qyxbs/smart-library-return-system/7-项目文档/README.md

# 项目文档

> 说明：`report_data.json` 与 `generate_diagrams.py` 是 2026-07 技术报告的快照/生成脚本，其中的技术栈描述反映当时实现；当前主控为 C++ 实现（见 `1-RK3566-主控/cpp/`）。

## 文档索引

| 文档 | 说明 |
|---|---|
| `系统架构说明.md` | 三芯异构边端协同架构、软件分层、数据流设计 |
| `通信协议规范.md` | K230 ↔ RK3566 ↔ STM32 全链路文本行协议、CRC4 校验、坐标映射 |
| `部署指南.md` | 硬件接线、供电架构、软件部署步骤、启动顺序、验证方法 |

## 辅助工具

| 文件 | 说明 |
|---|---|
| `generate_diagrams.py` | SVG 架构图生成脚本 |
| `report_builder.py` | 技术报告自动构建工具（基于 report_data.json） |
| `report_data.json` | 技术报告数据文件 |

## 系统架构速览

```
┌──────────────┐     TCP :9998      ┌──────────────┐     TCP :9999      ┌──────────────┐
│  K230 #1     │ ──── QR 扫码 ────▶ │   RK3566     │ ──── 坐标指令 ──▶ │  K230 #2     │
│  RT-Smart    │                    │   Linux      │                    │  RT-Smart    │
└──────────────┘                    │ C++ HTTP 服务 │                    └──────┬───────┘
                                    │   SQLite     │                    UART2 │
                                    └──────┬───────┘                    STM32 │
                                    UART4/5│                                  │
                                           ▼                                  ▼
                                   ┌──────────────┐    Zigbee     ┌──────────────────┐
                                   │ STM32F407    │ ────广播────▶ │ STM32F103 ×3     │
                                   │ RT-Thread    │               │ RT-Thread        │
                                   │ 主控         │               │ 推书/机械爪/三轴   │
                                   └──────────────┘               └──────────────────┘
```

**三芯异构**：RK3566 (Linux, AI 推理) + K230 ×2 (RT-Smart, 视觉感知) + STM32 ×4 (RT-Thread, 实时控制)

**语音链路**：本地 SenseVoice ASR + 云端 DeepSeek 提取书名/分类；未命中时降级为关键词规则

**分布式控制**：Zigbee 广播 + RS485 总线，7 路步进电机，硬实时毫秒级响应
