qyxbs/smart-library-return-system/6-硬件设计/README.md

# 硬件设计

## 机械结构 (`机械/`)

138 个 SolidWorks 建模文件，按设计迭代日期组织（5月18日 — 7月7日），覆盖 34 个设计节点。

### 文件格式

| 格式 | 用途 |
|---|---|
| `.SLDPRT` | SolidWorks 零件文件 |
| `.SLDASM` | SolidWorks 装配体文件 |
| `.STEP` | 通用 CAD 交换格式（推荐外部查看） |
| `.3mf` / `.STL` | 3D 打印格式 |

### 主要部件

| 部件 | 覆盖日期 | 说明 |
|---|---|---|
| 书架结构 | 5月18日 — 6月30日 | 琴立式书架、挡板、支撑件、防乱跑结构 |
| 推书装置 | 5月25日 — 6月11日 | 推书机构、舵机改直线齿轮 |
| 机械爪/夹子 | 5月18日 — 6月29日 | 夹子限位、电机壳、舵机固定 |
| 三轴运动 | 6月23日 — 6月26日 | 左右横移电机、水平移电机壳、双支撑 |
| K230 外壳 | 5月31日 — 6月23日 | K230 盖子、三鹿保护壳、夹子壳 |
| RK3566 外壳 | 6月28日 | Linux 壳子、芯片固定 |
| 屏幕壳 | 5月21日 — 6月15日 | 屏幕外壳多版迭代 |
| 扫码结构 | 6月26日 — 7月1日 | 扫码方框挡板、扫码板子 |
| 打印机/红外 | 7月2日 — 7月3日 | 打印机支架、红外壳、信号挡板 |
| 其他 | 5月19日 — 7月3日 | 弹簧、圆环、Zigbee 支撑、收纳、垫片 |

### 查看方式

推荐使用以下免费工具查看 `.STEP` 文件：
- [FreeCAD](https://www.freecad.org/)
- [eDrawings Viewer](https://www.edrawingsviewer.com/)
- [Autodesk Viewer](https://viewer.autodesk.com/) (在线)

`.SLDPRT` / `.SLDASM` 文件需 SolidWorks 2022+ 打开。

## 电路设计 (`电路/`)

电路设计文件（原理图、PCB、接线图）正在整理中。

### 供电架构

```
220V AC → 200W 变压器 → 12V DC
  → 各电路板隔离电源
  → RK3566 (USB-C 5V)
  → K230 ×2 (USB-C 5V)
  → USB 有源 Hub (外接 5V 供电)
```

### 关键注意事项

- USB 有源 Hub 必须外接 5V 供电，否则 WiFi 高负载时电压跌落会导致系统复位
- 无线串口模块用于 RK3566 ↔ STM32 通信，替代有线连接
- CC2530 Zigbee 模块实现 STM32 主控与子控间的无线广播

## 相关文档

- 部署指南中的接线说明：`../7-项目文档/部署指南.md`
- 通信协议中的 UART 引脚分配：`../7-项目文档/通信协议规范.md`
