qyxbs/smart-library-return-system/6-硬件设计/机械/5月18/零件5^科技挡板.STEP

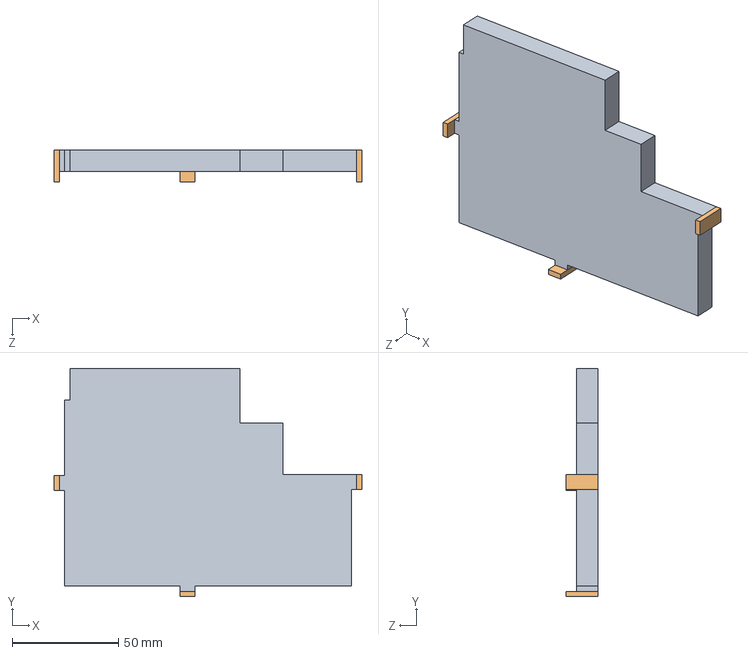
[picture p8: CAD file, 2026-07-08]
6-硬件设计/机械/5月18/零件5^科技挡板.STEP
145.0 x 107.5 x 15.0 mm
