qyxbs/smart-library-return-system/6-硬件设计/机械/5月19号/弹簧.STEP

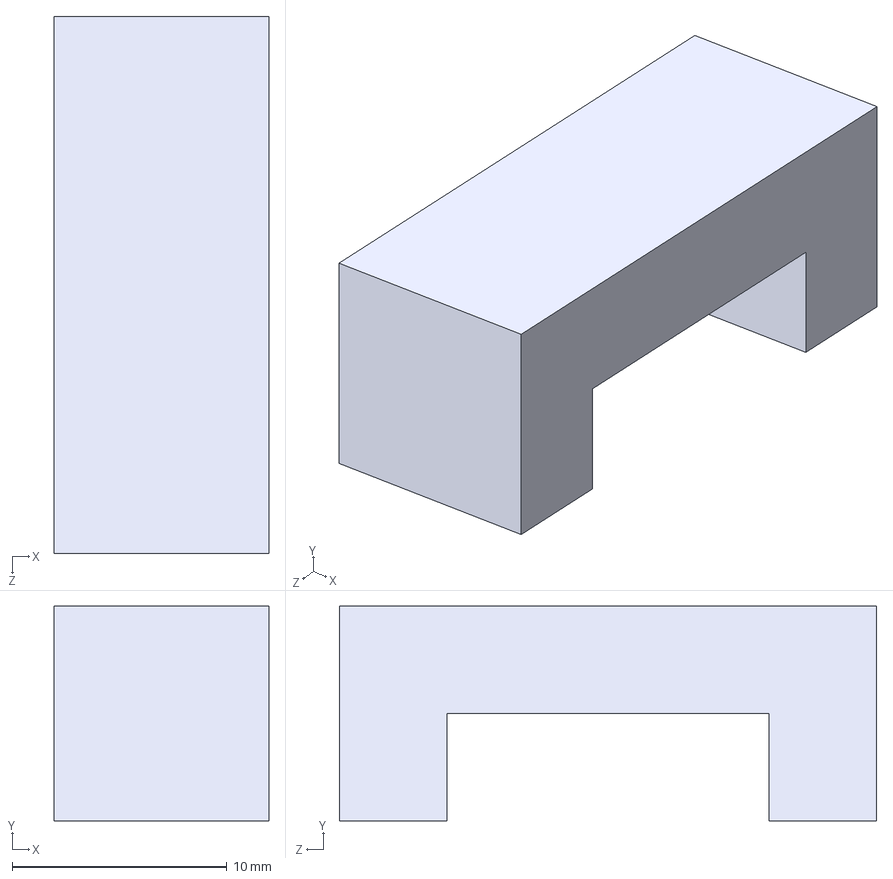
[picture p9: CAD file, 2026-07-08]
6-硬件设计/机械/5月19号/弹簧.STEP
10.0 x 10.00 x 25.0 mm
