qyxbs/smart-library-return-system/6-硬件设计/机械/5月21日/圆环.STEP

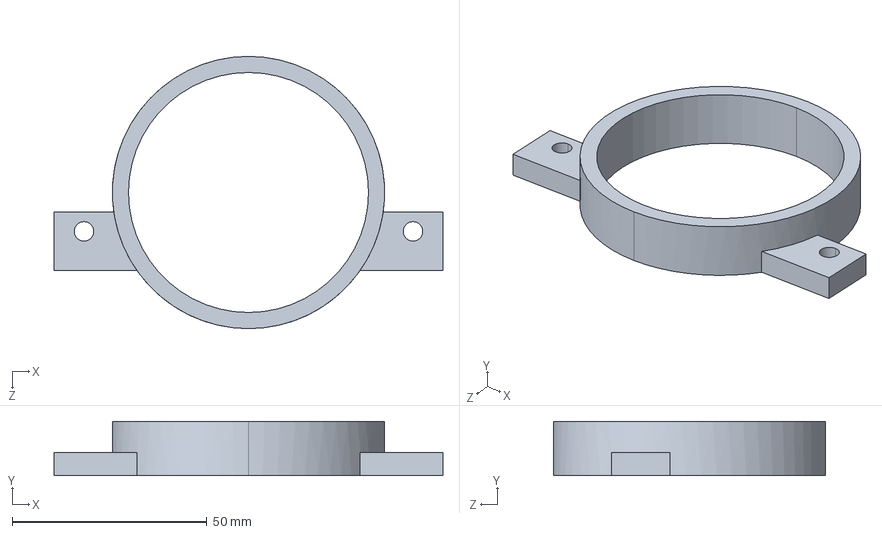
[picture p10: CAD file, 2026-07-08]
6-硬件设计/机械/5月21日/圆环.STEP
100.0 x 14.0 x 70.0 mm
