qyxbs/smart-library-return-system/6-硬件设计/机械/5月22日/将总的主子.STEP

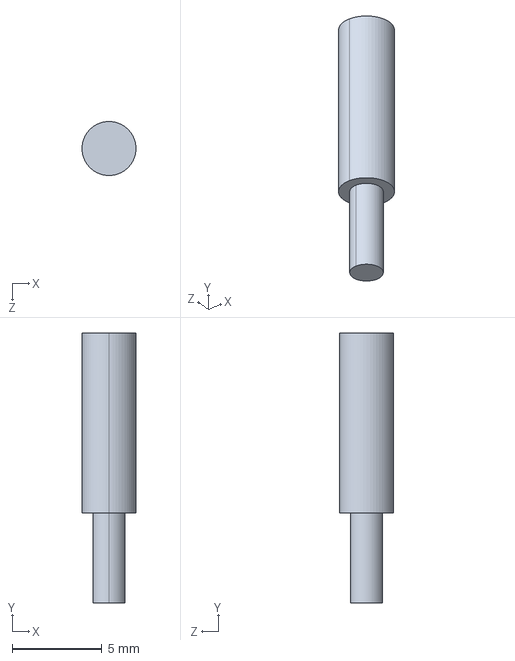
[picture p11: CAD file, 2026-07-08]
6-硬件设计/机械/5月22日/将总的主子.STEP
3.00 x 15.0 x 3.00 mm
