qyxbs/smart-library-return-system/6-硬件设计/机械/5月25日/零件1.SLDPRT

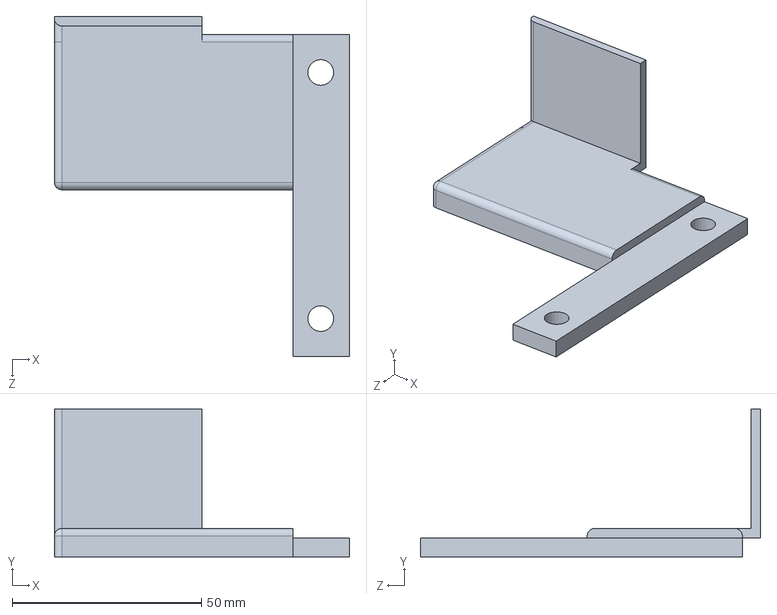
[picture p12: CAD file, 2026-07-08]
6-硬件设计/机械/5月25日/零件1.SLDPRT
78.0 x 39.0 x 89.8 mm
