qyxbs/smart-library-return-system/6-硬件设计/机械/5月27日/旁边的收纳.STEP

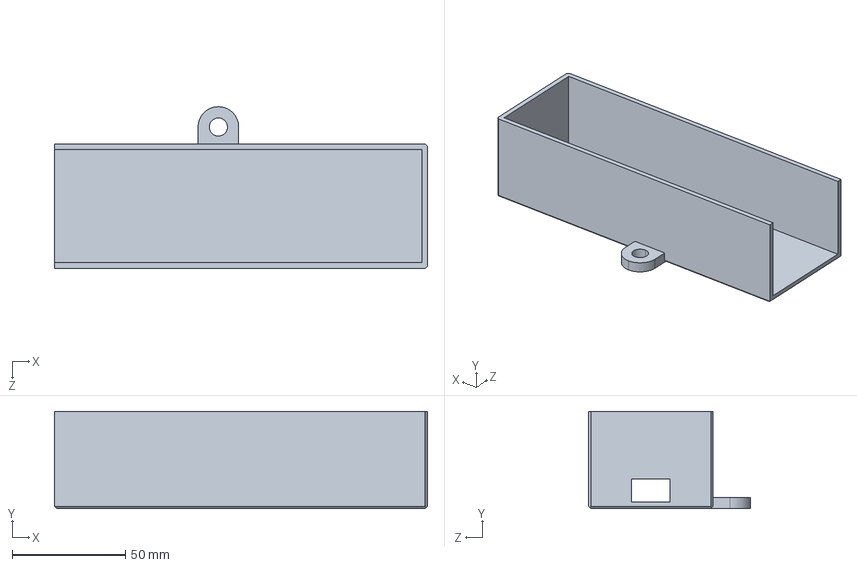
[picture p13: CAD file, 2026-07-08]
6-硬件设计/机械/5月27日/旁边的收纳.STEP
165.0 x 43.0 x 71.5 mm
