qyxbs/smart-library-return-system/6-硬件设计/机械/5月29日/零件5^科技挡板.STEP

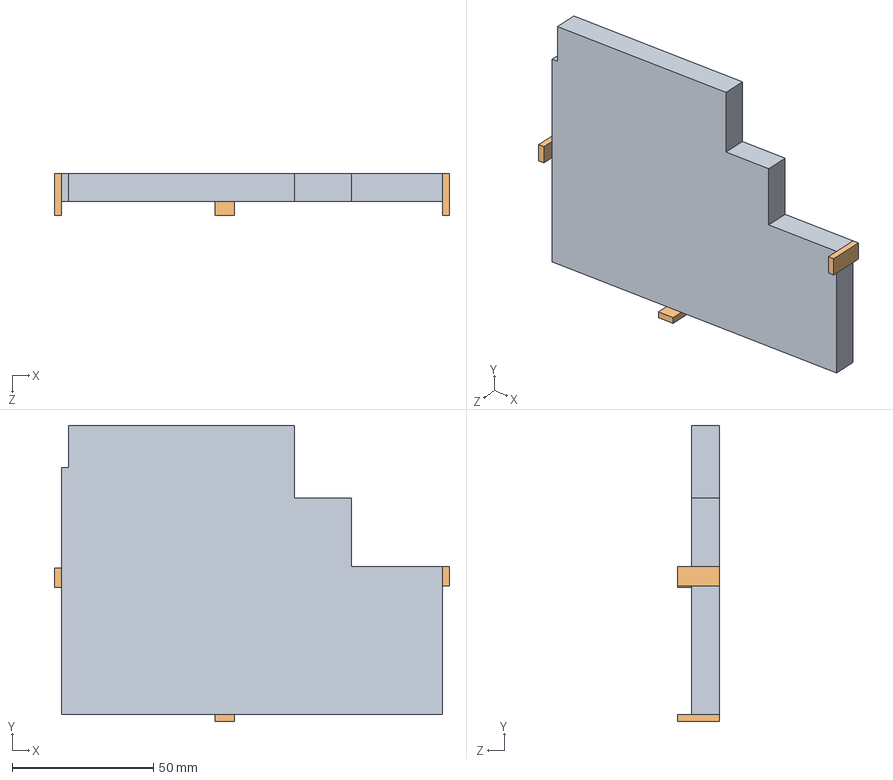
[picture p14: CAD file, 2026-07-08]
6-硬件设计/机械/5月29日/零件5^科技挡板.STEP
140.0 x 105.0 x 15.0 mm
