qyxbs/smart-library-return-system/6-硬件设计/机械/5月31日/k230盖子.STEP

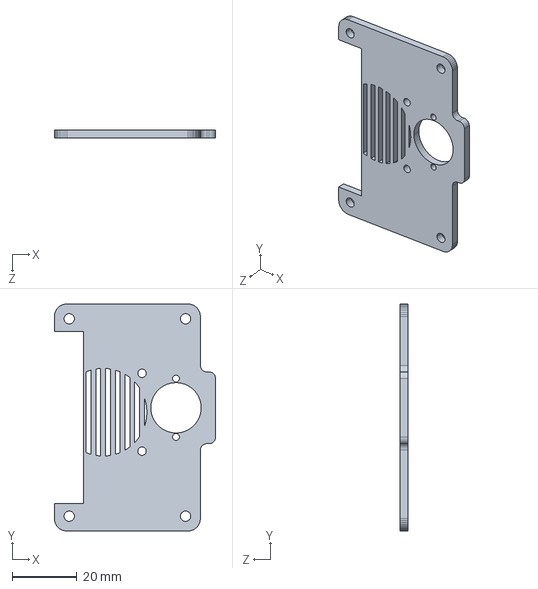
[picture p15: CAD file, 2026-07-08]
6-硬件设计/机械/5月31日/k230盖子.STEP
49.7 x 70.0 x 2.50 mm
