qyxbs/smart-library-return-system/6-硬件设计/机械/6月10号/6月10号.STEP

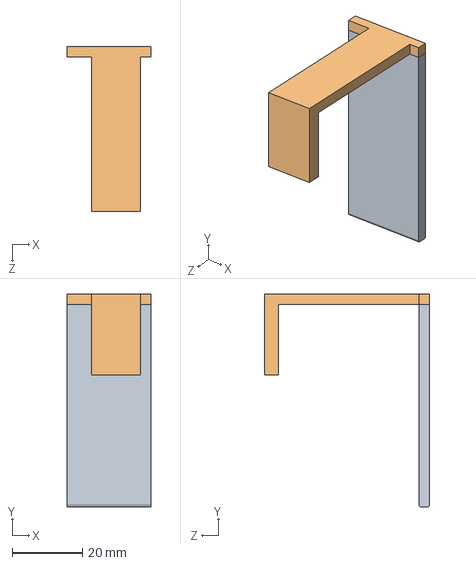
[picture p16: CAD file, 2026-07-08]
6-硬件设计/机械/6月10号/6月10号.STEP
24.0 x 60.7 x 47.1 mm
