qyxbs/smart-library-return-system/6-硬件设计/机械/6月11日/挡板.3mf

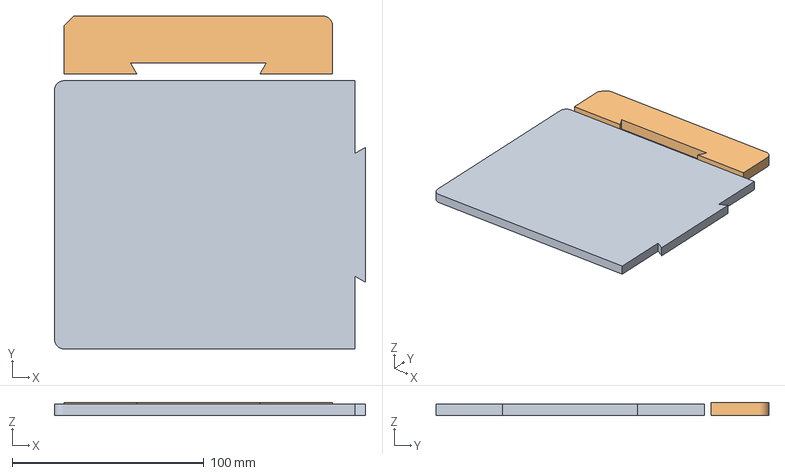
[picture p17: CAD file, 2026-07-08]
6-硬件设计/机械/6月11日/挡板.3mf
162.3 x 173.7 x 7.00 mm
挡板.STEP_A
挡板.STEP_B
