qyxbs/smart-library-return-system/6-硬件设计/机械/6月13日/雷达字.STEP

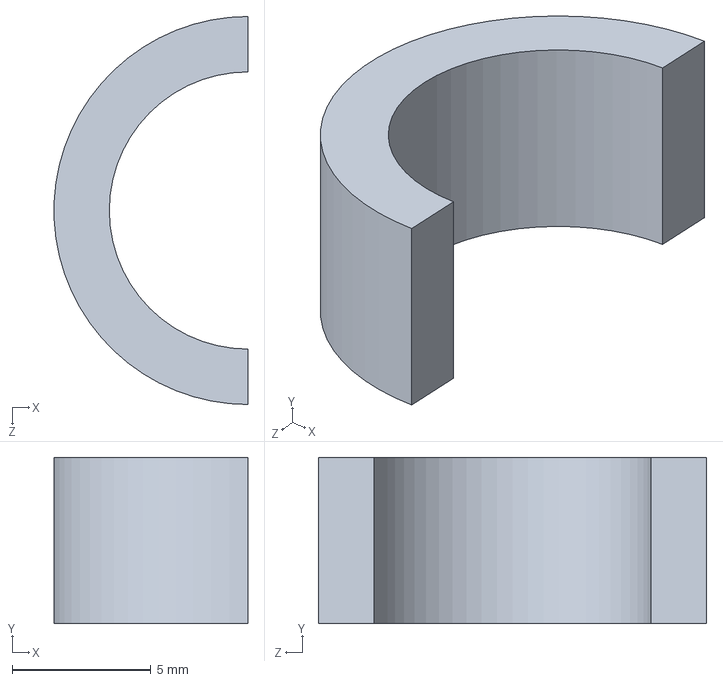
[picture p18: CAD file, 2026-07-08]
6-硬件设计/机械/6月13日/雷达字.STEP
6.99 x 6.00 x 14.0 mm
