qyxbs/smart-library-return-system/6-硬件设计/机械/6月15日/屏幕壳.STEP

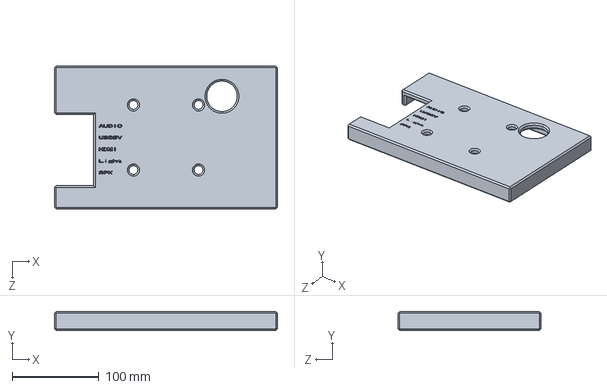
[picture p19: CAD file, 2026-07-08]
6-硬件设计/机械/6月15日/屏幕壳.STEP
257.0 x 22.0 x 165.0 mm
