qyxbs/smart-library-return-system/6-硬件设计/机械/6月16日/挡板.STEP

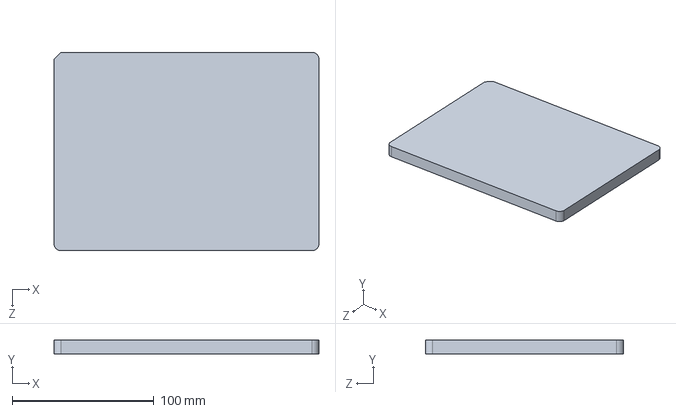
[picture p20: CAD file, 2026-07-08]
6-硬件设计/机械/6月16日/挡板.STEP
187.0 x 10.0 x 140.0 mm
