qyxbs/smart-library-return-system/6-硬件设计/机械/6月19日/零件2^三鹿保护壳.3mf

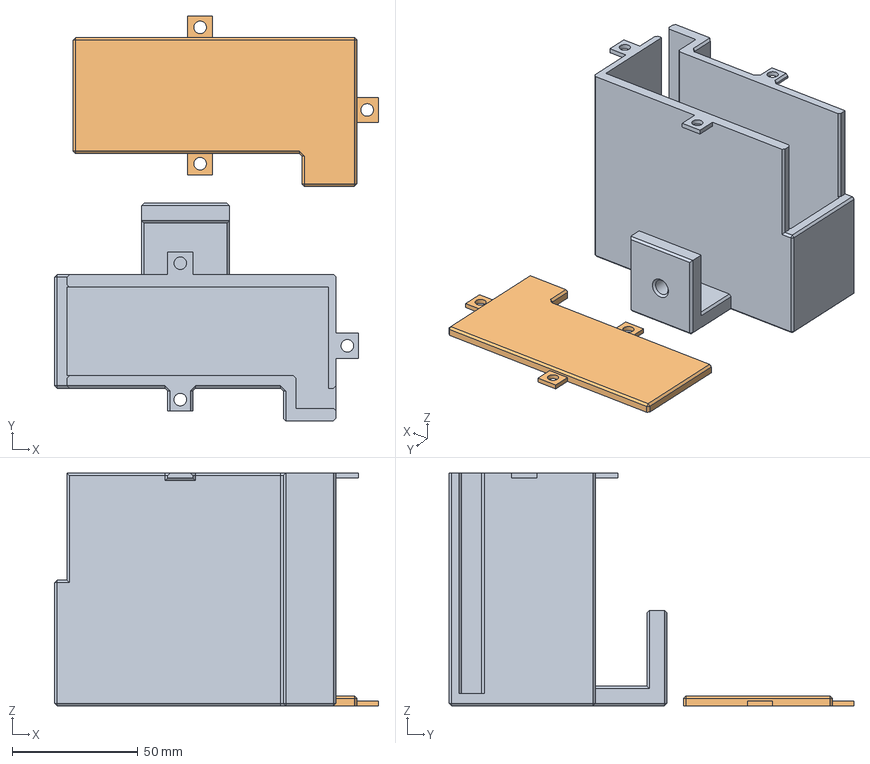
[picture p21: CAD file, 2026-07-08]
6-硬件设计/机械/6月19日/零件2^三鹿保护壳.3mf
128.9 x 161.1 x 92.6 mm
零件2^三鹿保护壳
零件4^三鹿保护壳
