qyxbs/smart-library-return-system/6-硬件设计/机械/6月1日/舵机改直线下齿轮1.STEP

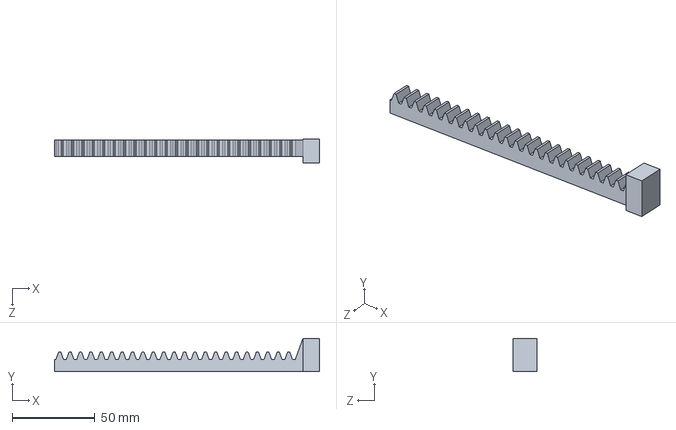
[picture p22: CAD file, 2026-07-08]
6-硬件设计/机械/6月1日/舵机改直线下齿轮1.STEP
160.0 x 20.2 x 14.5 mm
