qyxbs/smart-library-return-system/6-硬件设计/机械/6月20日/电机壳.STEP

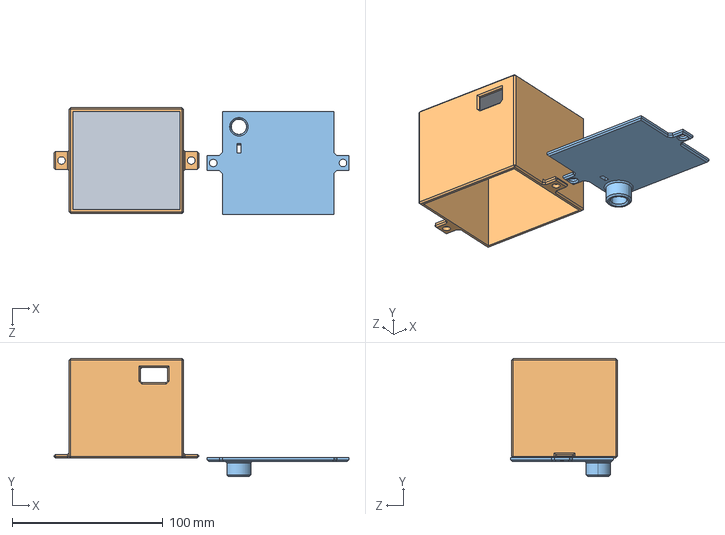
[picture p23: CAD file, 2026-07-08]
6-硬件设计/机械/6月20日/电机壳.STEP
195.6 x 78.2 x 70.6 mm
电机壳
零件1^电机壳
