qyxbs/smart-library-return-system/6-硬件设计/机械/6月22日/三鹿夹子壳.STEP

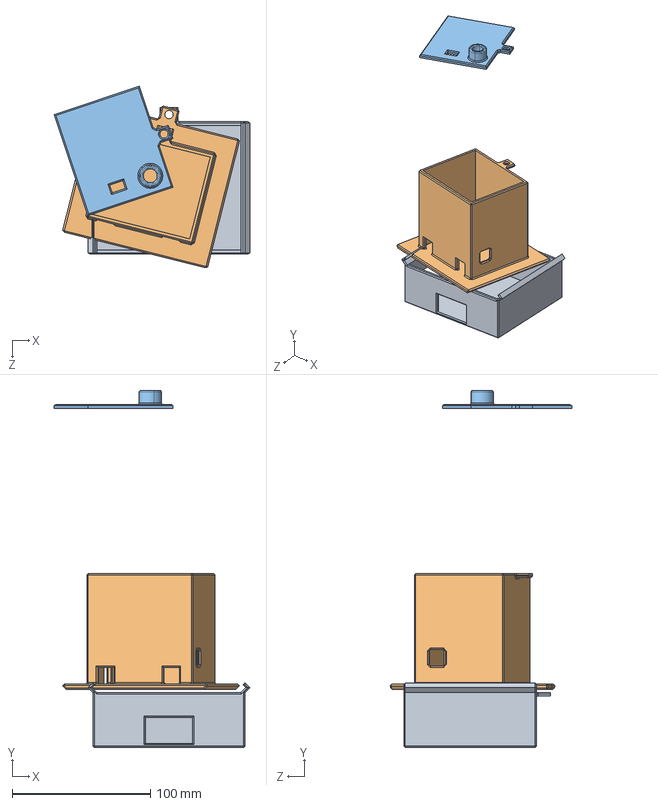
[picture p24: CAD file, 2026-07-08]
6-硬件设计/机械/6月22日/三鹿夹子壳.STEP
141.6 x 258.3 x 131.4 mm
零件2^三鹿夹子壳
零件3^三鹿夹子壳
零件4^三鹿夹子壳
