qyxbs/smart-library-return-system/6-硬件设计/机械/6月24日/双支持.STEP

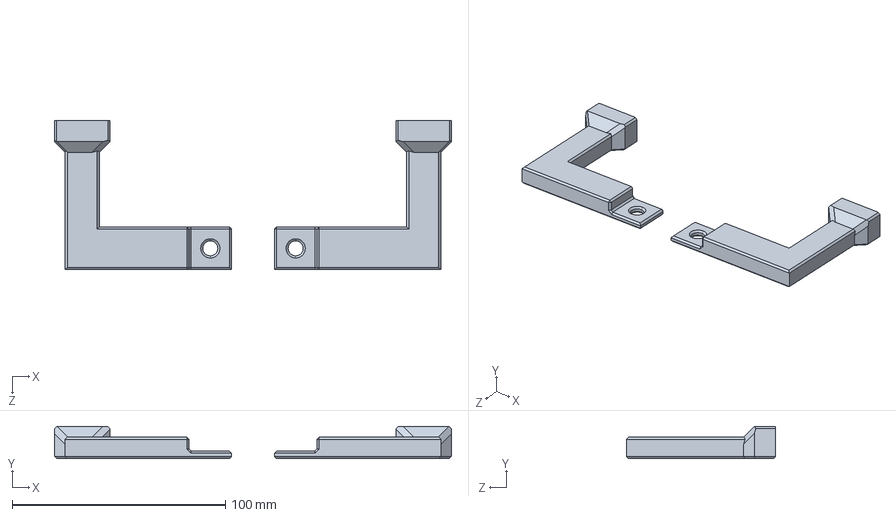
[picture p25: CAD file, 2026-07-08]
6-硬件设计/机械/6月24日/双支持.STEP
186.0 x 15.0 x 70.0 mm
支撑电机
Mirror支撑电机
