qyxbs/smart-library-return-system/6-硬件设计/机械/6月25日/左右横移电机.SLDPRT

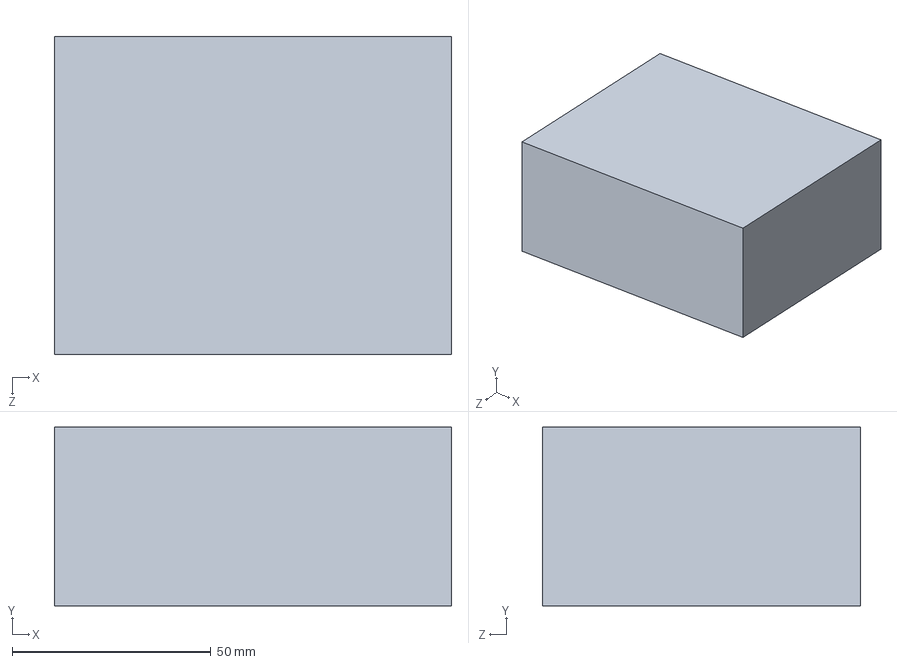
[picture p26: CAD file, 2026-07-08]
6-硬件设计/机械/6月25日/左右横移电机.SLDPRT
100.0 x 45.0 x 80.0 mm
