qyxbs/smart-library-return-system/6-硬件设计/机械/6月26日/left and right.STEP

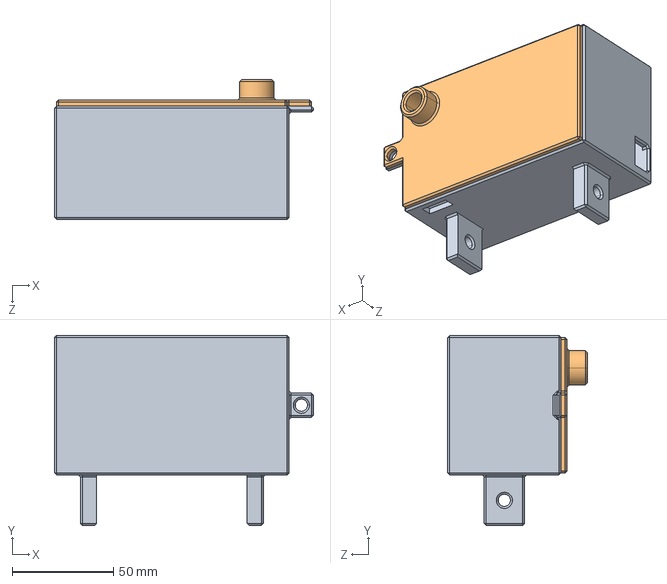
[picture p27: CAD file, 2026-07-08]
6-硬件设计/机械/6月26日/left and right.STEP
128.0 x 94.0 x 69.0 mm
零件3^left and right
零件4^left and right
