qyxbs/smart-library-return-system/6-硬件设计/机械/6月27日/固定.STEP

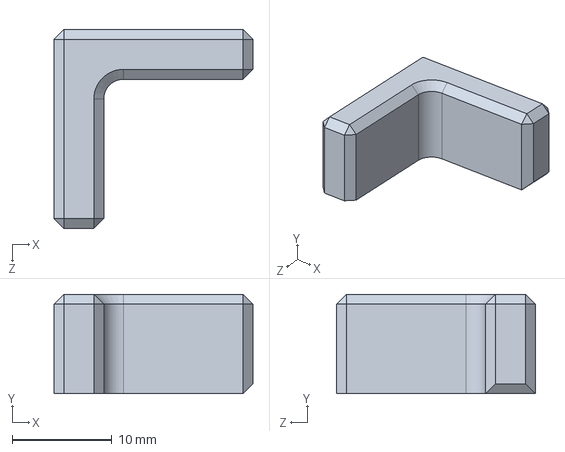
[picture p28: CAD file, 2026-07-08]
6-硬件设计/机械/6月27日/固定.STEP
20.0 x 10.0 x 20.0 mm
