qyxbs/smart-library-return-system/6-硬件设计/机械/6月28日/芯片.SLDPRT

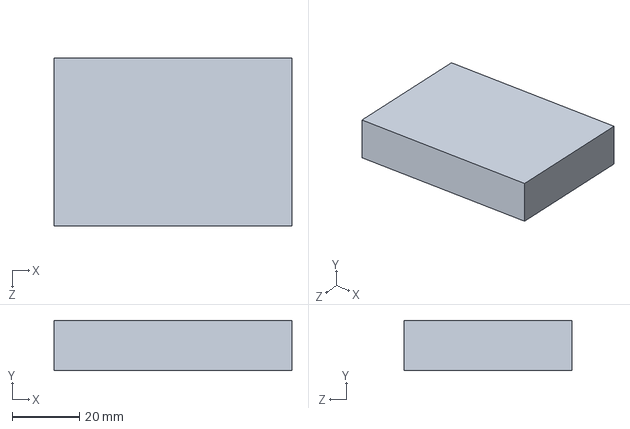
[picture p29: CAD file, 2026-07-08]
6-硬件设计/机械/6月28日/芯片.SLDPRT
71.0 x 15.0 x 50.0 mm
