qyxbs/smart-library-return-system/6-硬件设计/机械/6月29日/垫片.STEP

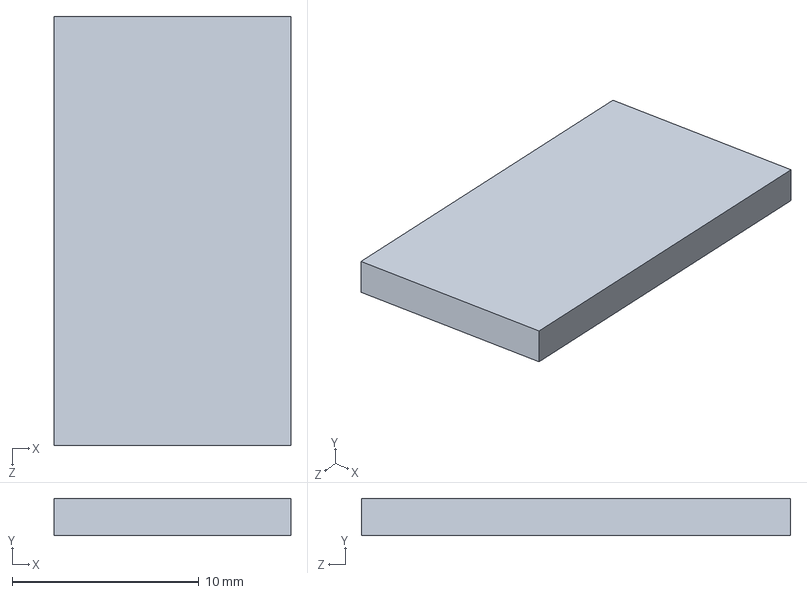
[picture p30: CAD file, 2026-07-08]
6-硬件设计/机械/6月29日/垫片.STEP
12.7 x 2.00 x 23.0 mm
