qyxbs/smart-library-return-system/6-硬件设计/机械/6月30日/书架防乱跑.STEP

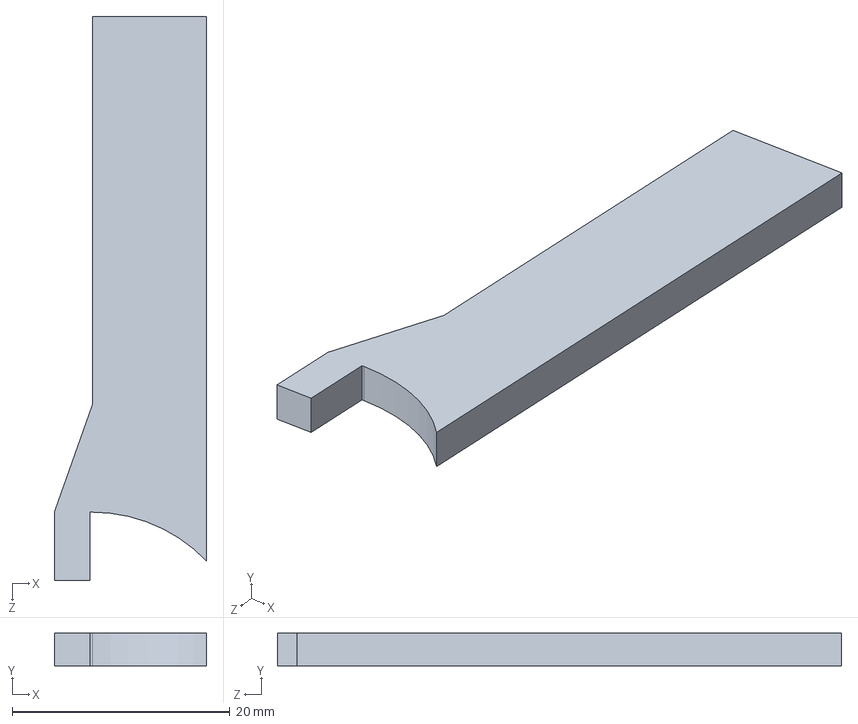
[picture p31: CAD file, 2026-07-08]
6-硬件设计/机械/6月30日/书架防乱跑.STEP
14.0 x 3.00 x 51.8 mm
