qyxbs/smart-library-return-system/6-硬件设计/机械/6月4日/zigbee支撑.STEP

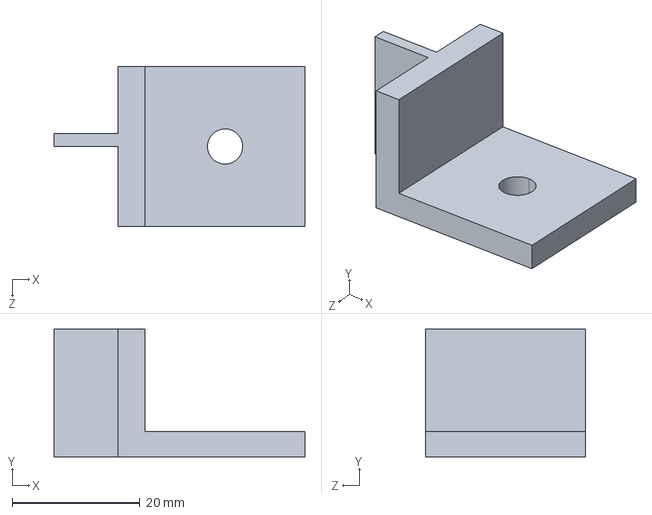
[picture p32: CAD file, 2026-07-08]
6-硬件设计/机械/6月4日/zigbee支撑.STEP
39.2 x 20.0 x 25.0 mm
