qyxbs/smart-library-return-system/6-硬件设计/机械/6月5日/挡板.STEP

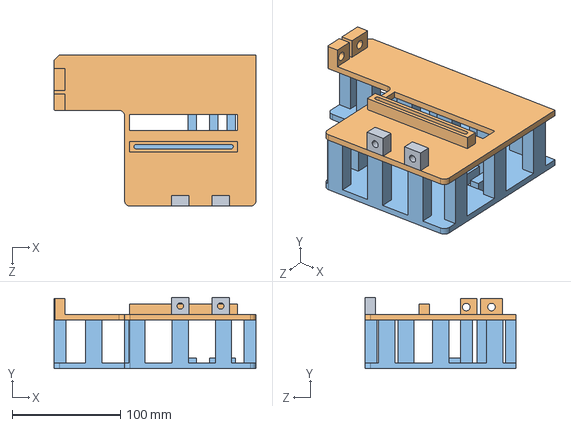
[picture p33: CAD file, 2026-07-08]
6-硬件设计/机械/6月5日/挡板.STEP
187.0 x 66.0 x 140.0 mm
挡板plus
零件4^挡板
