qyxbs/smart-library-return-system/6-硬件设计/机械/6月6日/挡板.STEP

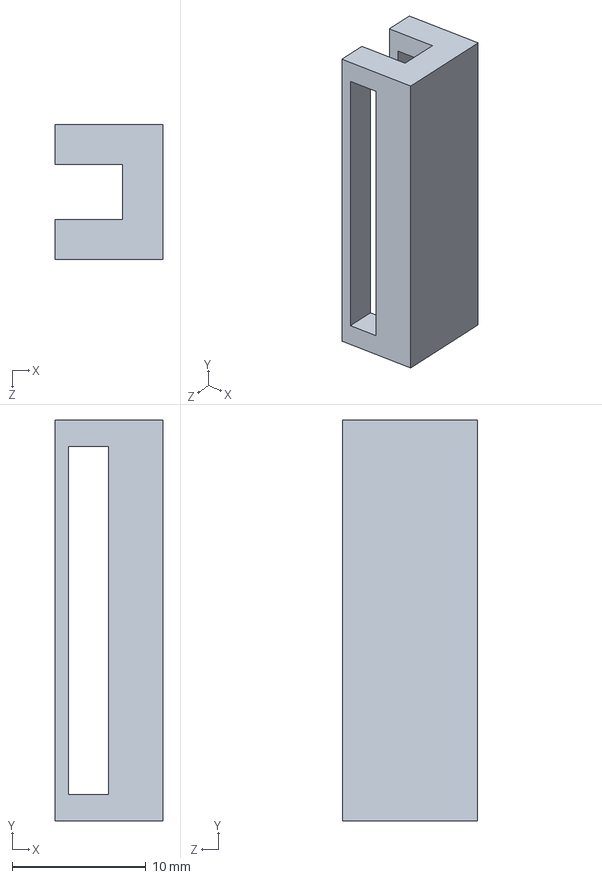
[picture p34: CAD file, 2026-07-08]
6-硬件设计/机械/6月6日/挡板.STEP
8.05 x 30.0 x 10.1 mm
