qyxbs/smart-library-return-system/6-硬件设计/机械/7月1日/扫码板子.SLDPRT

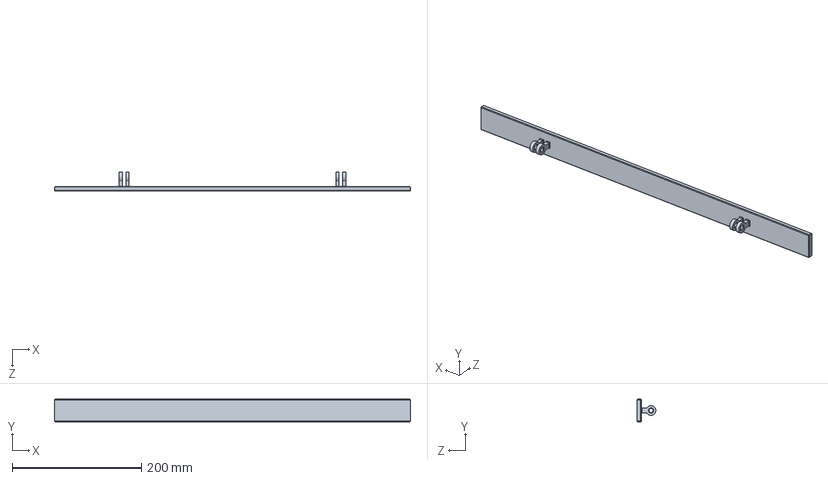
[picture p35: CAD file, 2026-07-08]
6-硬件设计/机械/7月1日/扫码板子.SLDPRT
550.0 x 35.0 x 29.0 mm
