qyxbs/smart-library-return-system/6-硬件设计/机械/7月2日/零件2.STEP

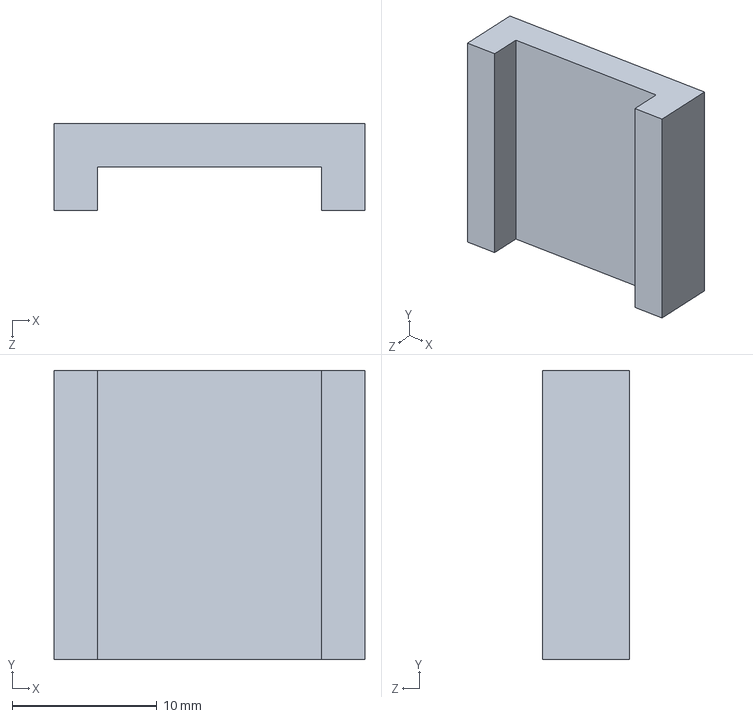
[picture p36: CAD file, 2026-07-08]
6-硬件设计/机械/7月2日/零件2.STEP
21.5 x 20.0 x 6.00 mm
