qyxbs/smart-library-return-system/6-硬件设计/机械/7月3日/打印机.STEP

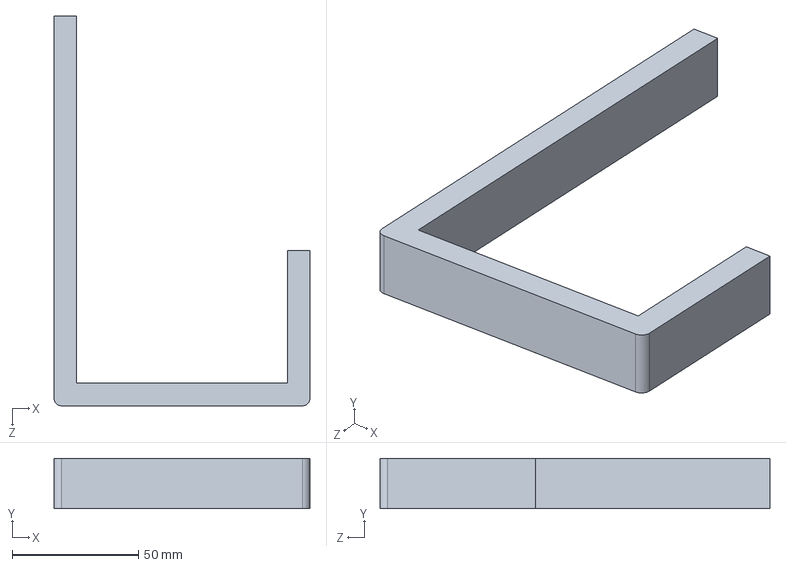
[picture p37: CAD file, 2026-07-08]
6-硬件设计/机械/7月3日/打印机.STEP
101.5 x 20.0 x 154.5 mm
