qyxbs/smart-library-return-system/6-硬件设计/机械/7月7日/斜支撑.STEP

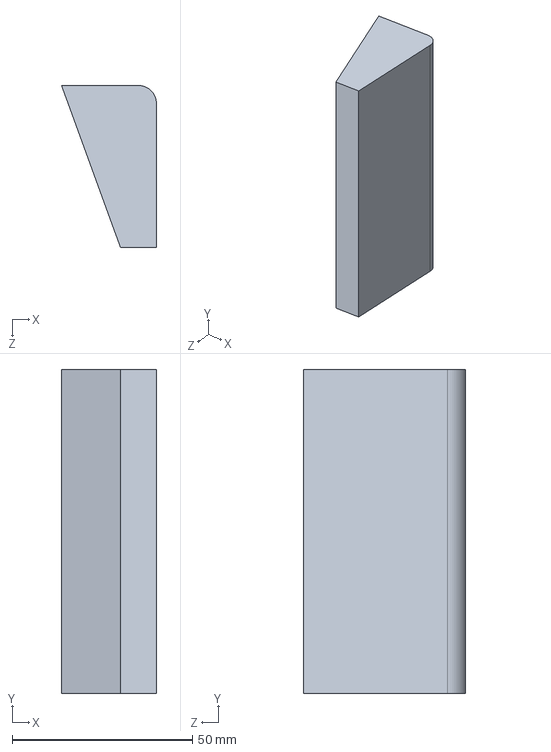
[picture p38: CAD file, 2026-07-08]
6-硬件设计/机械/7月7日/斜支撑.STEP
26.4 x 90.0 x 45.0 mm
