qyxbs/smart-library-return-system/6-硬件设计/机械/5月18/下面挡板第二个.STEP

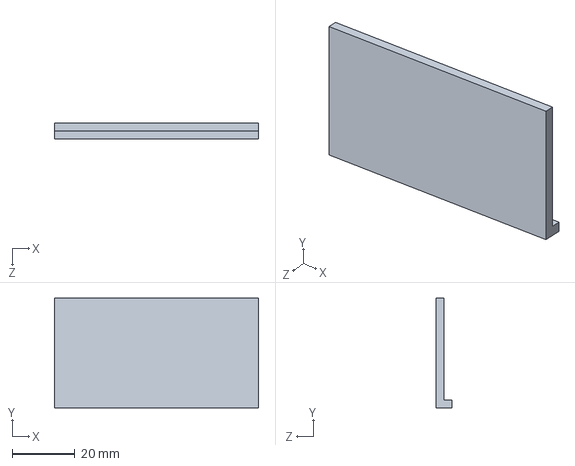
[picture p39: CAD file, 2026-07-08]
6-硬件设计/机械/5月18/下面挡板第二个.STEP
65.0 x 35.0 x 5.00 mm
