qyxbs/smart-library-return-system/6-硬件设计/机械/5月29日/圆环.STEP

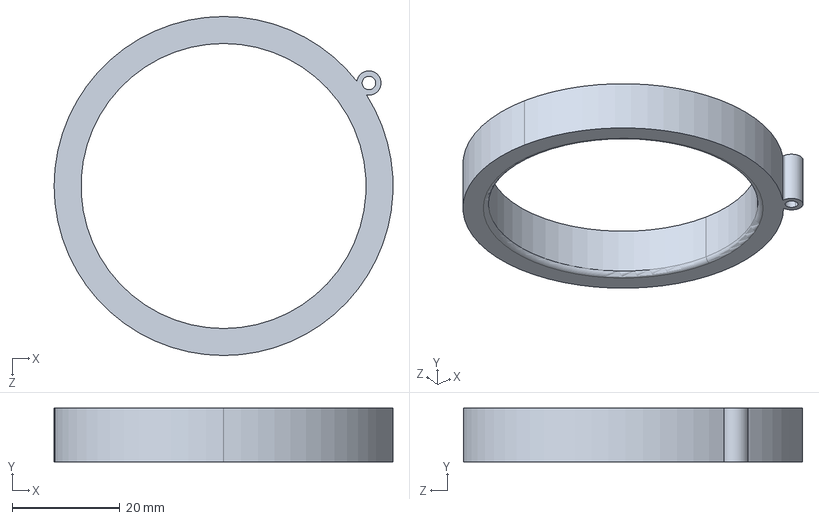
[picture p40: CAD file, 2026-07-08]
6-硬件设计/机械/5月29日/圆环.STEP
62.8 x 10.0 x 62.8 mm
