qyxbs/smart-library-return-system/6-硬件设计/机械/6月10号/摄像头.STEP

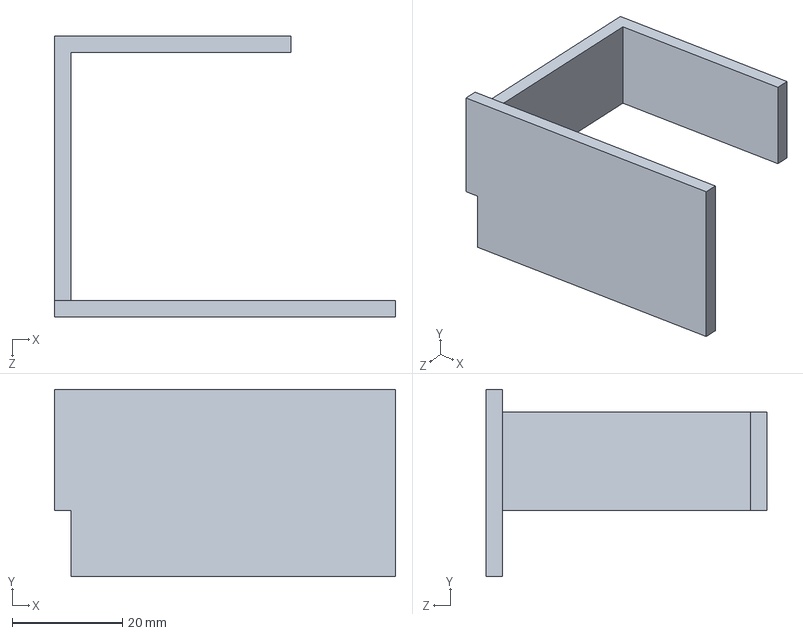
[picture p41: CAD file, 2026-07-08]
6-硬件设计/机械/6月10号/摄像头.STEP
62.0 x 34.0 x 51.0 mm
