qyxbs/smart-library-return-system/6-硬件设计/机械/6月11日/推书.STEP

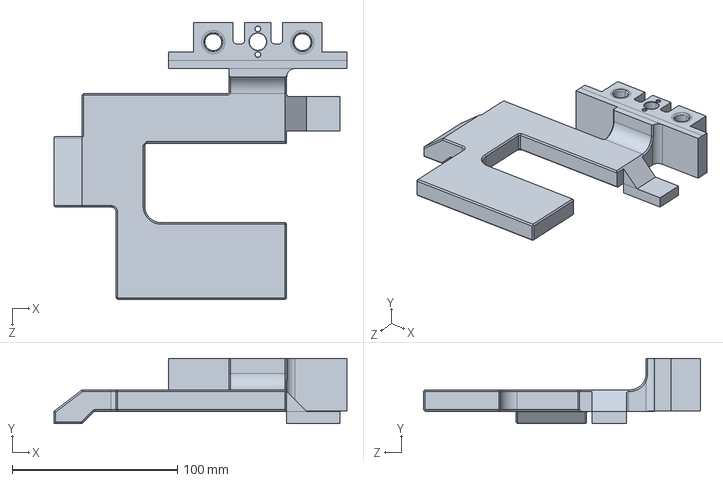
[picture p42: CAD file, 2026-07-08]
6-硬件设计/机械/6月11日/推书.STEP
177.5 x 39.6 x 168.0 mm
