qyxbs/smart-library-return-system/6-硬件设计/机械/6月13日/屏幕壳.3mf

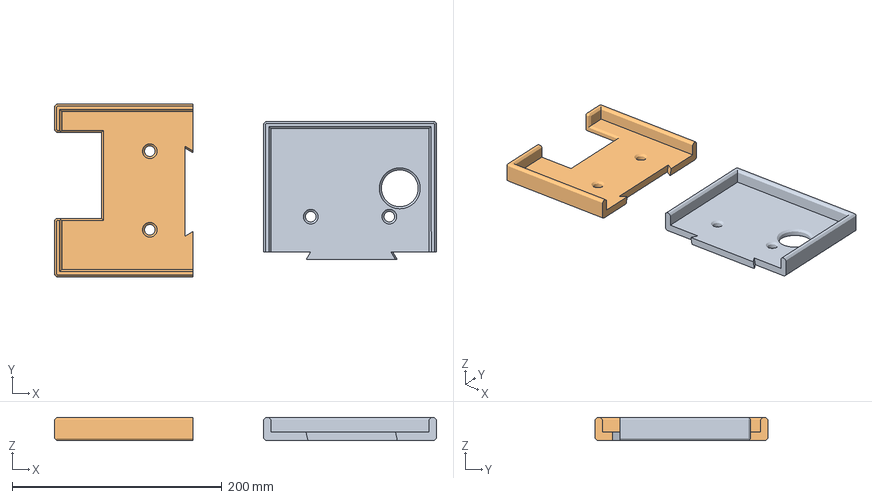
[picture p43: CAD file, 2026-07-08]
6-硬件设计/机械/6月13日/屏幕壳.3mf
364.6 x 165.0 x 22.0 mm
屏幕壳.STEP_A
屏幕壳.STEP_B
