qyxbs/smart-library-return-system/6-硬件设计/机械/6月19日/琴立式书架mvp版.3mf

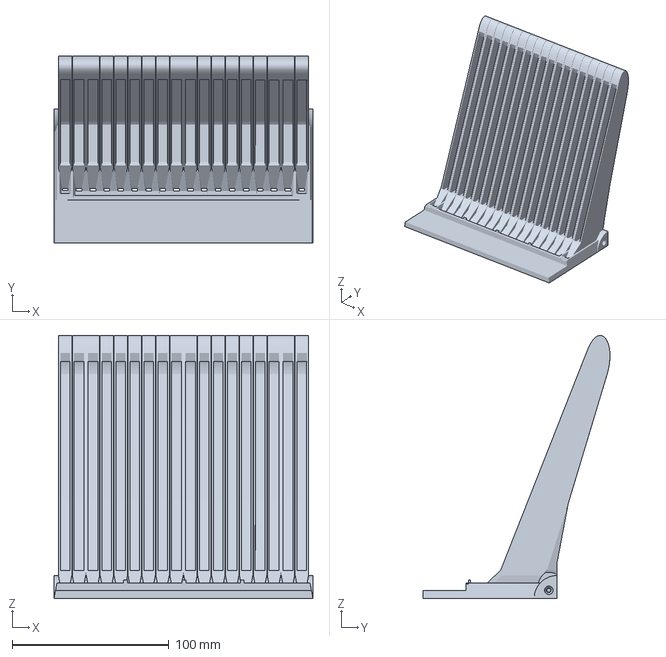
[picture p44: CAD file, 2026-07-08]
6-硬件设计/机械/6月19日/琴立式书架mvp版.3mf
165.5 x 119.5 x 168.1 mm
