qyxbs/smart-library-return-system/6-硬件设计/机械/6月20日/零件1^电机壳.3mf

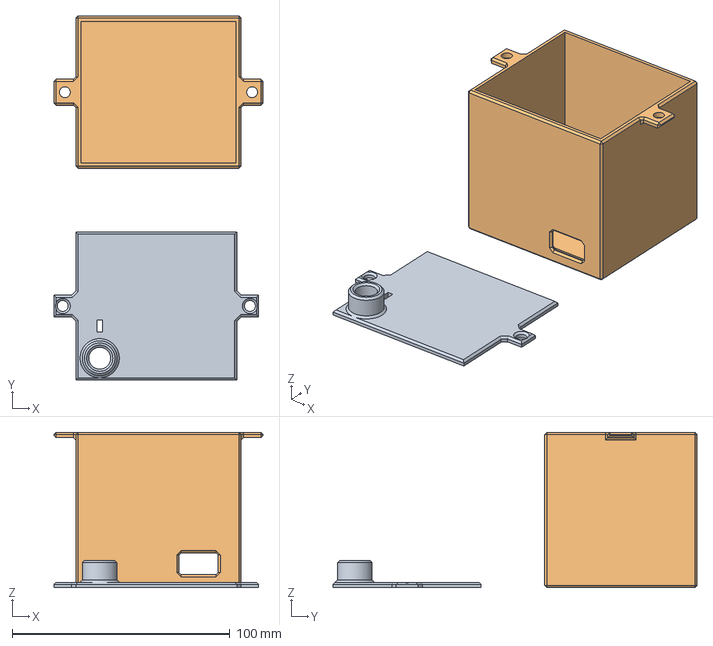
[picture p45: CAD file, 2026-07-08]
6-硬件设计/机械/6月20日/零件1^电机壳.3mf
96.0 x 167.2 x 71.4 mm
零件1^电机壳
组合体
