qyxbs/smart-library-return-system/6-硬件设计/机械/6月23日/电机固定七.STEP

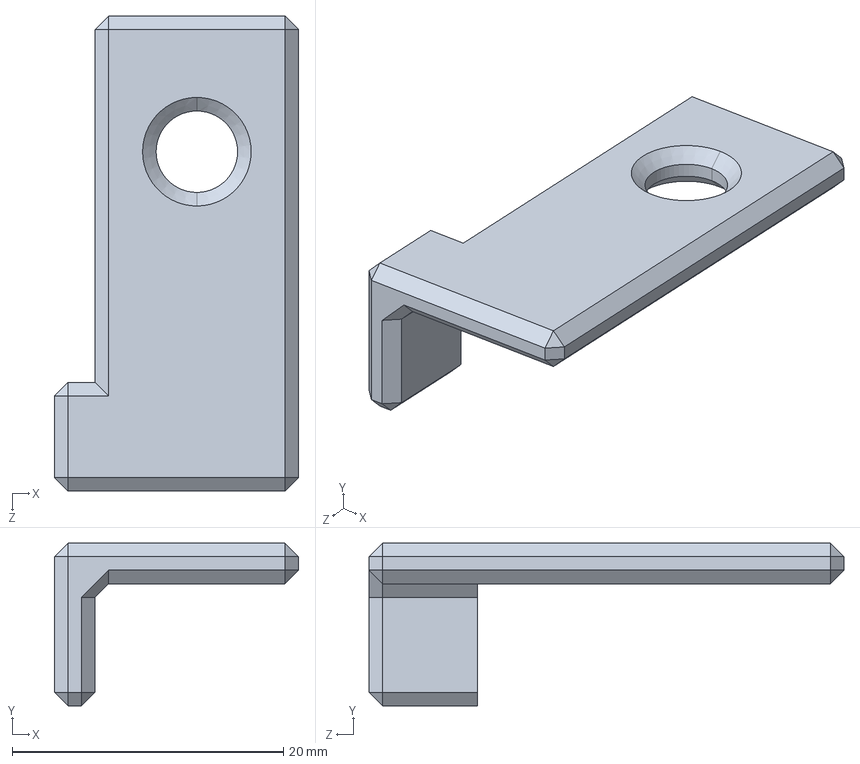
[picture p46: CAD file, 2026-07-08]
6-硬件设计/机械/6月23日/电机固定七.STEP
18.0 x 12.0 x 35.0 mm
