qyxbs/smart-library-return-system/6-硬件设计/机械/6月25日/电线卡口.STEP

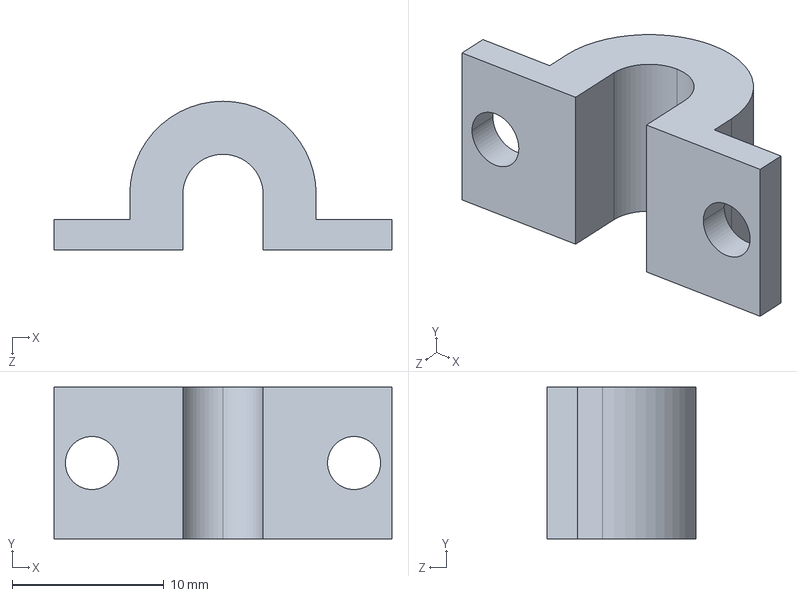
[picture p47: CAD file, 2026-07-08]
6-硬件设计/机械/6月25日/电线卡口.STEP
22.3 x 10.0 x 9.80 mm
