qyxbs/smart-library-return-system/6-硬件设计/机械/6月26日/零件3^left and right.STEP

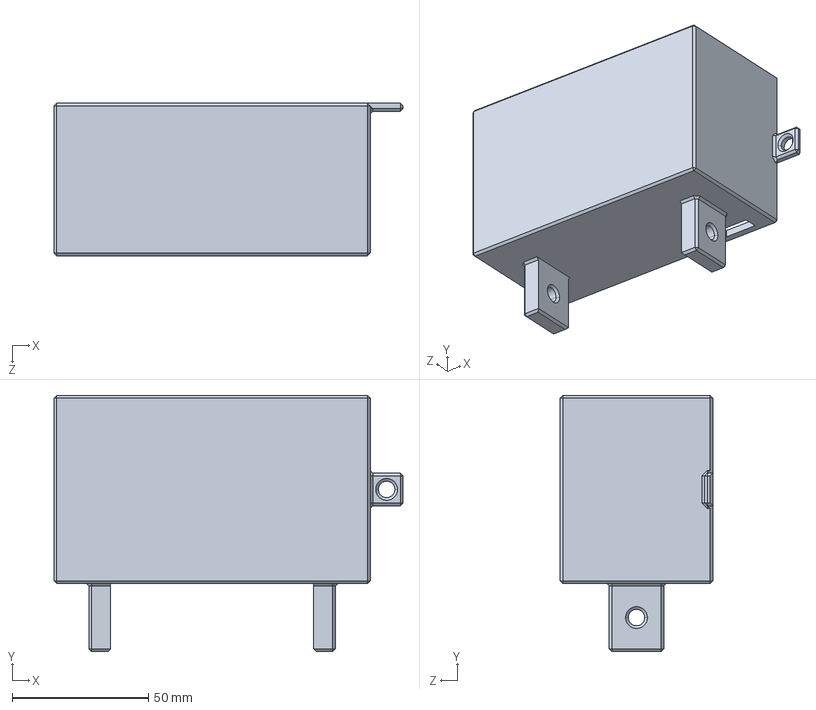
[picture p48: CAD file, 2026-07-08]
6-硬件设计/机械/6月26日/零件3^left and right.STEP
128.0 x 94.0 x 56.0 mm
