qyxbs/smart-library-return-system/6-硬件设计/机械/6月28日/linux壳子.STEP

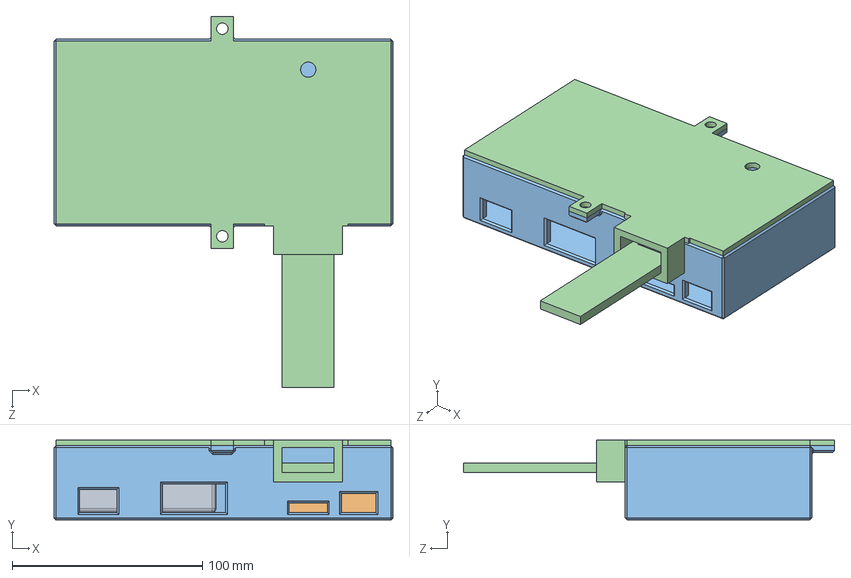
[picture p49: CAD file, 2026-07-08]
6-硬件设计/机械/6月28日/linux壳子.STEP
178.0 x 42.0 x 195.0 mm
黑色摄像头
芯片
零件3^linux壳子
零件4^linux壳子
