qyxbs/smart-library-return-system/6-硬件设计/机械/6月5日/上壳盖子.stl

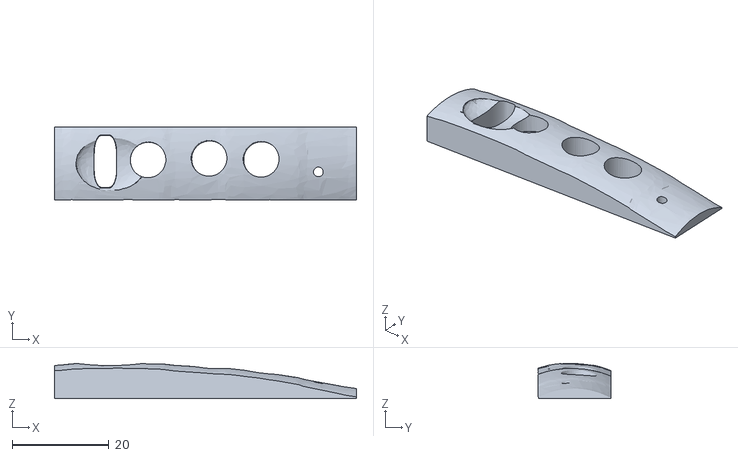
[picture p50: CAD file, 2026-07-08]
6-硬件设计/机械/6月5日/上壳盖子.stl
62.5 x 15.0 x 7.24
