qyxbs/smart-library-return-system/6-硬件设计/机械/7月1日/挡板梓赫梯.STEP

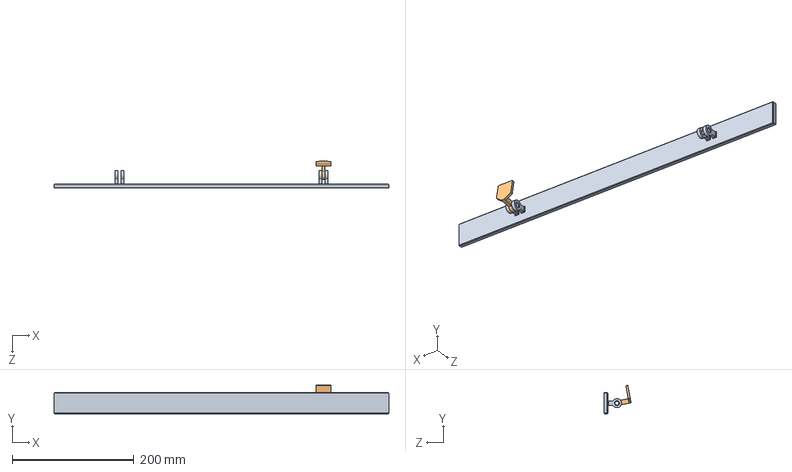
[picture p51: CAD file, 2026-07-08]
6-硬件设计/机械/7月1日/挡板梓赫梯.STEP
550.0 x 47.0 x 44.8 mm
扫码板子
零件2^挡板梓赫梯
