qyxbs/smart-library-return-system/6-硬件设计/机械/7月2日/信号挡板.STEP

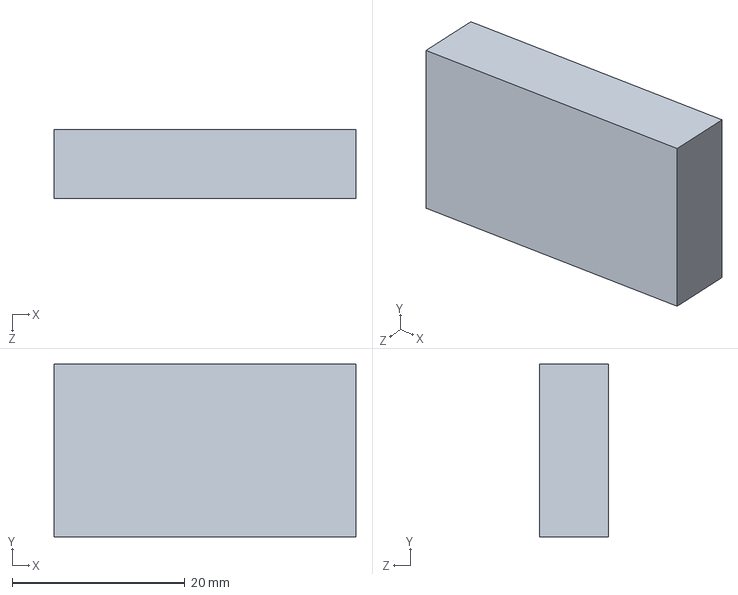
[picture p52: CAD file, 2026-07-08]
6-硬件设计/机械/7月2日/信号挡板.STEP
35.0 x 20.0 x 8.00 mm
