qyxbs/smart-library-return-system/6-硬件设计/机械/7月3日/板子红外.SLDPRT

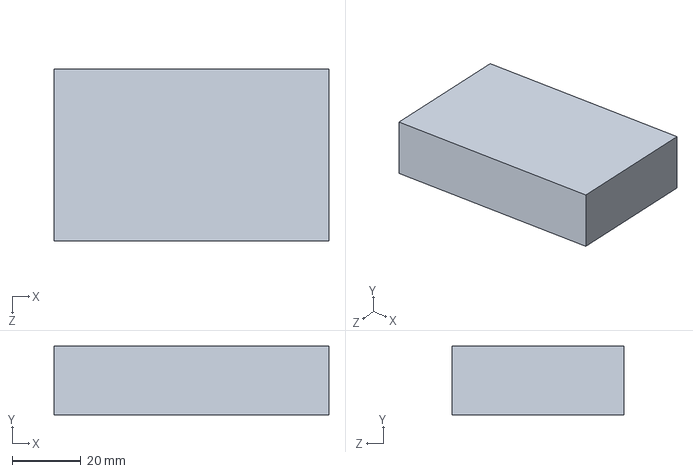
[picture p53: CAD file, 2026-07-08]
6-硬件设计/机械/7月3日/板子红外.SLDPRT
80.0 x 20.0 x 50.0 mm
