qyxbs/smart-library-return-system/6-硬件设计/机械/5月18/斜支撑.STEP

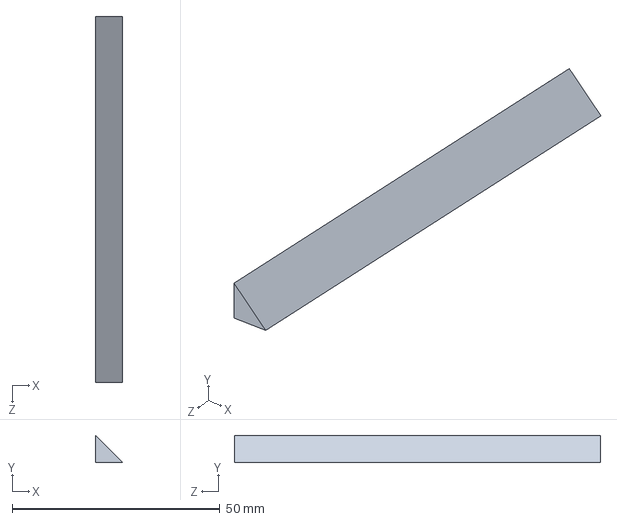
[picture p54: CAD file, 2026-07-08]
6-硬件设计/机械/5月18/斜支撑.STEP
6.50 x 6.50 x 88.0 mm
