qyxbs/smart-library-return-system/6-硬件设计/机械/5月21日/屏幕实体.SLDPRT

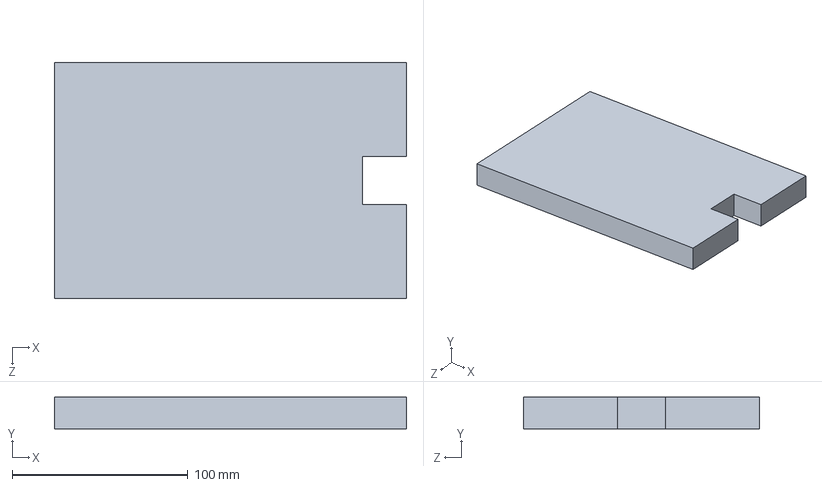
[picture p55: CAD file, 2026-07-08]
6-硬件设计/机械/5月21日/屏幕实体.SLDPRT
200.1 x 18.0 x 133.9 mm
