qyxbs/smart-library-return-system/6-硬件设计/机械/5月25日/舵机改直线下齿轮1.STEP

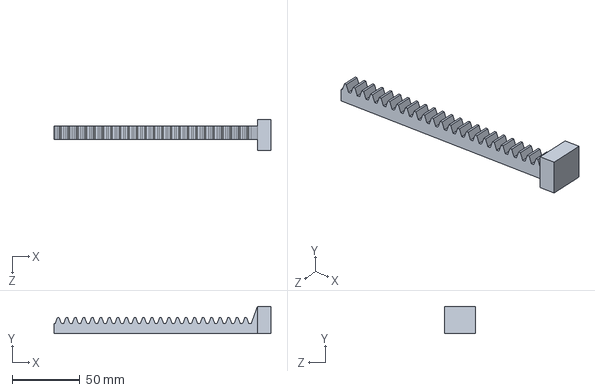
[picture p56: CAD file, 2026-07-08]
6-硬件设计/机械/5月25日/舵机改直线下齿轮1.STEP
160.0 x 20.2 x 23.0 mm
