qyxbs/smart-library-return-system/6-硬件设计/机械/6月11日/零件4^两侧侧电机壳上盖.3mf

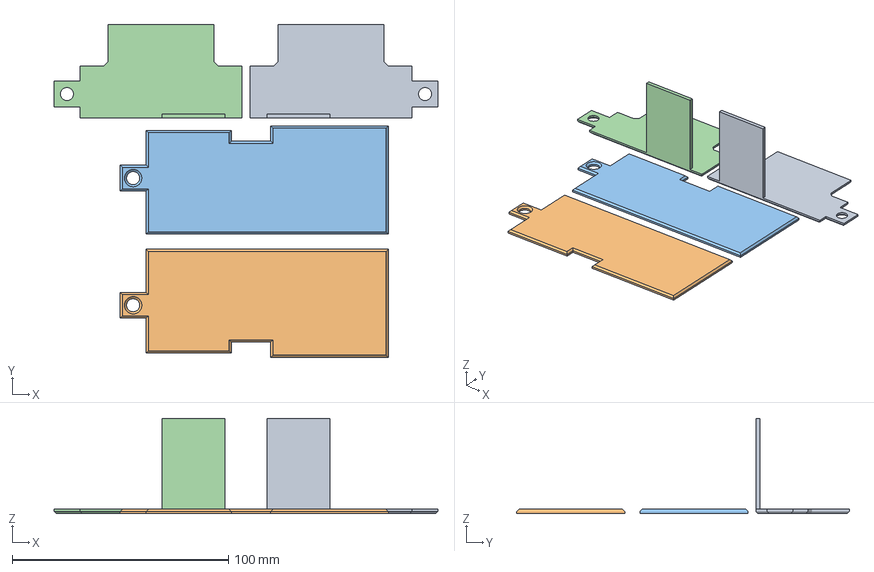
[picture p57: CAD file, 2026-07-08]
6-硬件设计/机械/6月11日/零件4^两侧侧电机壳上盖.3mf
177.6 x 153.9 x 44.0 mm
零件4^左侧电机壳
零件5^左侧电机壳
Mirror零件5^左侧电机壳
Mirror零件4^左侧电机壳
