qyxbs/smart-library-return-system/6-硬件设计/机械/6月19日/电机壳.STEP

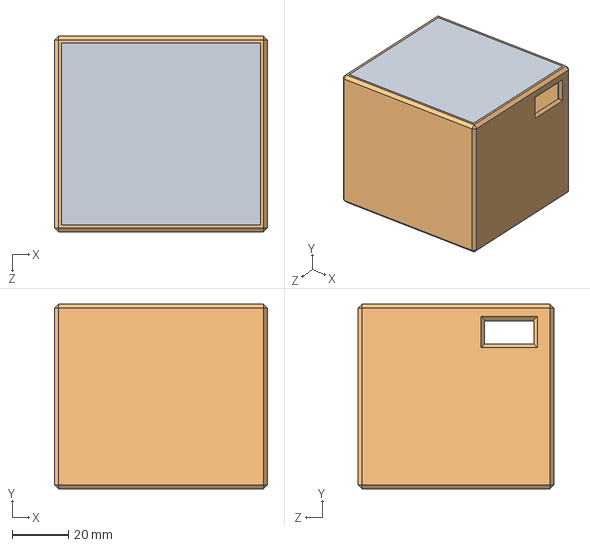
[picture p58: CAD file, 2026-07-08]
6-硬件设计/机械/6月19日/电机壳.STEP
76.0 x 66.0 x 70.0 mm
