qyxbs/smart-library-return-system/6-硬件设计/机械/6月23日/5vpcd.SLDPRT

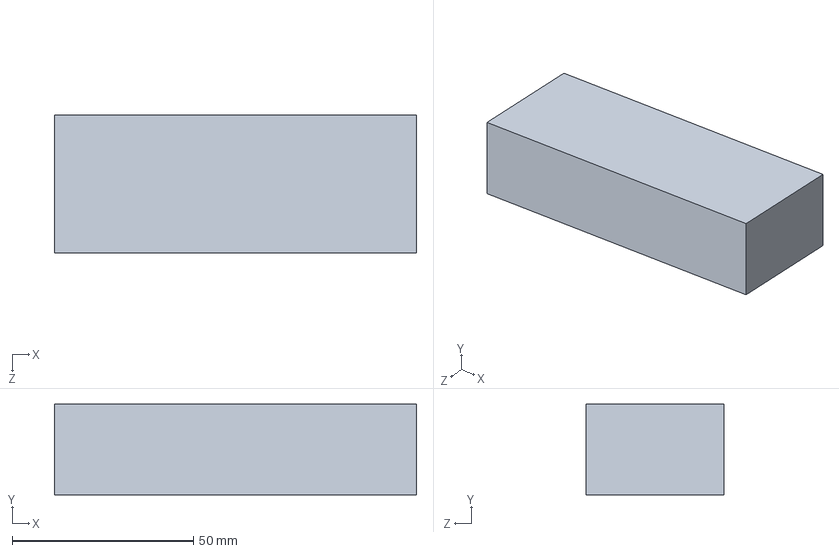
[picture p59: CAD file, 2026-07-08]
6-硬件设计/机械/6月23日/5vpcd.SLDPRT
100.0 x 25.0 x 38.0 mm
