qyxbs/smart-library-return-system/6-硬件设计/机械/6月24日/支撑电机.SLDPRT

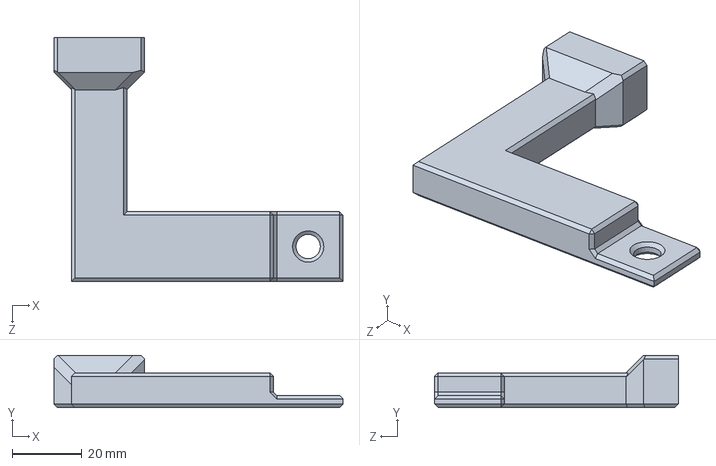
[picture p60: CAD file, 2026-07-08]
6-硬件设计/机械/6月24日/支撑电机.SLDPRT
83.0 x 15.0 x 70.0 mm
