qyxbs/smart-library-return-system/6-硬件设计/机械/6月25日/装配体1.STEP

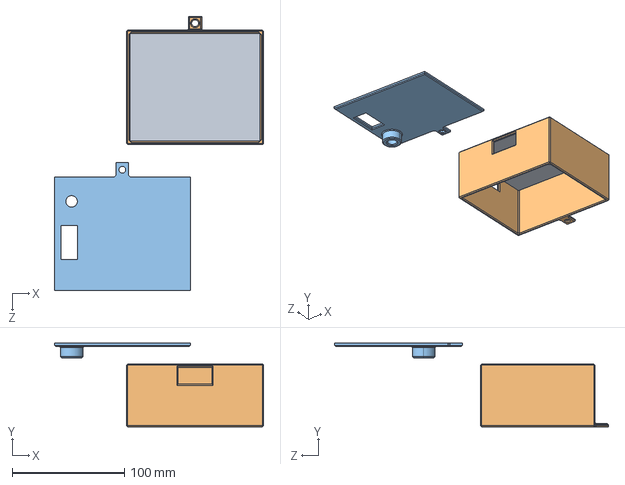
[picture p61: CAD file, 2026-07-08]
6-硬件设计/机械/6月25日/装配体1.STEP
186.2 x 74.5 x 243.9 mm
左右电机壳
零件4^装配体1
