qyxbs/smart-library-return-system/6-硬件设计/机械/6月26日/扫码方框挡板.STEP

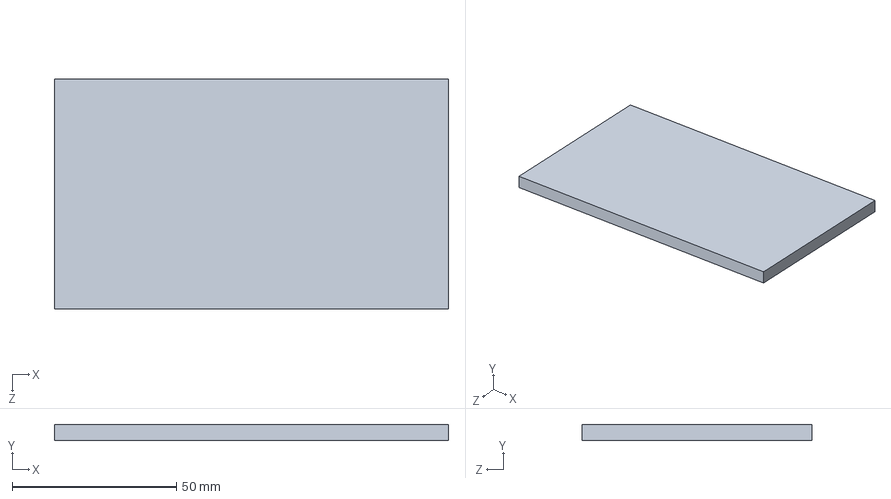
[picture p62: CAD file, 2026-07-08]
6-硬件设计/机械/6月26日/扫码方框挡板.STEP
120.0 x 5.00 x 70.0 mm
