qyxbs/smart-library-return-system/6-硬件设计/机械/6月28日/黑色摄像头.SLDPRT

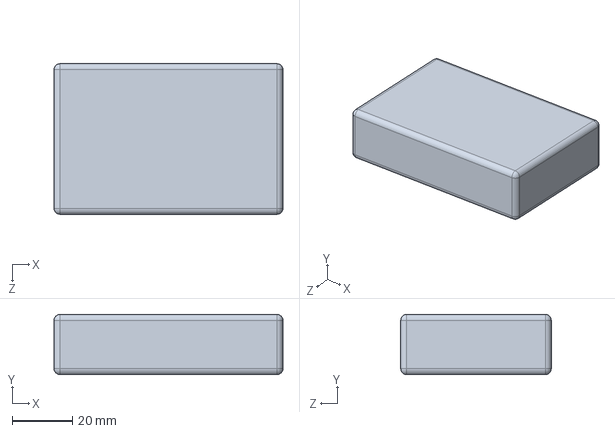
[picture p63: CAD file, 2026-07-08]
6-硬件设计/机械/6月28日/黑色摄像头.SLDPRT
76.0 x 20.0 x 50.0 mm
