qyxbs/smart-library-return-system/6-硬件设计/机械/6月29日/挡板梓赫梯就正版.3mf

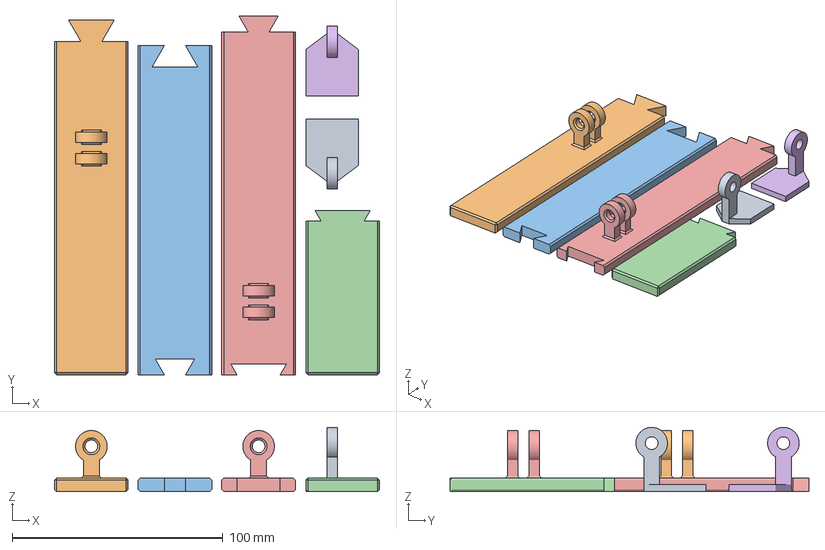
[picture p64: CAD file, 2026-07-08]
6-硬件设计/机械/6月29日/挡板梓赫梯就正版.3mf
154.2 x 170.2 x 30.5 mm
零件2^挡板梓赫梯 x 2
扫码板子_A
扫码板子_B_B
扫码板子_B_A_A
扫码板子_B_A_B
