qyxbs/smart-library-return-system/6-硬件设计/机械/6月5日/笔尖.stl

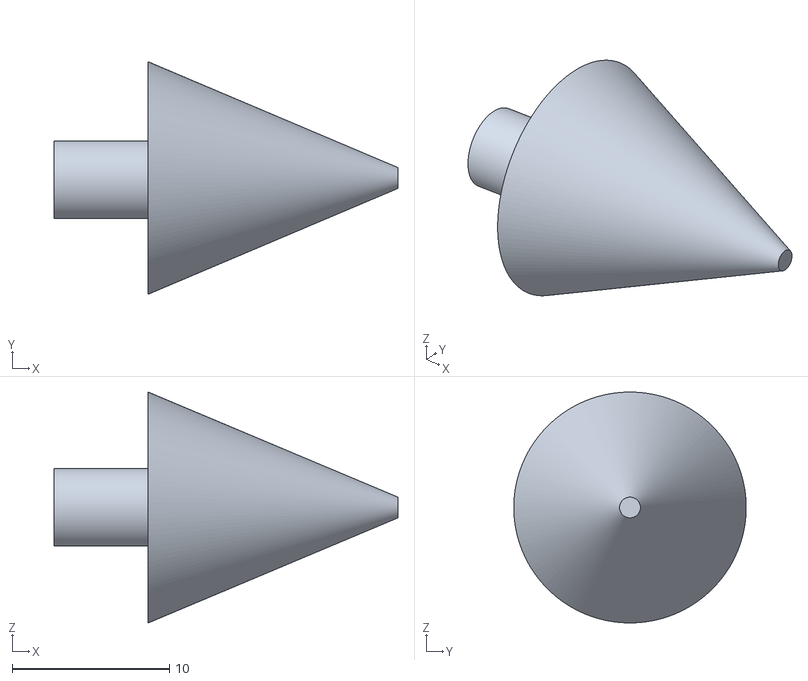
[picture p65: CAD file, 2026-07-08]
6-硬件设计/机械/6月5日/笔尖.stl
21.9 x 14.8 x 14.7
