qyxbs/smart-library-return-system/6-硬件设计/机械/7月2日/对齐板子.STEP

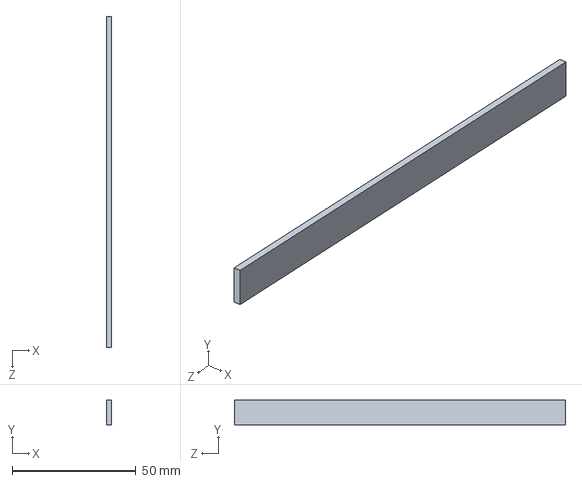
[picture p66: CAD file, 2026-07-08]
6-硬件设计/机械/7月2日/对齐板子.STEP
2.00 x 10.0 x 134.0 mm
