qyxbs/smart-library-return-system/6-硬件设计/机械/7月3日/红外壳子.SLDPRT

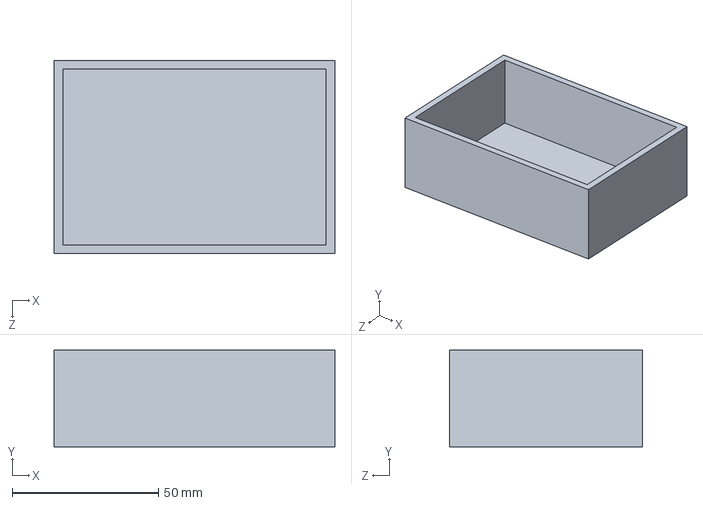
[picture p67: CAD file, 2026-07-08]
6-硬件设计/机械/7月3日/红外壳子.SLDPRT
96.0 x 33.0 x 66.0 mm
