qyxbs/smart-library-return-system/6-硬件设计/机械/5月18/零件1.STEP

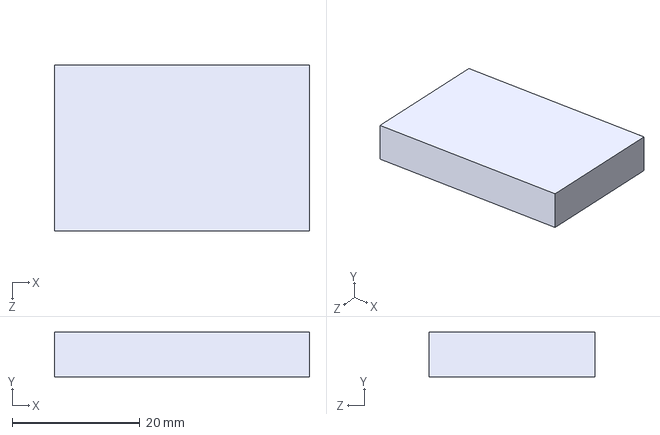
[picture p68: CAD file, 2026-07-08]
6-硬件设计/机械/5月18/零件1.STEP
40.0 x 7.00 x 26.0 mm
