qyxbs/smart-library-return-system/6-硬件设计/机械/5月21日/零件3^屏幕壳.STEP

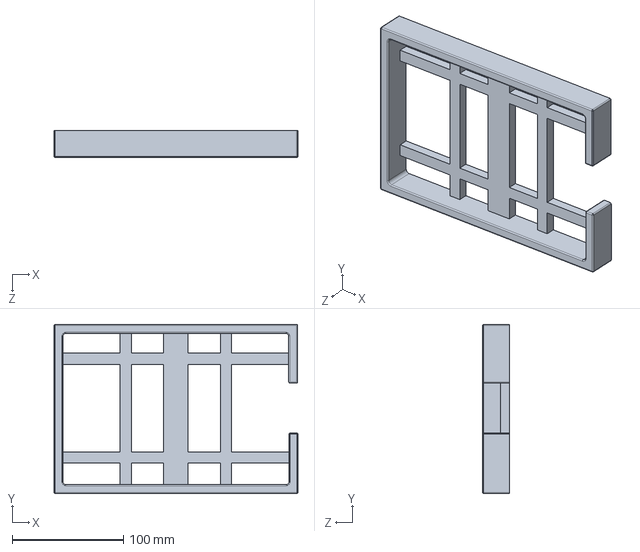
[picture p69: CAD file, 2026-07-08]
6-硬件设计/机械/5月21日/零件3^屏幕壳.STEP
219.0 x 151.9 x 24.0 mm
