qyxbs/smart-library-return-system/6-硬件设计/机械/5月25日/推书.STEP

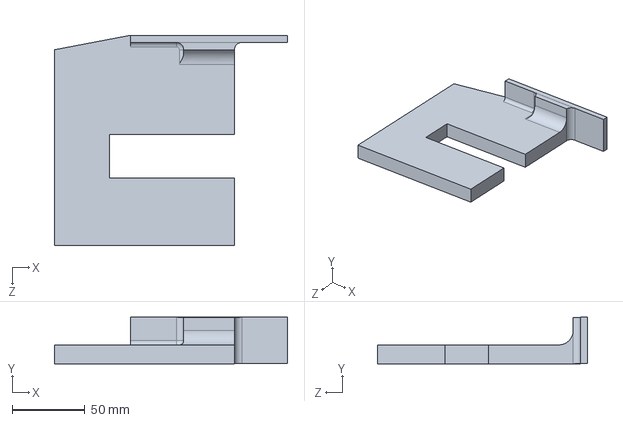
[picture p70: CAD file, 2026-07-08]
6-硬件设计/机械/5月25日/推书.STEP
160.5 x 32.1 x 145.0 mm
