qyxbs/smart-library-return-system/6-硬件设计/机械/6月19日/三鹿保护壳.STEP

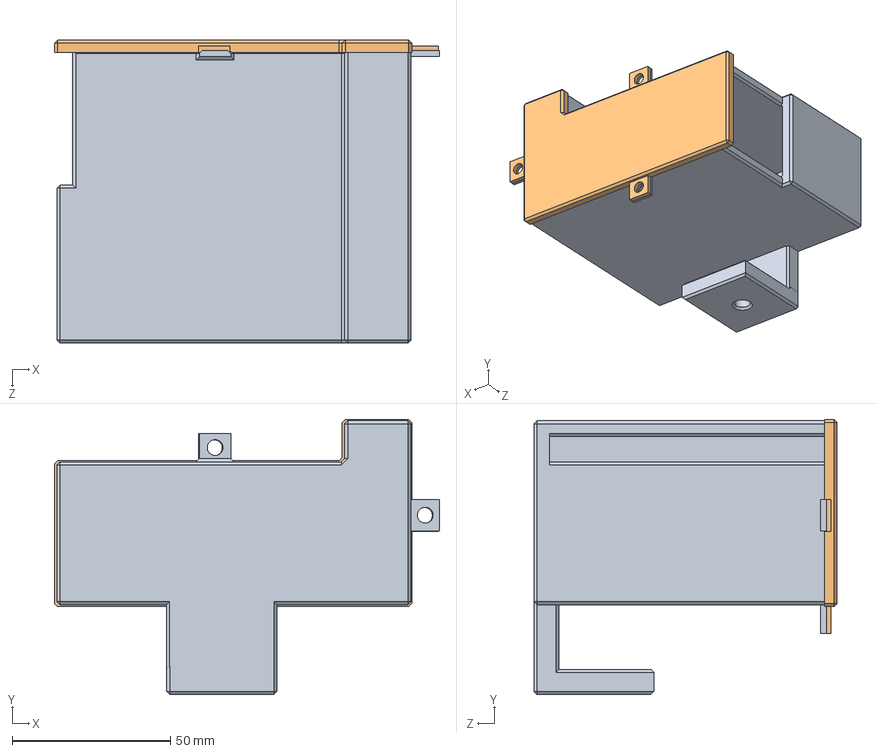
[picture p71: CAD file, 2026-07-08]
6-硬件设计/机械/6月19日/三鹿保护壳.STEP
121.8 x 87.1 x 95.9 mm
零件2^三鹿保护壳
零件4^三鹿保护壳
