qyxbs/smart-library-return-system/6-硬件设计/机械/6月23日/卡口.STEP

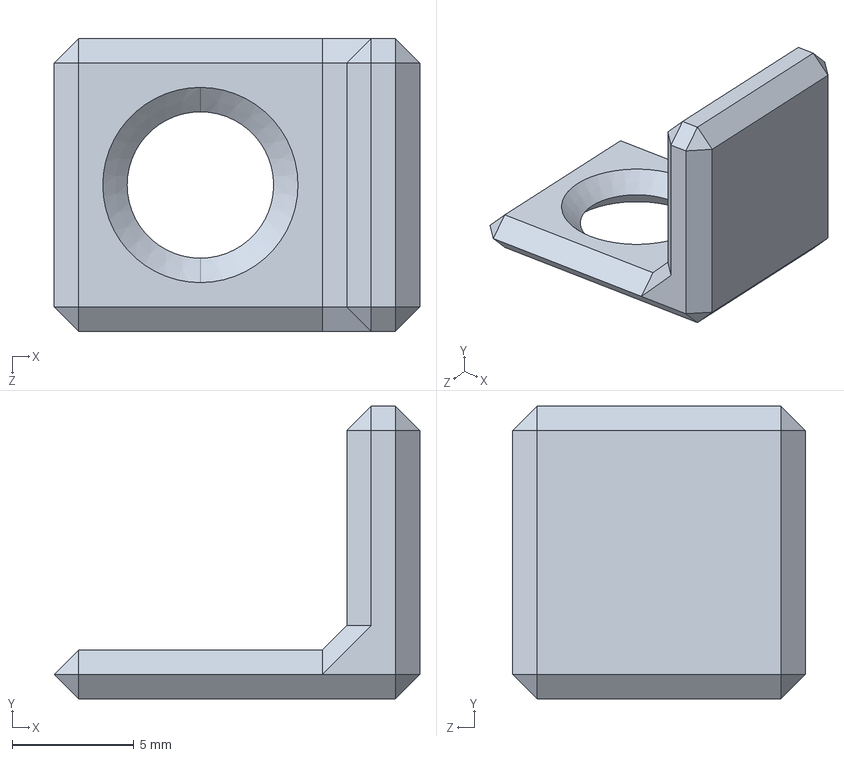
[picture p72: CAD file, 2026-07-08]
6-硬件设计/机械/6月23日/卡口.STEP
15.0 x 12.0 x 12.0 mm
