qyxbs/smart-library-return-system/6-硬件设计/机械/6月25日/左右电机壳.STEP

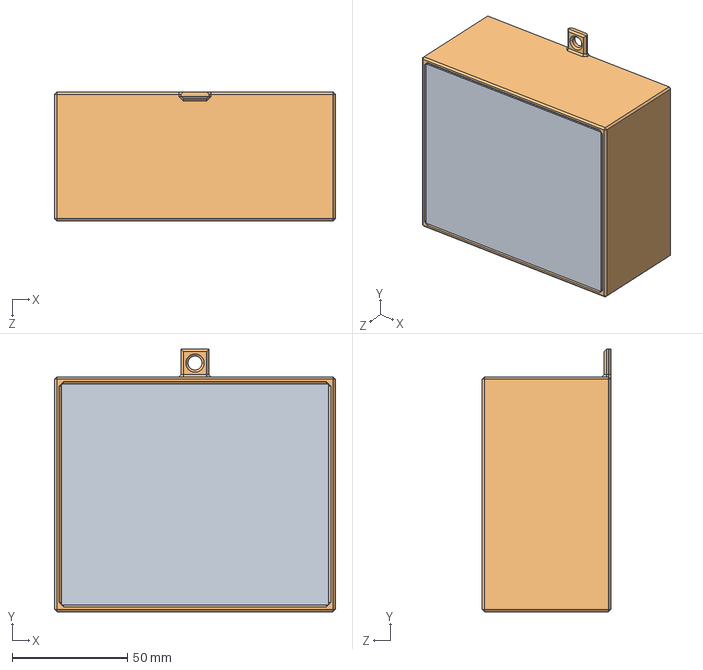
[picture p73: CAD file, 2026-07-08]
6-硬件设计/机械/6月25日/左右电机壳.STEP
122.0 x 114.0 x 56.0 mm
