qyxbs/smart-library-return-system/6-硬件设计/机械/6月26日/水平移电机壳.SLDPRT

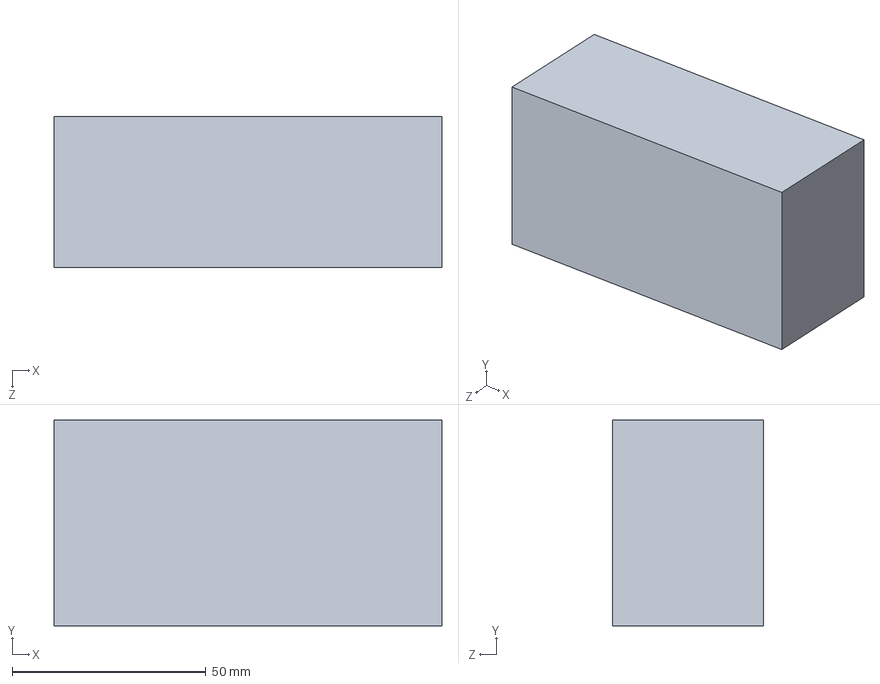
[picture p74: CAD file, 2026-07-08]
6-硬件设计/机械/6月26日/水平移电机壳.SLDPRT
100.0 x 53.0 x 39.0 mm
