qyxbs/smart-library-return-system/6-硬件设计/机械/6月28日/黑芯片固定.STEP

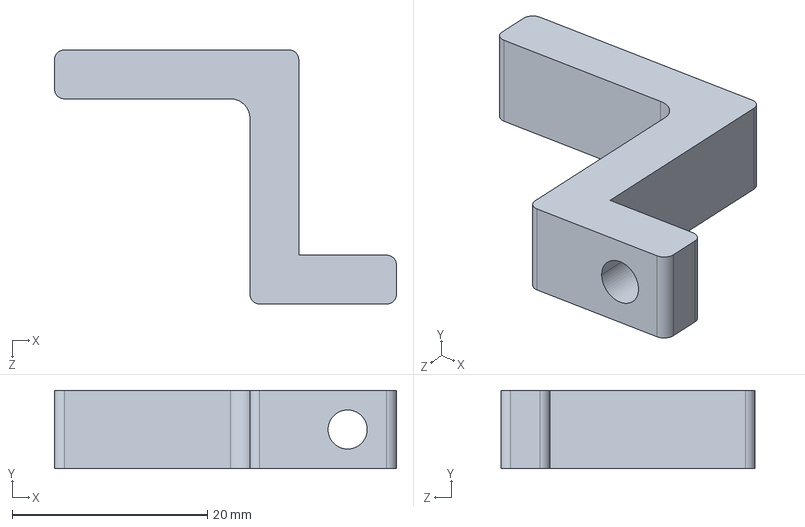
[picture p75: CAD file, 2026-07-08]
6-硬件设计/机械/6月28日/黑芯片固定.STEP
35.0 x 8.00 x 26.0 mm
