qyxbs/smart-library-return-system/6-硬件设计/机械/6月5日/喇叭盖子.stl

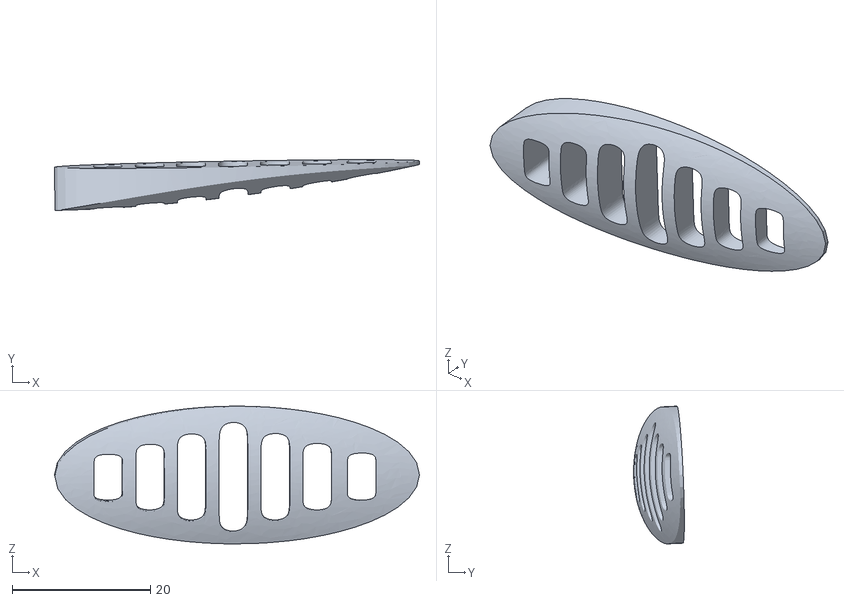
[picture p76: CAD file, 2026-07-08]
6-硬件设计/机械/6月5日/喇叭盖子.stl
52.8 x 7.33 x 19.9
