qyxbs/smart-library-return-system/6-硬件设计/机械/7月2日/信号各自组合.STEP

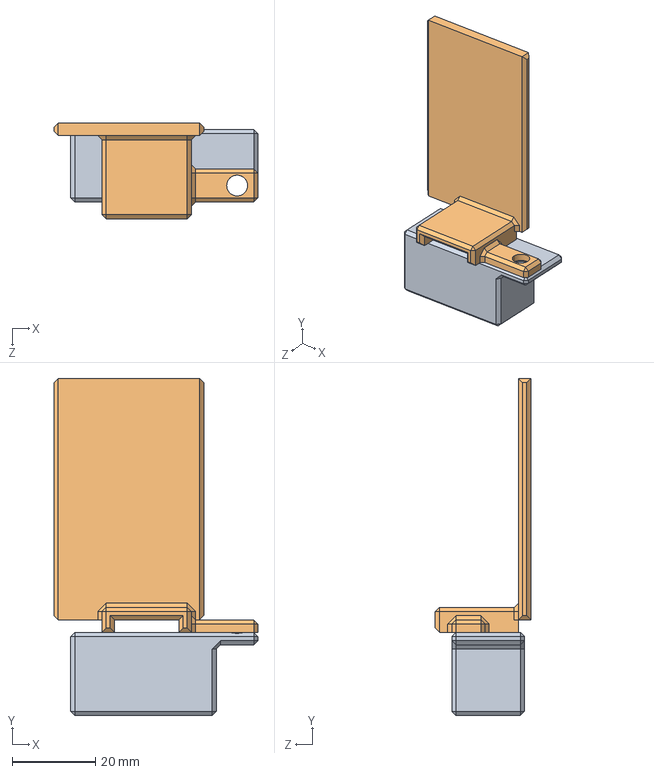
[picture p77: CAD file, 2026-07-08]
6-硬件设计/机械/7月2日/信号各自组合.STEP
49.0 x 81.0 x 23.0 mm
信号挡板
零件2
