qyxbs/smart-library-return-system/6-硬件设计/机械/7月3日/支撑.STEP

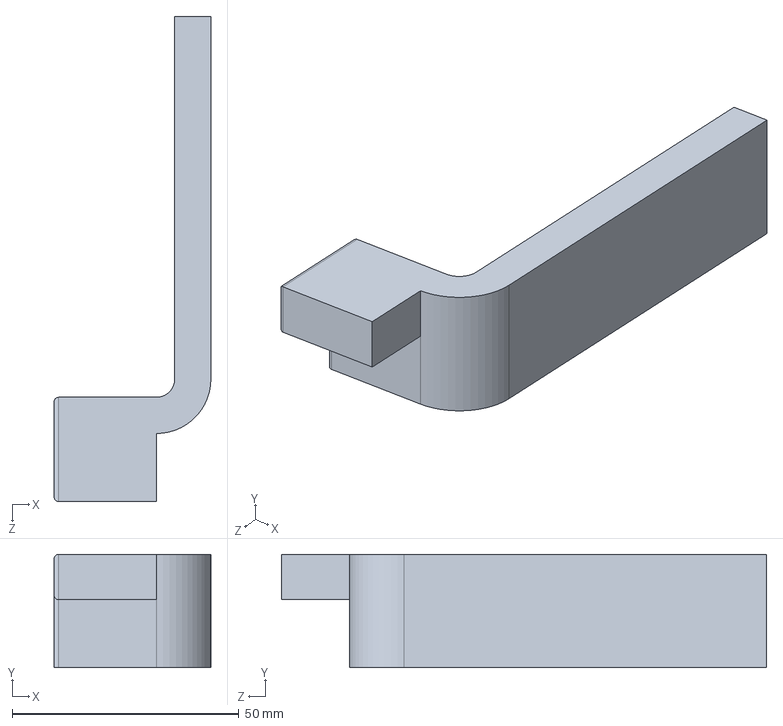
[picture p78: CAD file, 2026-07-08]
6-硬件设计/机械/7月3日/支撑.STEP
34.6 x 25.0 x 107.0 mm
