qyxbs/smart-library-return-system/6-硬件设计/机械/5月18/组个夹子限位.STEP

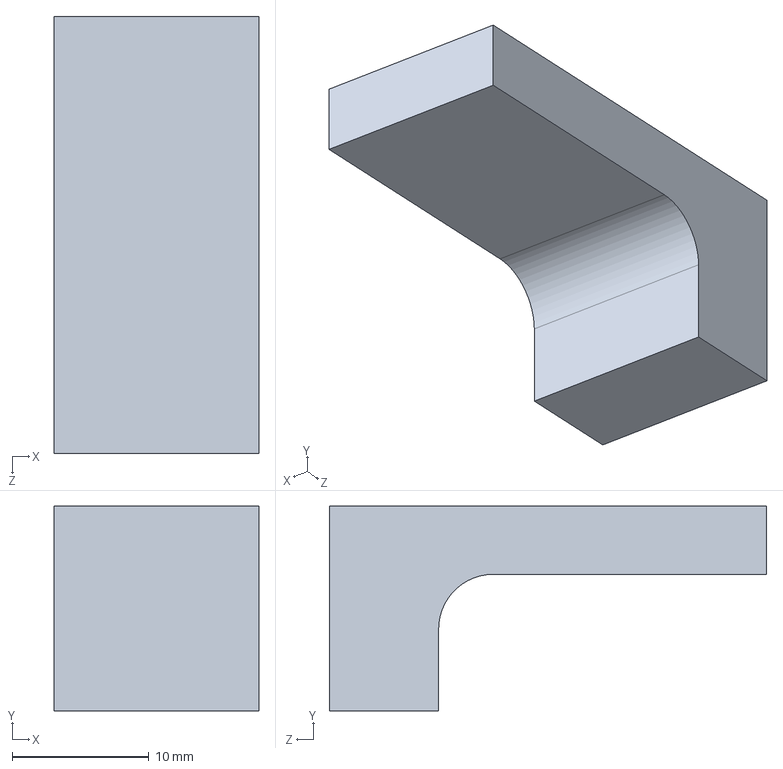
[picture p79: CAD file, 2026-07-08]
6-硬件设计/机械/5月18/组个夹子限位.STEP
15.0 x 15.0 x 32.0 mm
