qyxbs/smart-library-return-system/6-硬件设计/机械/6月19日/三鹿电源板.SLDPRT

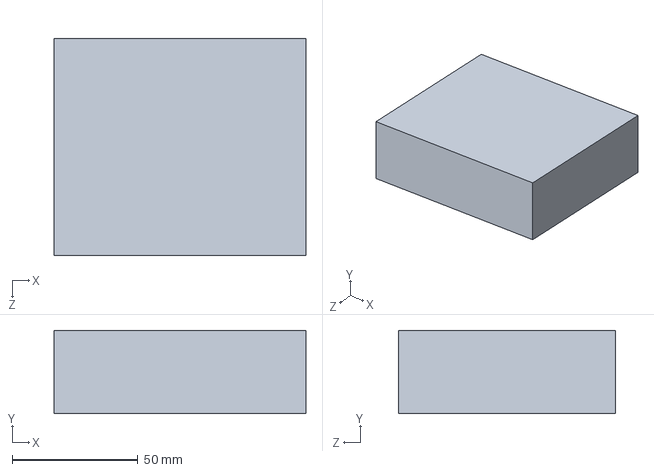
[picture p80: CAD file, 2026-07-08]
6-硬件设计/机械/6月19日/三鹿电源板.SLDPRT
100.0 x 33.0 x 86.0 mm
