qyxbs/smart-library-return-system/6-硬件设计/机械/6月23日/左侧电机壳.STEP

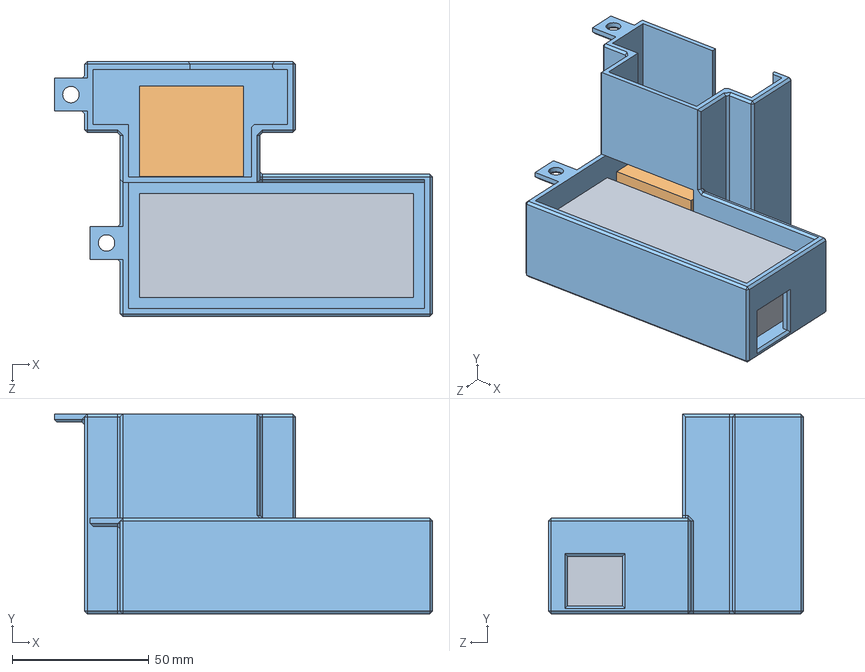
[picture p81: CAD file, 2026-07-08]
6-硬件设计/机械/6月23日/左侧电机壳.STEP
138.0 x 73.0 x 93.2 mm
5vpcd
pcd
零件3^左侧电机壳
