qyxbs/smart-library-return-system/6-硬件设计/机械/7月3日/红外壳.STEP

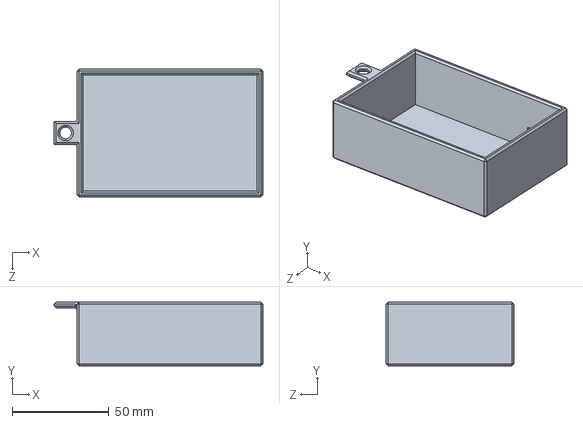
[picture p82: CAD file, 2026-07-08]
6-硬件设计/机械/7月3日/红外壳.STEP
108.0 x 33.0 x 66.0 mm
