qyxbs/smart-library-return-system/6-硬件设计/机械/5月18/zhicheng.STEP

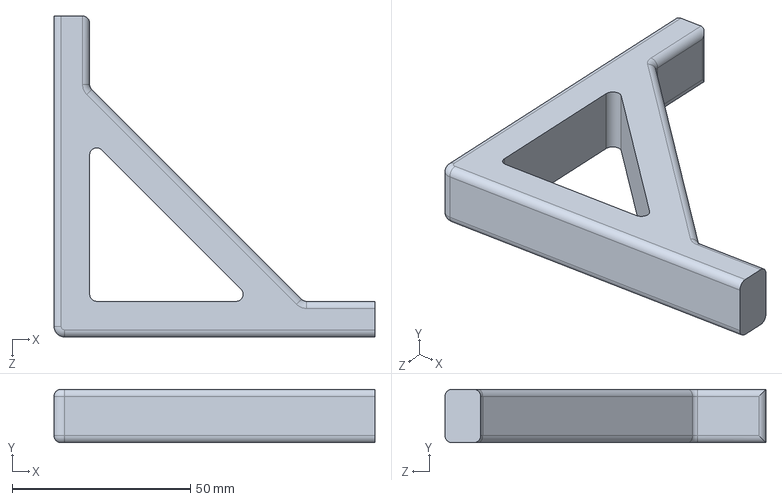
[picture p83: CAD file, 2026-07-08]
6-硬件设计/机械/5月18/zhicheng.STEP
90.0 x 15.0 x 90.0 mm
