qyxbs/smart-library-return-system/6-硬件设计/机械/6月23日/pcd.SLDPRT

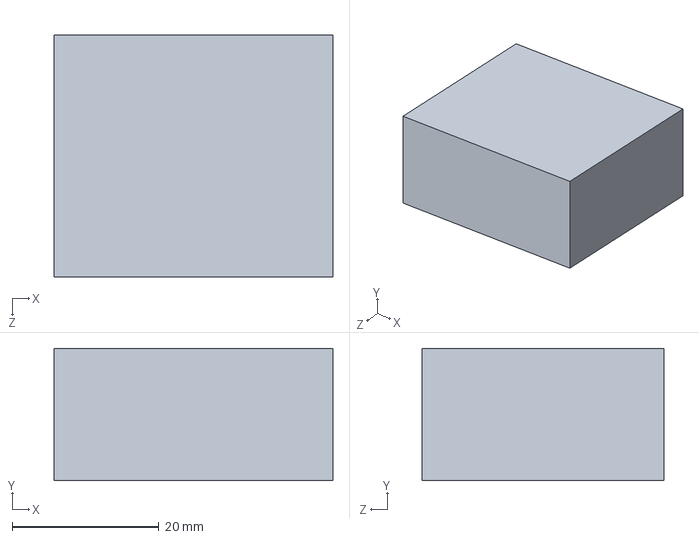
[picture p84: CAD file, 2026-07-08]
6-硬件设计/机械/6月23日/pcd.SLDPRT
38.0 x 18.0 x 33.0 mm
