qyxbs/smart-library-return-system/6-硬件设计/机械/5月18/支撑.SLDPRT

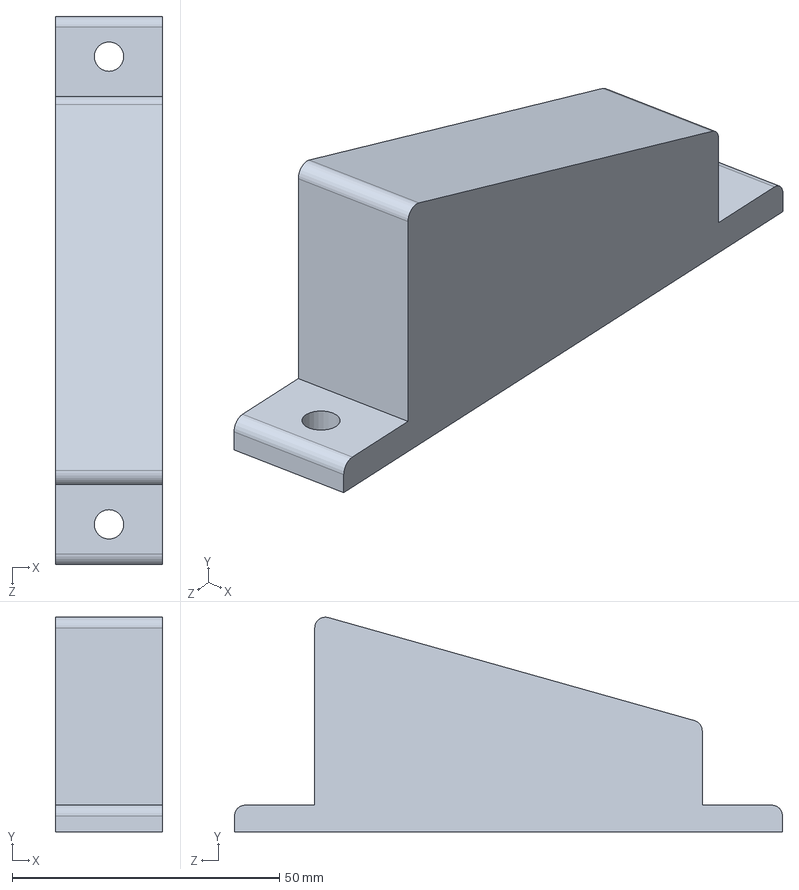
[picture p85: CAD file, 2026-07-08]
6-硬件设计/机械/5月18/支撑.SLDPRT
20.0 x 40.2 x 102.5 mm
