qyxbs/smart-library-return-system/6-硬件设计/机械/6月23日/左侧电机壳左边.STEP

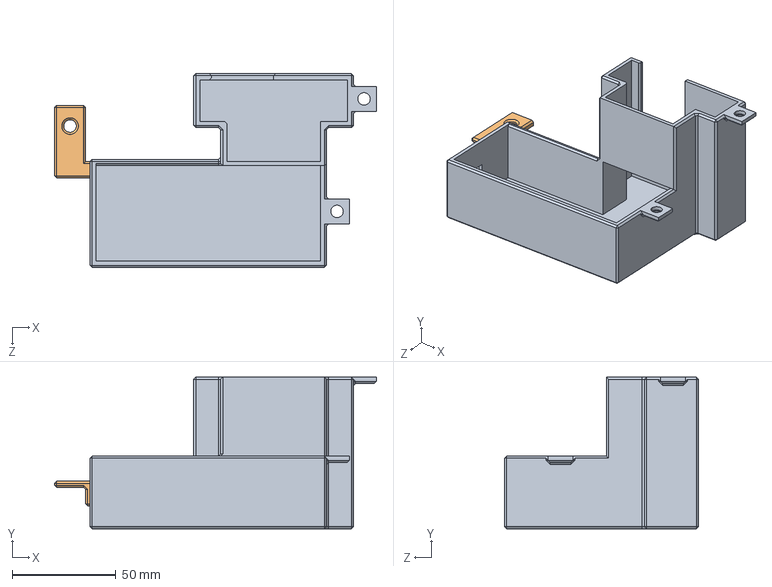
[picture p86: CAD file, 2026-07-08]
6-硬件设计/机械/6月23日/左侧电机壳左边.STEP
155.0 x 73.0 x 93.2 mm
Mirror零件3^左侧电机壳
Mirror电机固定七
