qyxbs/smart-library-return-system/6-硬件设计/机械/6月23日/两侧侧电机壳顶盖.STEP

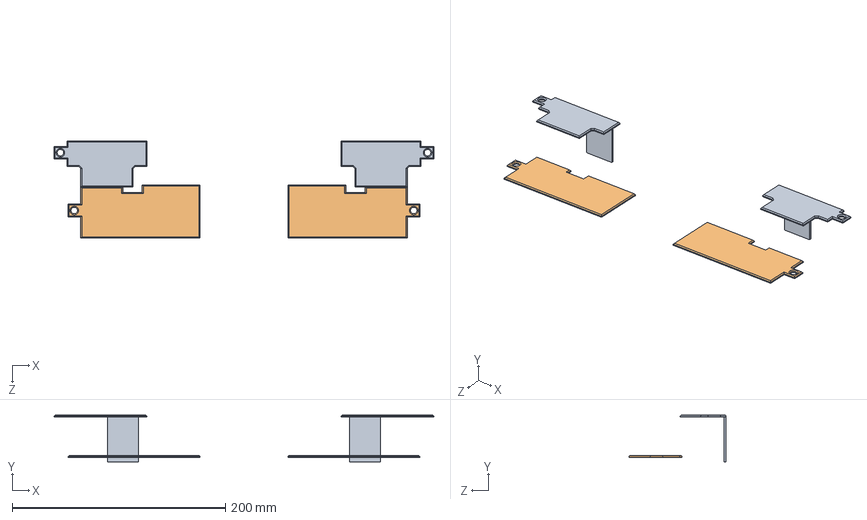
[picture p87: CAD file, 2026-07-08]
6-硬件设计/机械/6月23日/两侧侧电机壳顶盖.STEP
356.0 x 44.0 x 91.2 mm
零件4^左侧电机壳
零件5^左侧电机壳
Mirror零件5^左侧电机壳
Mirror零件4^左侧电机壳
