qyxbs/smart-library-return-system/(list of files, cad)

Other CAD files:
6-硬件设计/机械/5月21日/屏幕壳.SLDASM
6-硬件设计/机械/5月27日/装配体1.SLDASM
6-硬件设计/机械/6月23日/Mirror电机固定七.SLDPRT
6-硬件设计/机械/6月3日/弹簧.STEP
6-硬件设计/机械/5月25日/推书下面.STEP
6-硬件设计/机械/6月24日/Mirror支撑电机.SLDPRT
6-硬件设计/机械/6月30日/零件1.SLDPRT
6-硬件设计/机械/6月6日/6月10号.STEP
6-硬件设计/机械/5月19号/弹簧.SLDPRT
6-硬件设计/机械/5月21日/圆环.SLDPRT
6-硬件设计/机械/5月21日/屏幕壳.3mf
6-硬件设计/机械/5月22日/将总的主子.SLDPRT
6-硬件设计/机械/5月27日/旁边的收纳.SLDPRT
6-硬件设计/机械/5月29日/圆环.SLDPRT
6-硬件设计/机械/5月31日/k230盖子.SLDPRT
6-硬件设计/机械/6月10号/6月10号.SLDPRT
6-硬件设计/机械/6月10号/摄像头.SLDPRT
6-硬件设计/机械/6月11日/推书.3mf
6-硬件设计/机械/6月11日/推书.SLDPRT
6-硬件设计/机械/6月13日/雷达字.SLDPRT
6-硬件设计/机械/6月15日/屏幕壳.3mf
6-硬件设计/机械/6月15日/屏幕壳.SLDPRT
6-硬件设计/机械/6月16日/挡板.SLDASM
6-硬件设计/机械/6月19日/三鹿保护壳.SLDASM
6-硬件设计/机械/6月19日/电机壳.3mf
6-硬件设计/机械/6月19日/电机壳.SLDPRT
6-硬件设计/机械/6月1日/舵机改直线下齿轮1.3mf
6-硬件设计/机械/6月20日/电机壳.SLDASM
6-硬件设计/机械/6月22日/三鹿夹子壳.SLDASM
6-硬件设计/机械/6月23日/卡口.SLDPRT
6-硬件设计/机械/6月23日/左侧电机壳.SLDASM
6-硬件设计/机械/6月23日/电机固定七.SLDPRT
6-硬件设计/机械/6月24日/双支持.SLDASM
6-硬件设计/机械/6月25日/左右电机壳.SLDPRT
6-硬件设计/机械/6月25日/电线卡口.SLDPRT
6-硬件设计/机械/6月25日/装配体1.SLDASM
6-硬件设计/机械/6月26日/left and right.SLDASM
6-硬件设计/机械/6月26日/扫码方框挡板.SLDPRT
6-硬件设计/机械/6月27日/固定.SLDPRT
6-硬件设计/机械/6月28日/linux壳子.SLDASM
6-硬件设计/机械/6月28日/黑芯片固定.SLDPRT
6-硬件设计/机械/6月29日/垫片.SLDPRT
6-硬件设计/机械/6月29日/夹子限位开关.SLDPRT
6-硬件设计/机械/6月4日/zigbee支撑.SLDPRT
6-硬件设计/机械/6月5日/挡板.3mf
6-硬件设计/机械/6月5日/挡板.SLDASM
6-硬件设计/机械/6月6日/6月10号.SLDPRT
6-硬件设计/机械/6月6日/挡板.SLDASM
6-硬件设计/机械/7月1日/挡板梓赫梯.SLDASM
6-硬件设计/机械/7月2日/信号各自组合.SLDASM
6-硬件设计/机械/7月2日/信号挡板.SLDPRT
6-硬件设计/机械/7月2日/对齐板子.SLDPRT
6-硬件设计/机械/7月2日/零件2.SLDPRT
6-硬件设计/机械/7月3日/打印机.SLDPRT
6-硬件设计/机械/7月3日/支撑.SLDPRT
6-硬件设计/机械/7月3日/红外壳.SLDASM
6-硬件设计/机械/7月7日/斜支撑.SLDPRT
