qyxbs/smart-library-return-system/6-硬件设计/电路/立创·泰山派开发板原理图.pdf

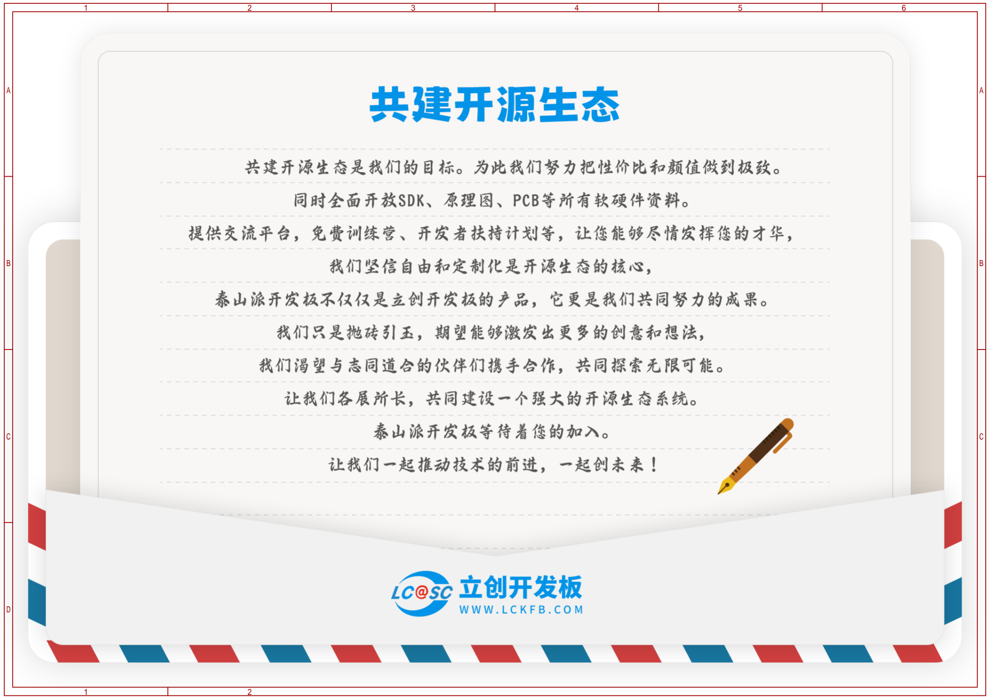
[picture p88: page 1]
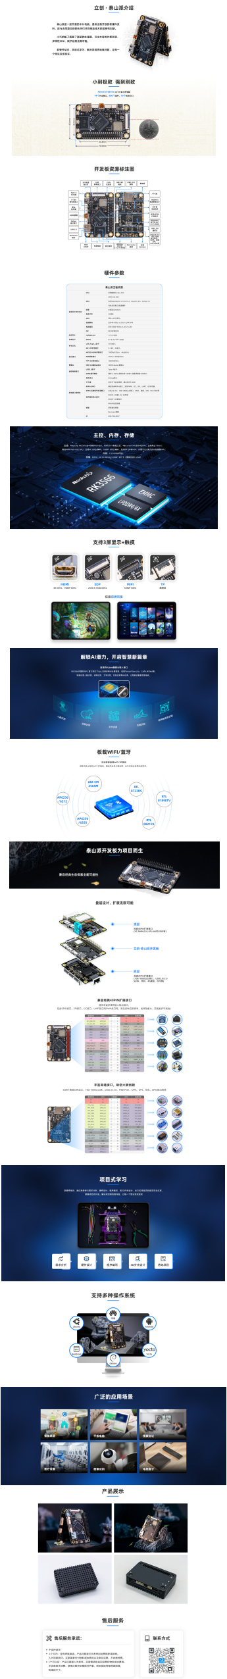
[picture p89: page 2]

# RK3566_12345

# (POWER)

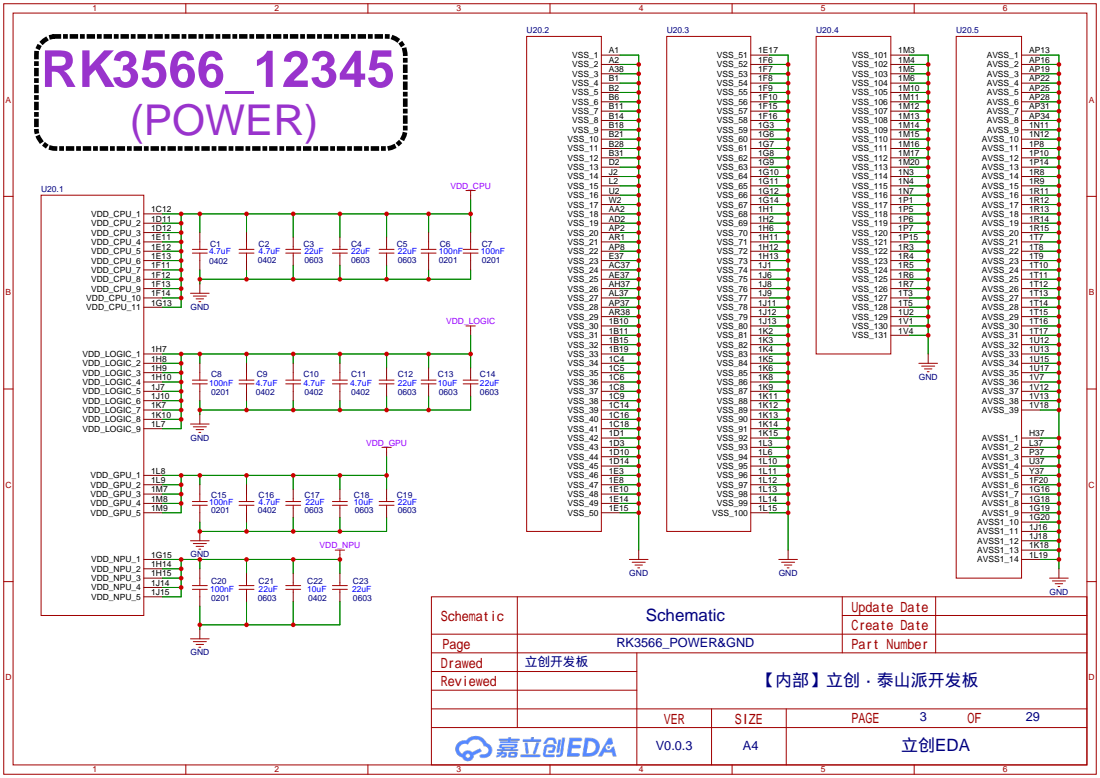
[picture p90: page 3]

# RK3566_6

# (DDR_PHY)

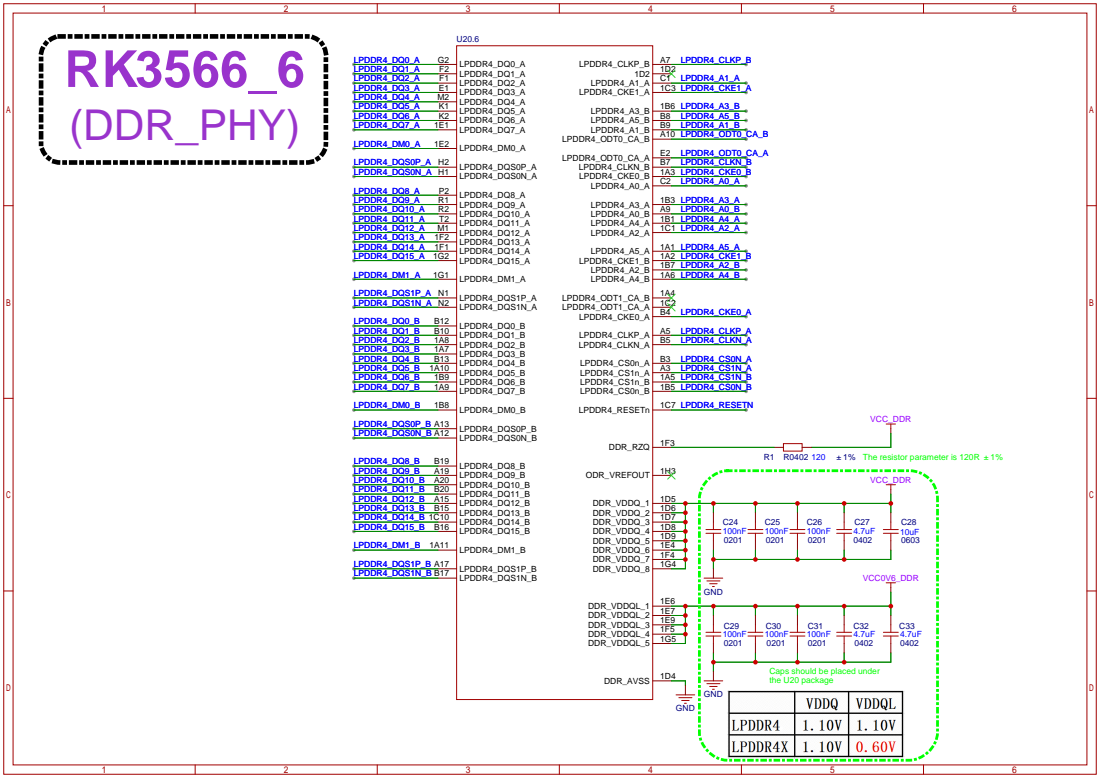
[picture p91: page 4]

The resistor parameter is 120R 1%

Caps should be placed under
the U20 package

# RK3566_7

# (OSC/PLL/PMUIO1/2)

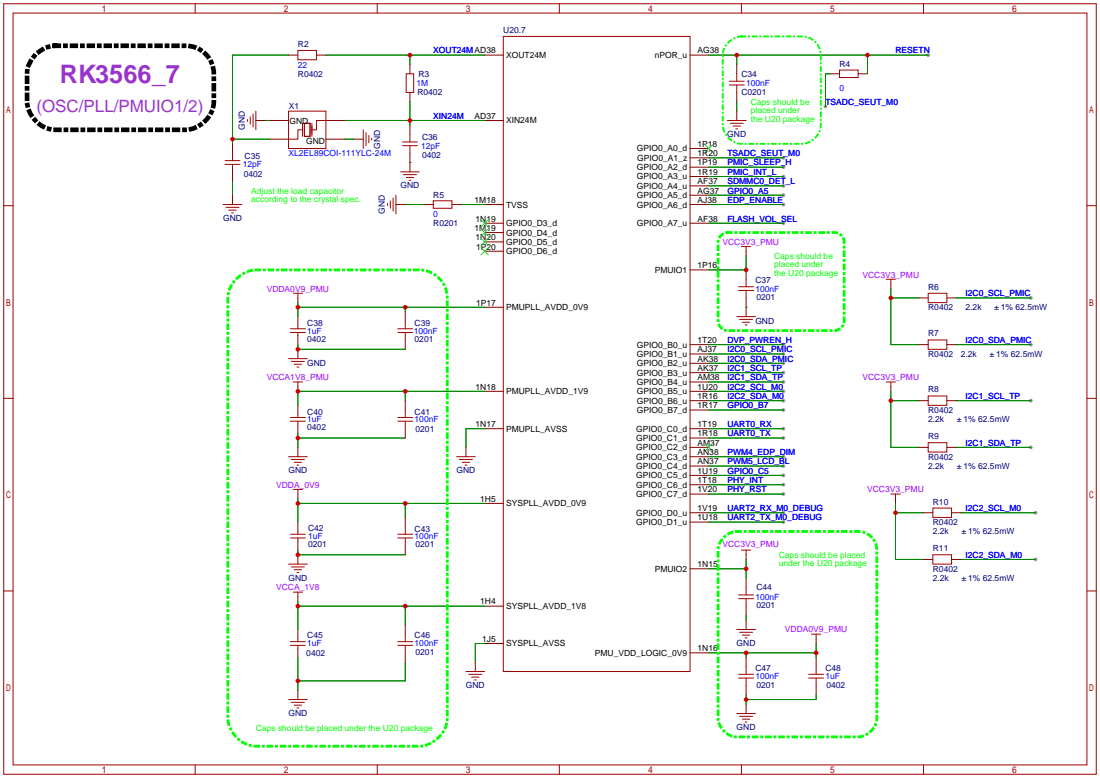
[picture p92: page 5]

Caps should be placed
under the U20 package

GND
Caps should be placed under the U20 package

# RK3566_9

# (VCCIO2 Domain)

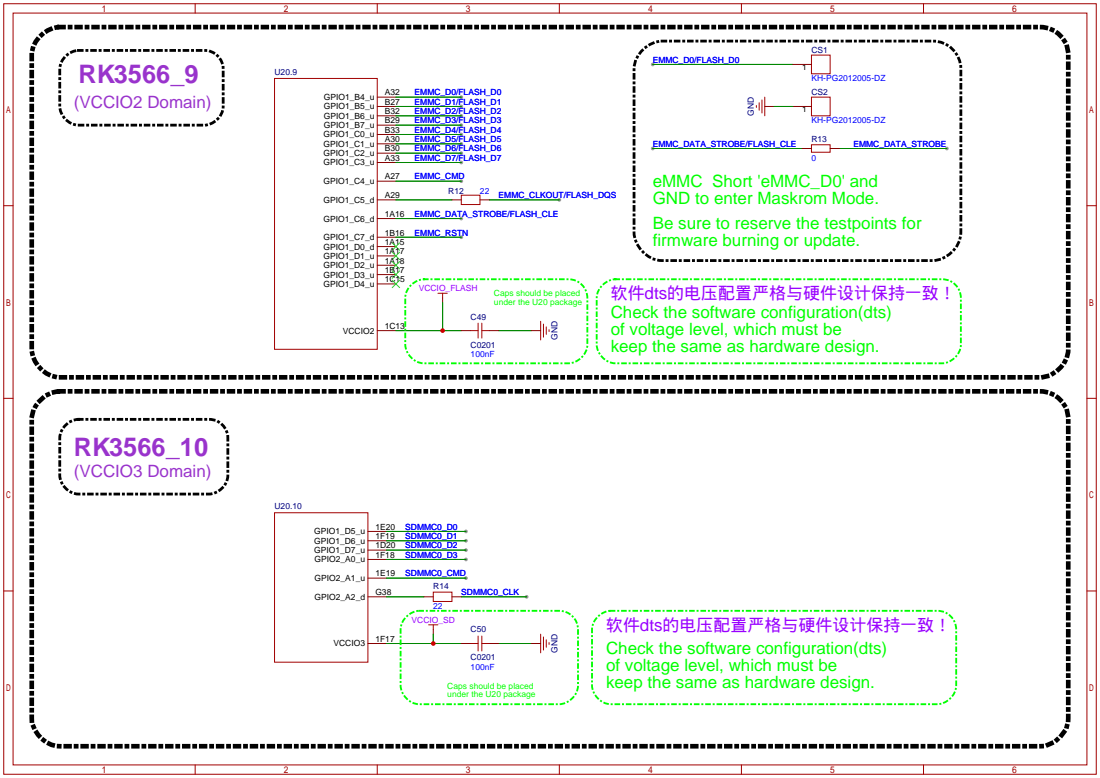
[picture p93: page 6]

eMMC Short 'eMMC_D0' and
GND to enter Maskrom Mode.
Be sure to reserve the testpoints for
firmware burning or update.

Caps should be placed

Check the software configuration(dts)
of voltage level, which must be
keep the same as hardware design.

软件dts的电压配置严格与硬件设计保持一致！

# RK3566_21

# RK3566_22

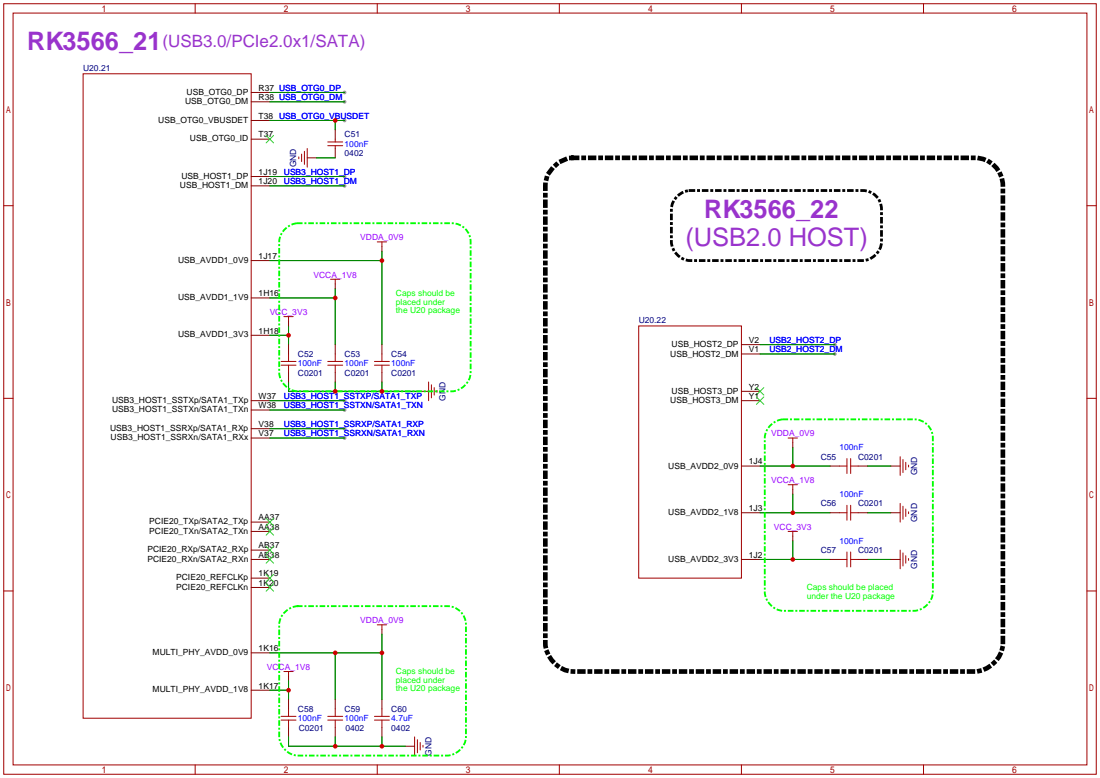
[picture p94: page 7]

Caps should be placed
under the U20 package

# RK3566_11 RK3566_14

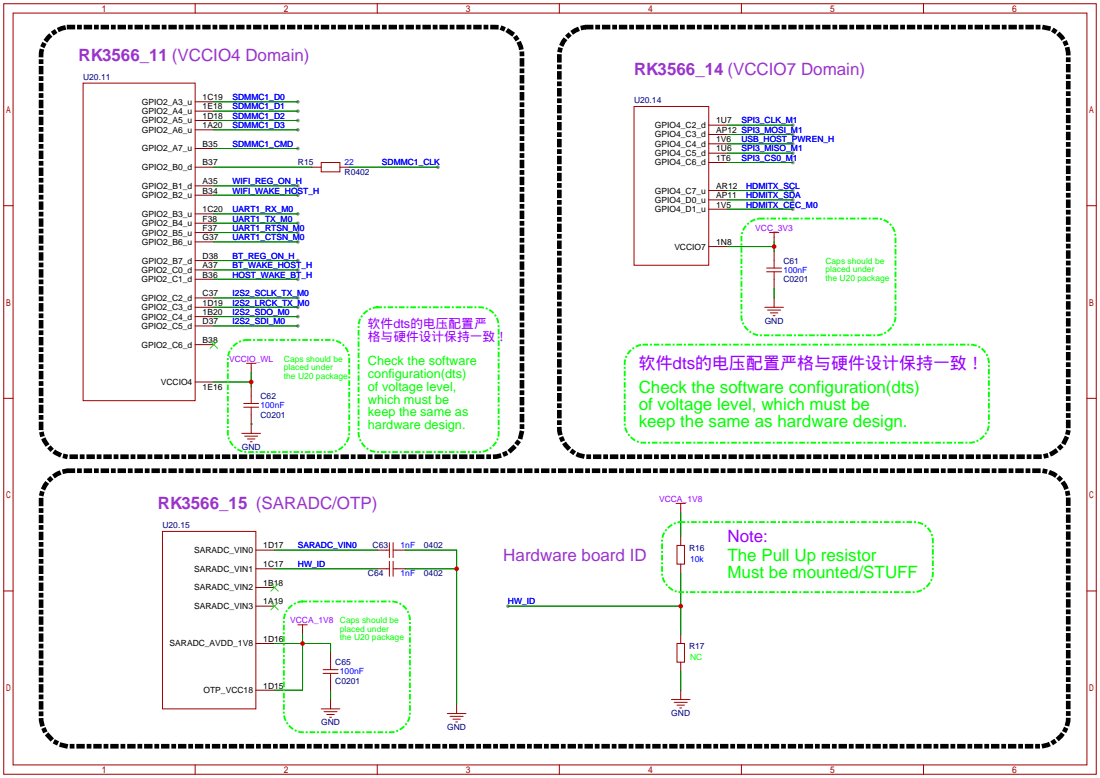
[picture p95: page 8]

软件dts的电压配置严
格与硬件设计保持一致！
Check the software
configuration(dts)
of voltage level,
which must be
keep the same as
hardware design.

软件dts的电压配置严格与硬件设计保持一致！
Check the software configuration(dts)
of voltage level, which must be
keep the same as hardware design.

Note:
The Pull Up resistor
Must be mounted/STUFF

RK3566_16 | RK3566_13
(MIPI_CSI_RX) | (VCCIO6 Domain)

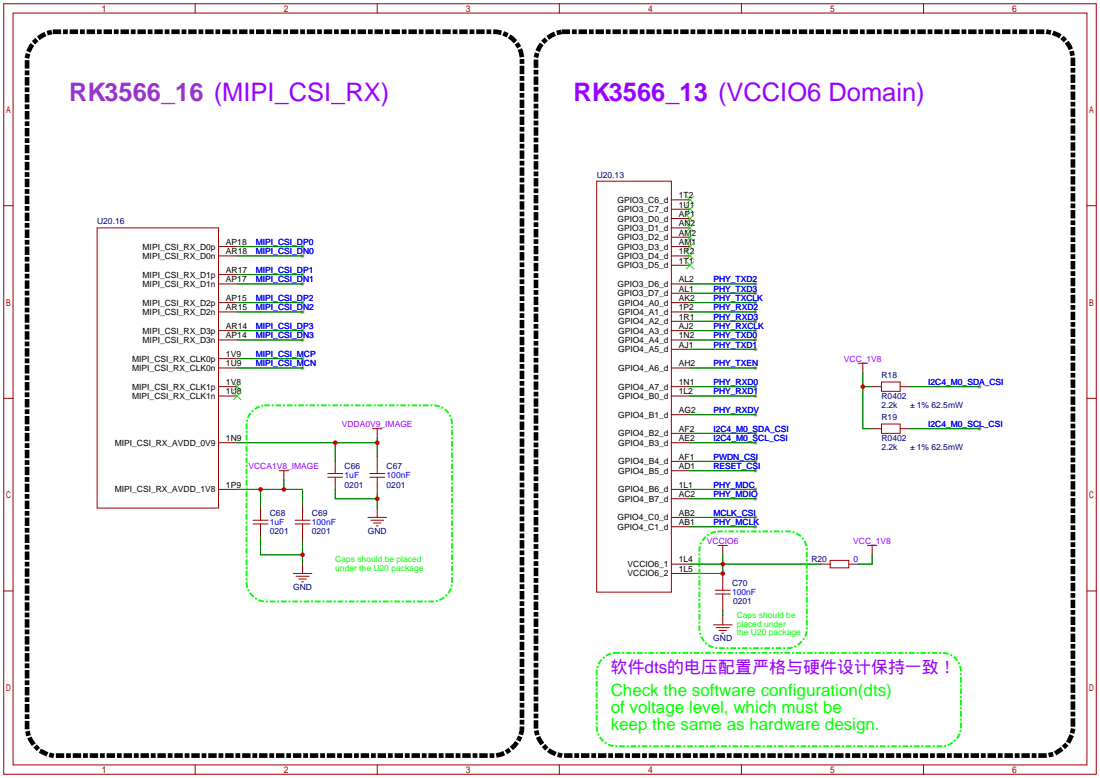
[picture p96: page 9]

Caps should be placed
under the U20 package

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

RK3566_18 | RK3566_19

# (MIPI_DSI_TX0/LVDS_TX0)

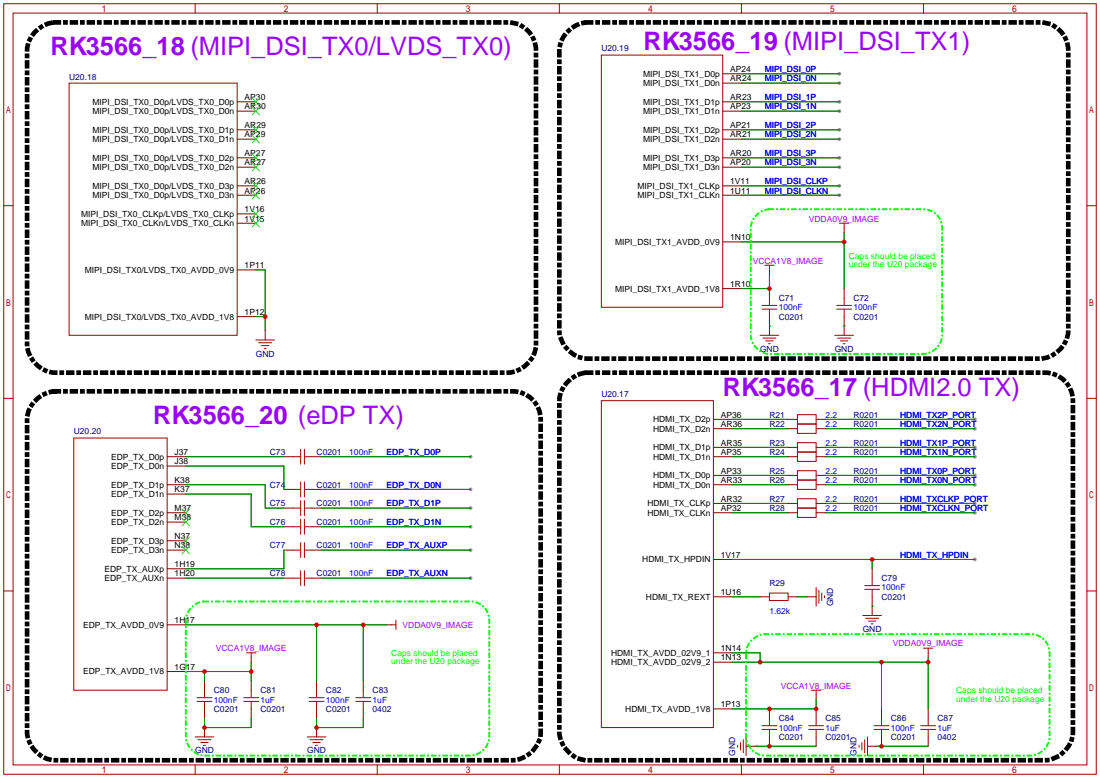
[picture p97: page 10]

Caps should be placed
under the U20 package

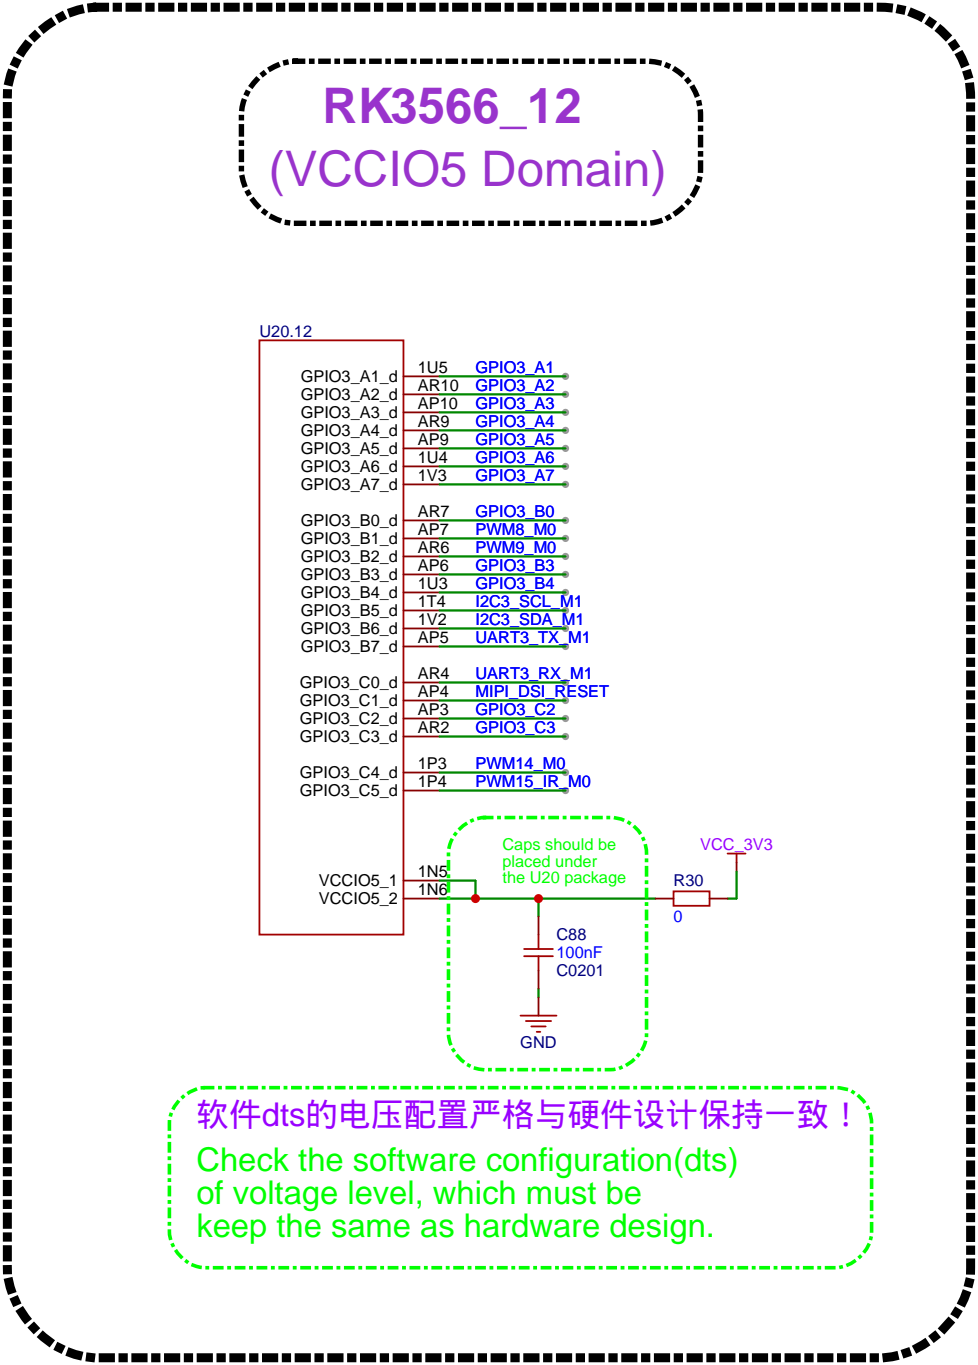
[picture p98: figure]
GPIO3_A1_d 1U5 GPIO3_A2_d AR10 GPIO3_A3_d AP10 GPIO3_A4_d AR9 GPIO3_A5_d AP9 GPIO3_A6_d 1U4 GPIO3_A7_d 1V3; GPIO3_B0_d AR7 GPIO3_B1_d AP7 GPIO3_B2_d AR6 GPIO3_B3_d AP6 GPIO3_B4_d 1U3 GPIO3_B5_d 1T4 GPIO3_B6_d 1V2 GPIO3_B7_d AP5; GPIO3_C0_d AR4 GPIO3_C1_d AP4 GPIO3_C2_d AP3 GPIO3_C3_d AR2; GPIO3_C4_d 1P3 GPIO3_C5_d 1P4; VCCIO5_1 1N5 VCCIO5_2 1N6; I2C3_SCL_M1 I2C3_SDA_M1; VCC_3V3; PWM14_M0 PWM15_IR_M0; GPIO3_B4; GPIO3_B3; MIPI_DSI_RESET; PWM8_M0 PWM9_M0; GPIO3_C2; UART3_RX_M1; UART3_TX_M1; GPIO3_C3; GPIO3_A1 GPIO3_A2 GPIO3_A3 GPIO3_A4 GPIO3_A5 GPIO3_A6 GPIO3_A7; GPIO3_B0; (VCCIO5 Domain); GND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

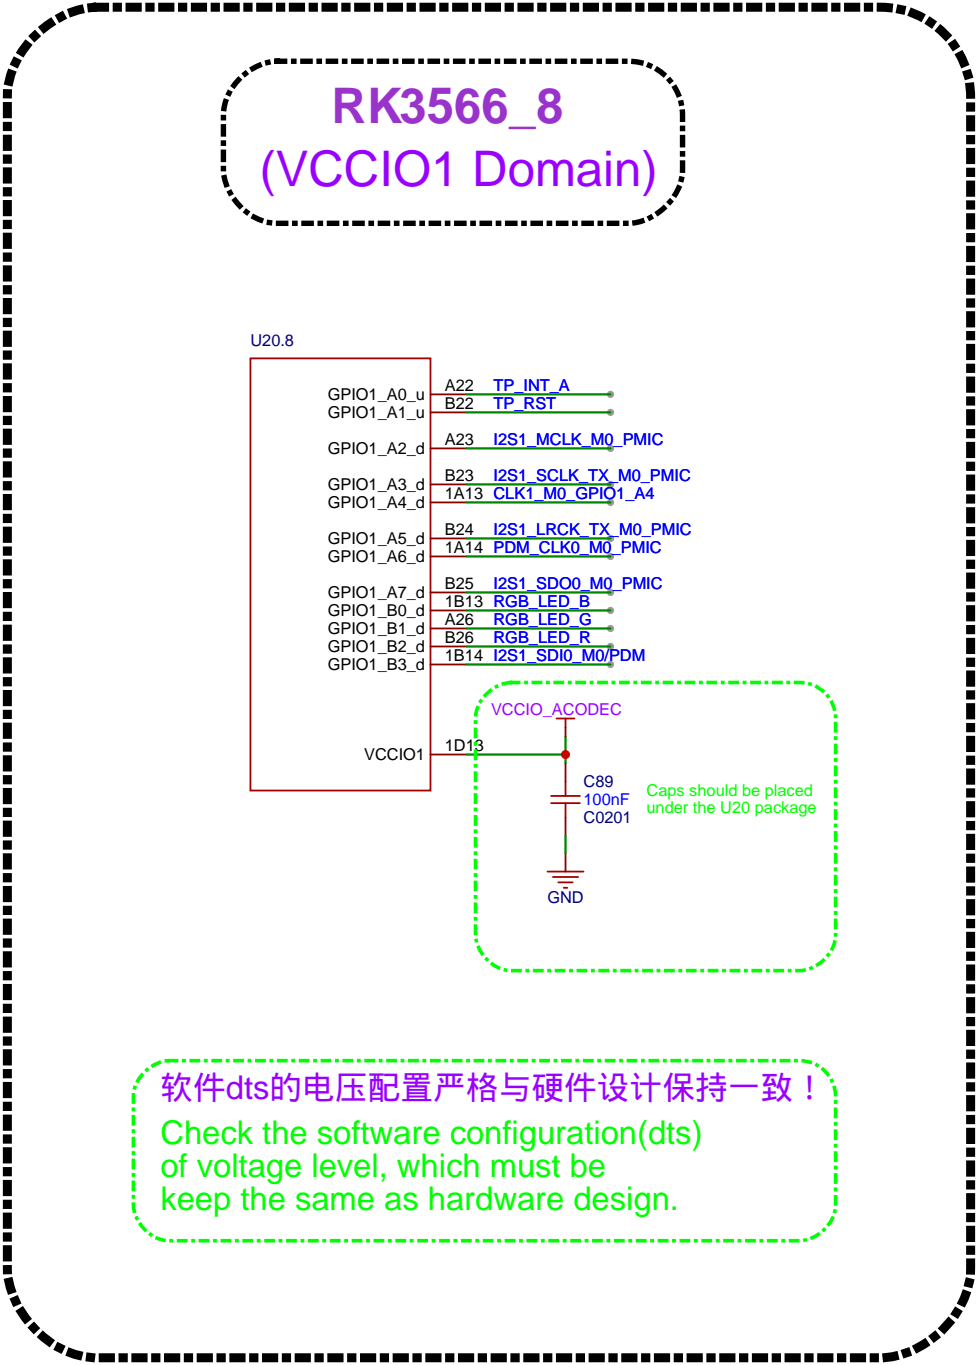
[picture p99: figure]
GPIO1_A0_u A22 GPIO1_A1_u B22; GPIO1_A2_d A23; GPIO1_A3_d B23 GPIO1_A4_d 1A13; GPIO1_A5_d B24 GPIO1_A6_d 1A14; GPIO1_A7_d B25 GPIO1_B0_d 1B13 GPIO1_B1_d A26 GPIO1_B2_d B26 GPIO1_B3_d 1B14; VCCIO1 1D13; VCCIO_ACODEC; CLK1_M0_GPIO1_A4; RGB_LED_R; RGB_LED_G; RGB_LED_B; I2S1_MCLK_M0_PMIC; I2S1_SCLK_TX_M0_PMIC; I2S1_LRCK_TX_M0_PMIC PDM_CLK0_M0_PMIC; I2S1_SDO0_M0_PMIC; I2S1_SDI0_M0/PDM; TP_INT_A TP_RST; 软件dts的电压配置严格与硬件设计保持一致！ Check the software configuration(dts) of voltage level, which must be keep the same as hardware design.; (VCCIO1 Domain); GND; Caps should be placed under the U20 package

# VCC 5-18V宽电压_DCIN 转 VCC_5V

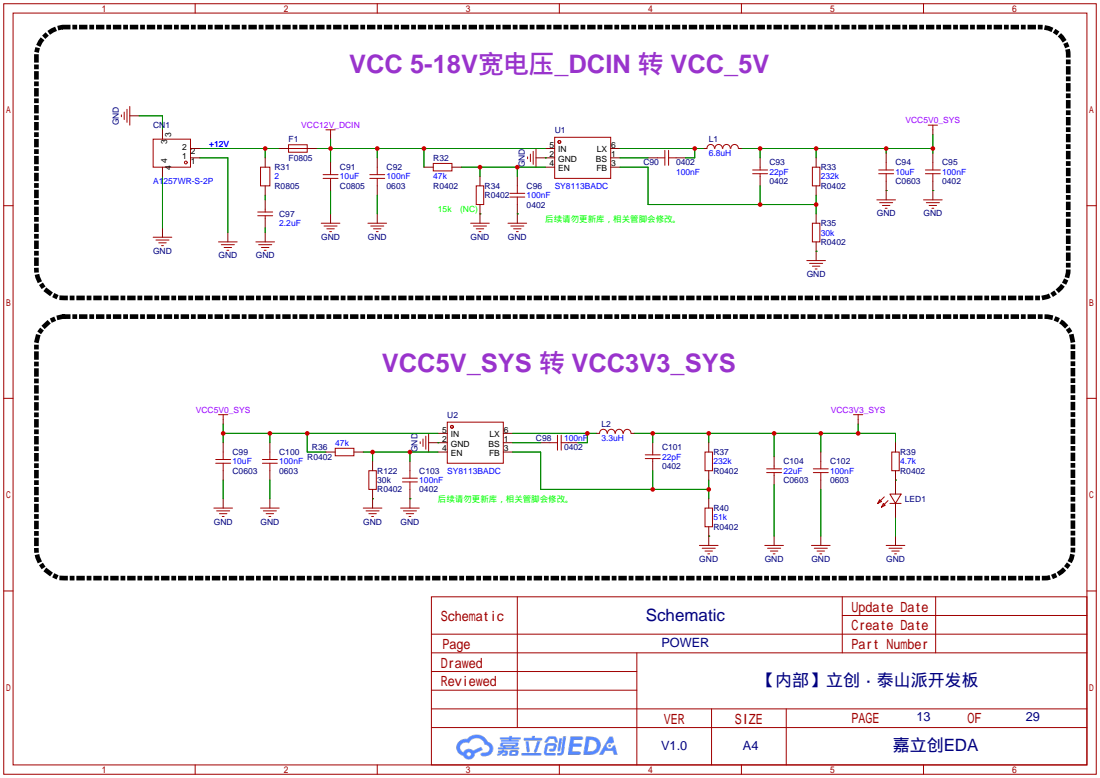
[picture p100: page 13]

# VDD_LOGIC VDD_LOGIC

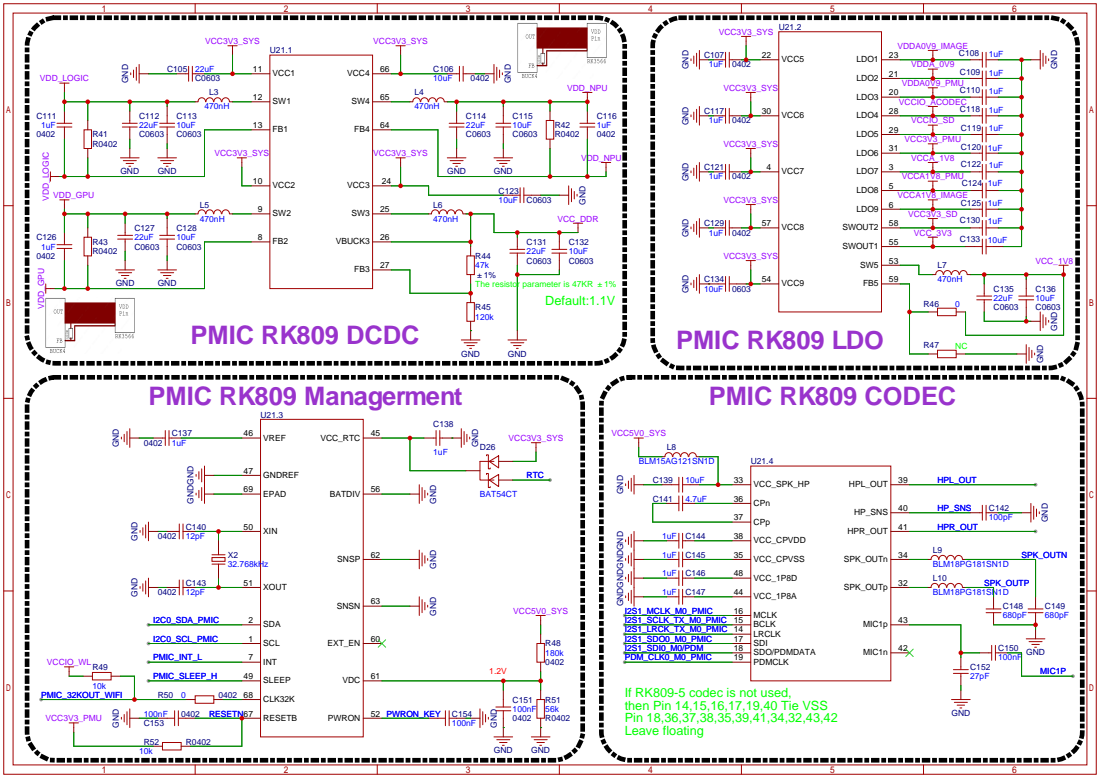
[picture p101: page 14]

GND GND GND GND GND

If RK809-5 codec is not used,
then Pin 14,15,16,17,19,40 Tie VSS
Pin 18,36,37,38,35,39,41,34,32,43,42
Leave floating

# VDD_CPU_EXT

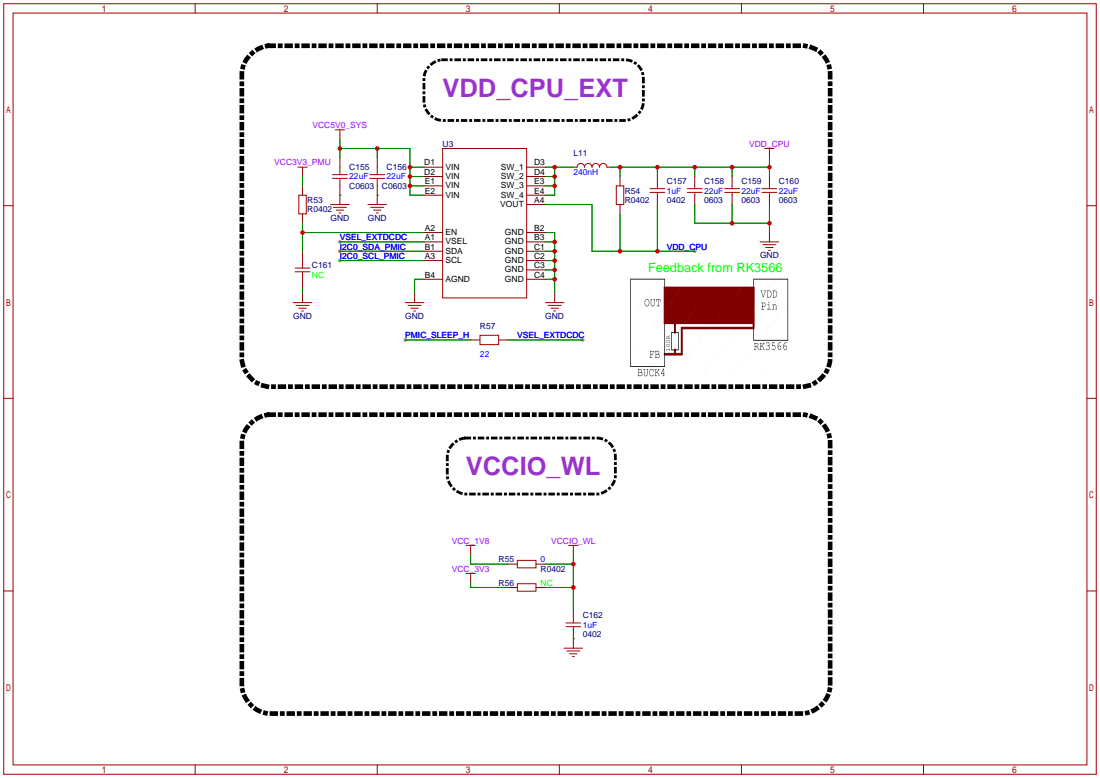
[picture p102: page 15]

## Option1

## Option2

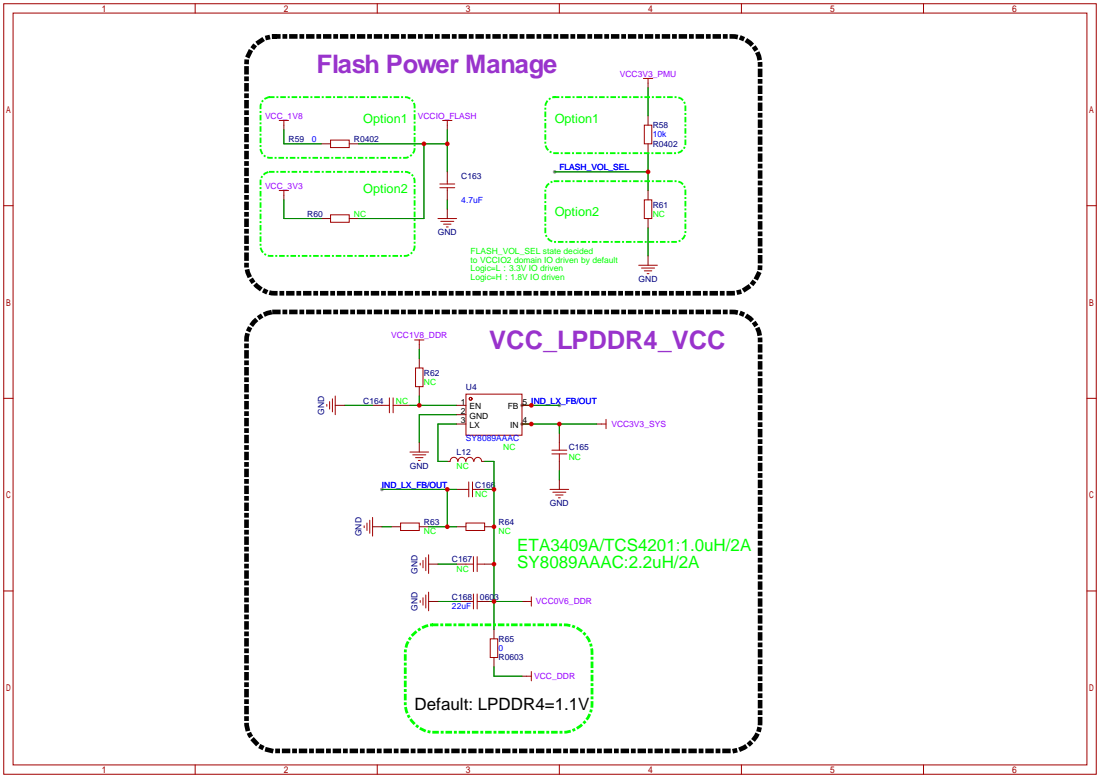
[picture p103: page 16]

GND
FLASH_VOL_SEL state decided
to VCCIO2 domain IO driven by default
Logic=L：3.3V IO driven
VCC_LPDDR4_VCC

# 5V POWER IN

# OTG_VBUSDET

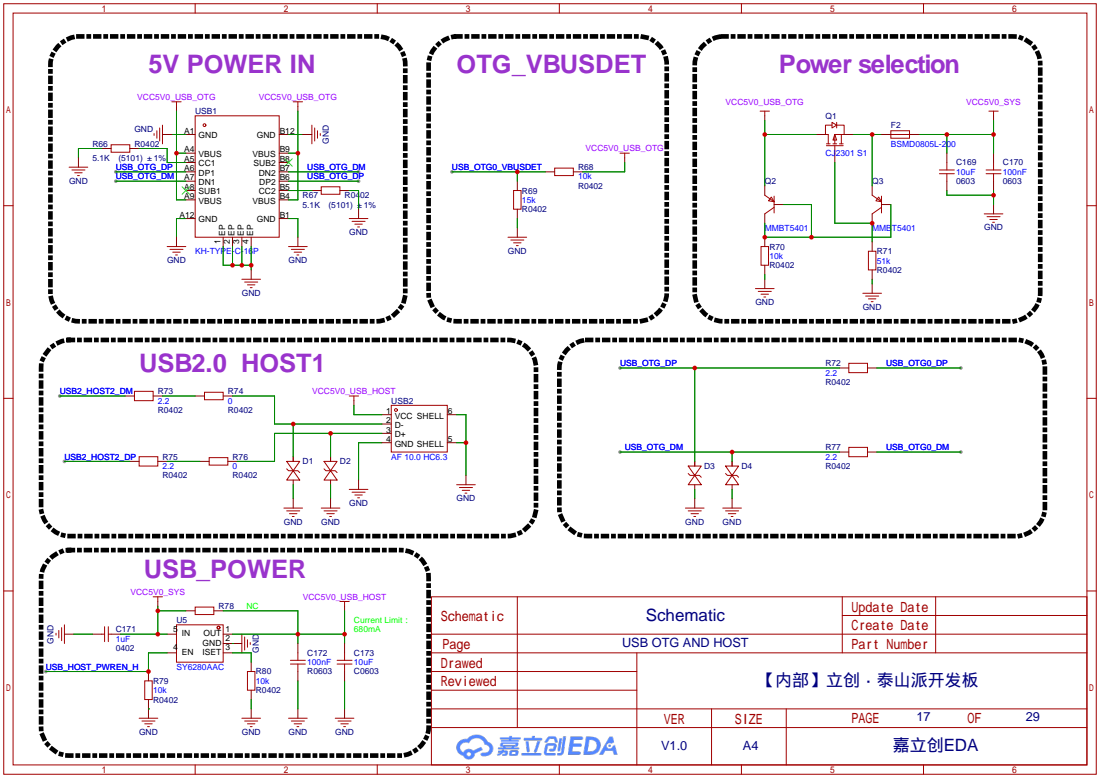
[picture p104: page 17]

Schematic
USB OTG AND HOST

# LPDDR4 200B 1x32bit

VDD2_24 AB9 VDD2_23 AB4 VDD2_22 U8 VDD2_21 U5 VDD2_20 R12 VDD2_19 R8 VDD2_18 R5 VDD2_17 R1 VDD2_16 N12 VDD2_15 N10 VDD2_14 N3 VDD2_13 N1 VDD2_12 K12 VDD2_11 K10 VDD2_10 K3 VDD2_9 K1 VDD2_8 H12 VDD2_7 H8 VDD2_6 H5 VDD2_5 H1 VDD2_4 F8 VDD2_3 F5 VDD2_2 A9 VDD2_1 A4

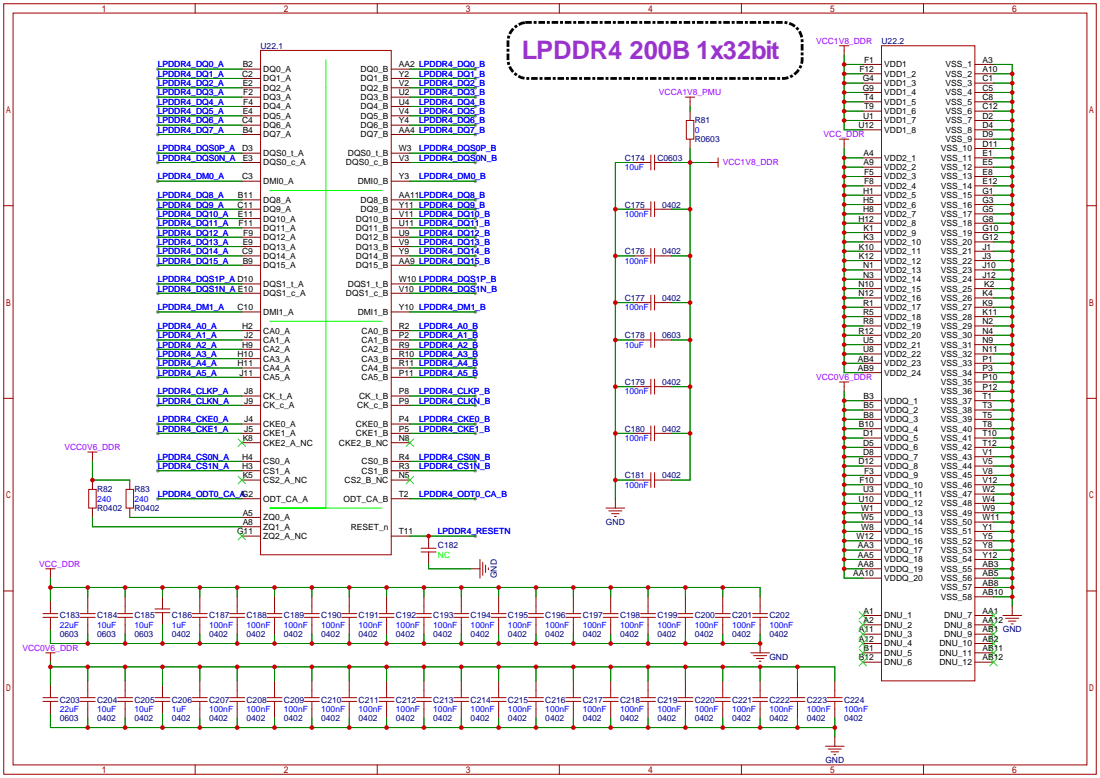
[picture p105: page 18]

# EMMC

NC G14 NC H1 NC H2 NC H3 DataStrobe H5 VSS H10 NC H12 NC H13 NC H14 NC J1 NC J2 NC J3 VSS J5 VDDF J10 NC J12 NC J13 NC J14 NC K1 NC K2 NC K3 RSTN K5 RFU K6 RFU K7 VSS K8 VDDF K9 RFU K10 NC K12 NC K13 NC K14 NC L1 NC L2 NC L3 NC L12 NC L13 NC L14 NC M1 NC M2 NC M3 VDD M4 CMD M5 CLK M6 NC M7 NC M8 NC M9 NC M10 NC M11 NC M12 NC M13 NC M14 NC N1 VSS N2 NC N3 VDD N4 VSS N5 NC N6 NC N7 NC N8 NC N9 NC N10 NC N11 NC N12 NC N13 NC N14 NC P1

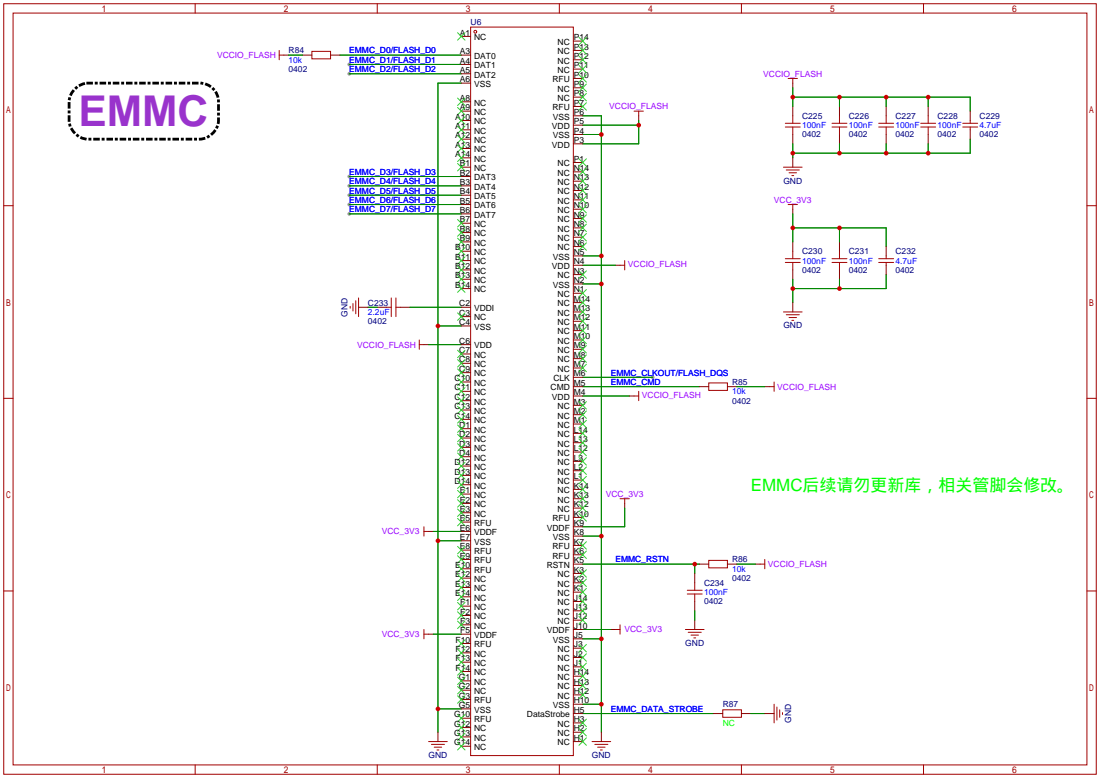
[picture p106: page 19]

VDD P3 VSS P4 VDD P5 VSS P6 RFU P7 NC P8 NC P9 RFU P10 NC P11 NC P12 NC P13 NC P14

# Debug

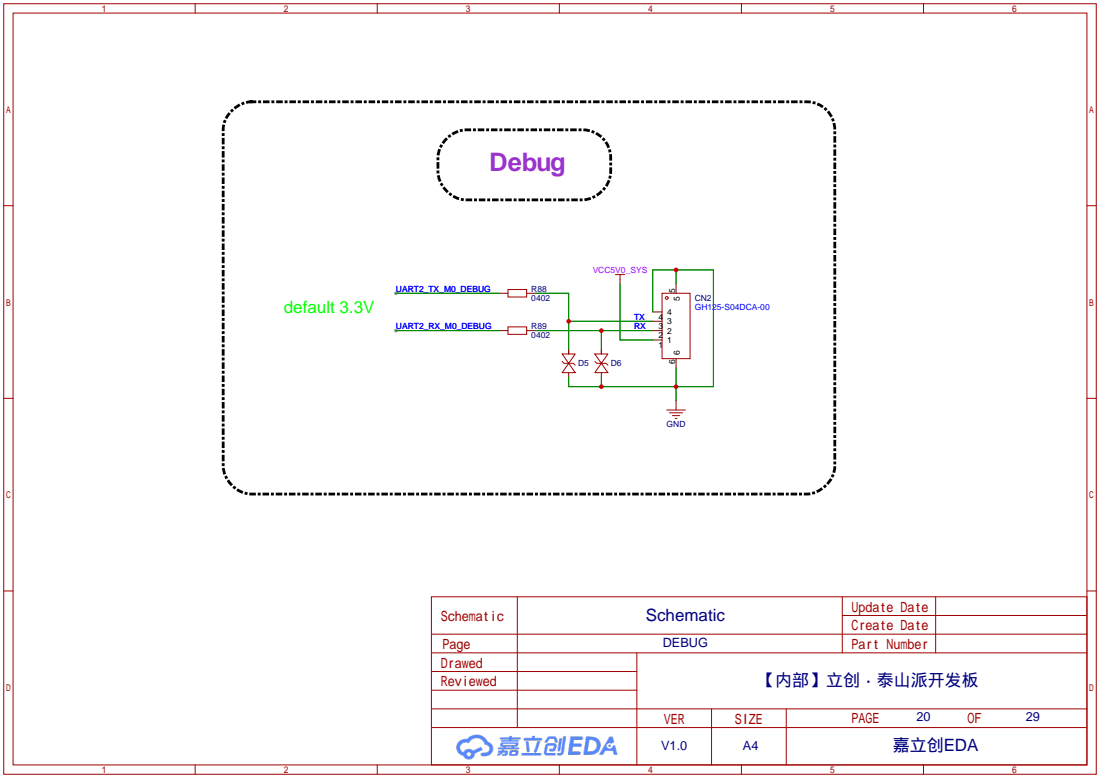
[picture p107: page 20]

# MIPI Camera (MIPI_CSI_RX 4lanes)

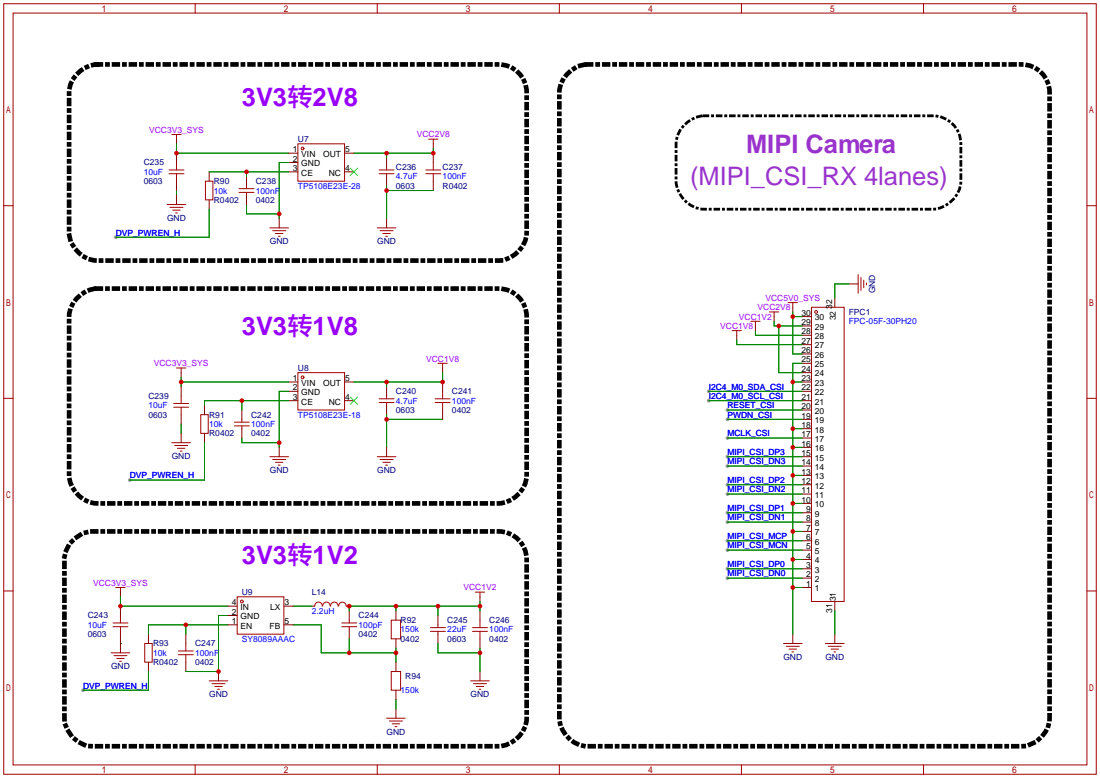
[picture p108: page 21]

VCC5V0_SYS | LCM_MIPI_DSI_Panel

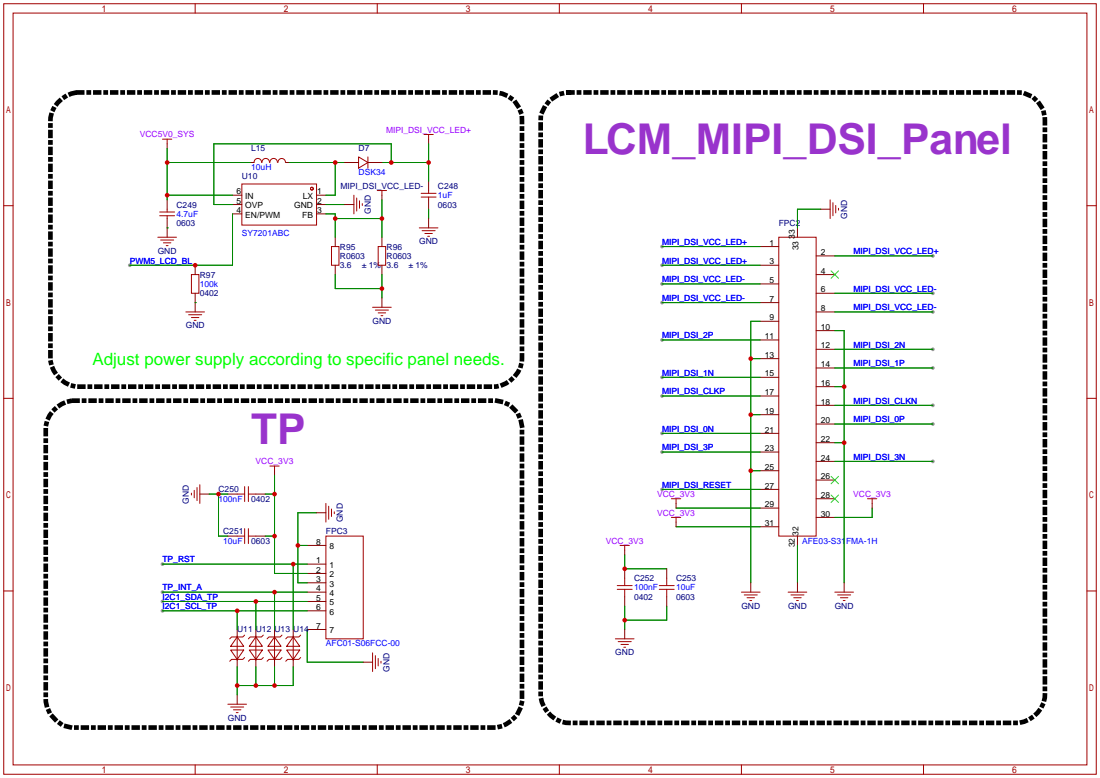
[picture p109: page 22]

Adjust power supply according to specific panel needs.

# micro HDMI

# HDMI_TX_HPD

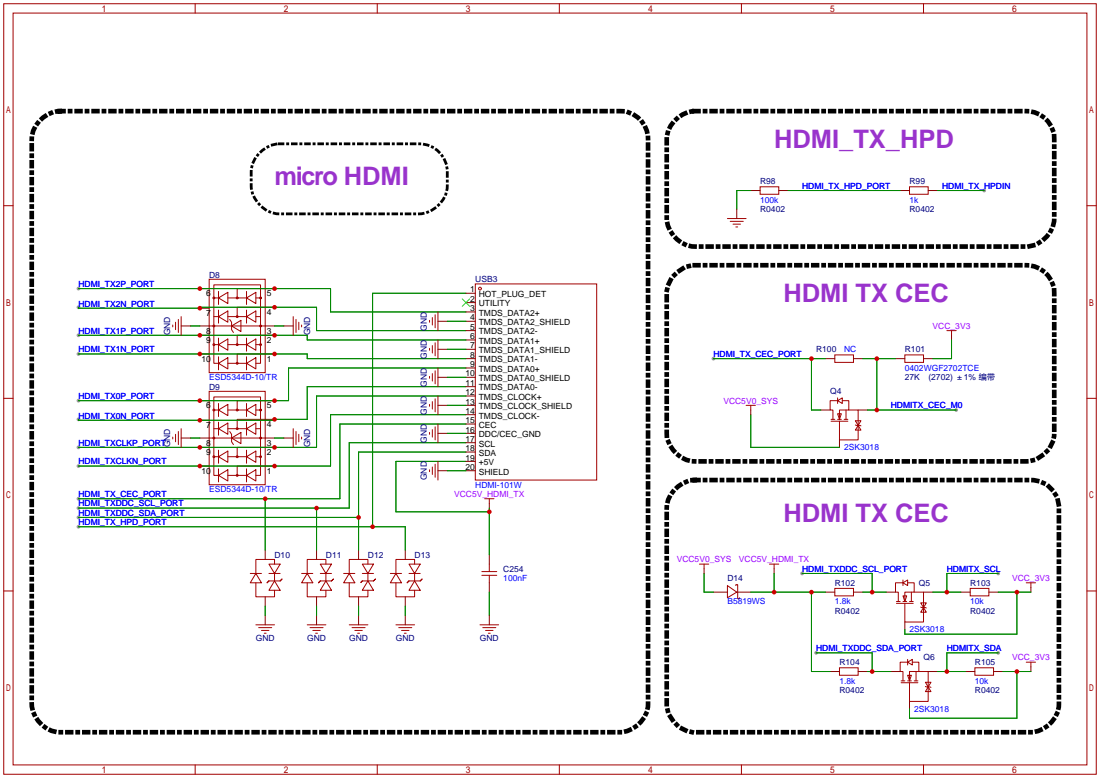
[picture p110: page 23]

# EDP_Panel

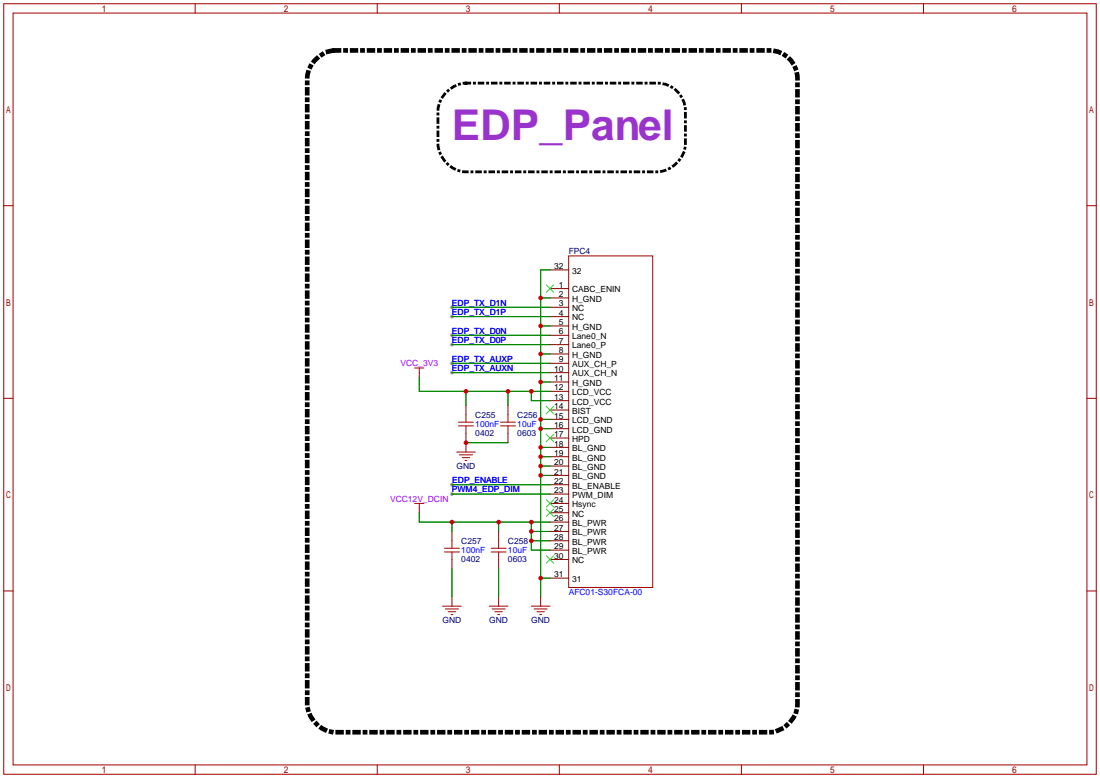
[picture p111: page 24]

# SDIO WIFI/BT

# Option1

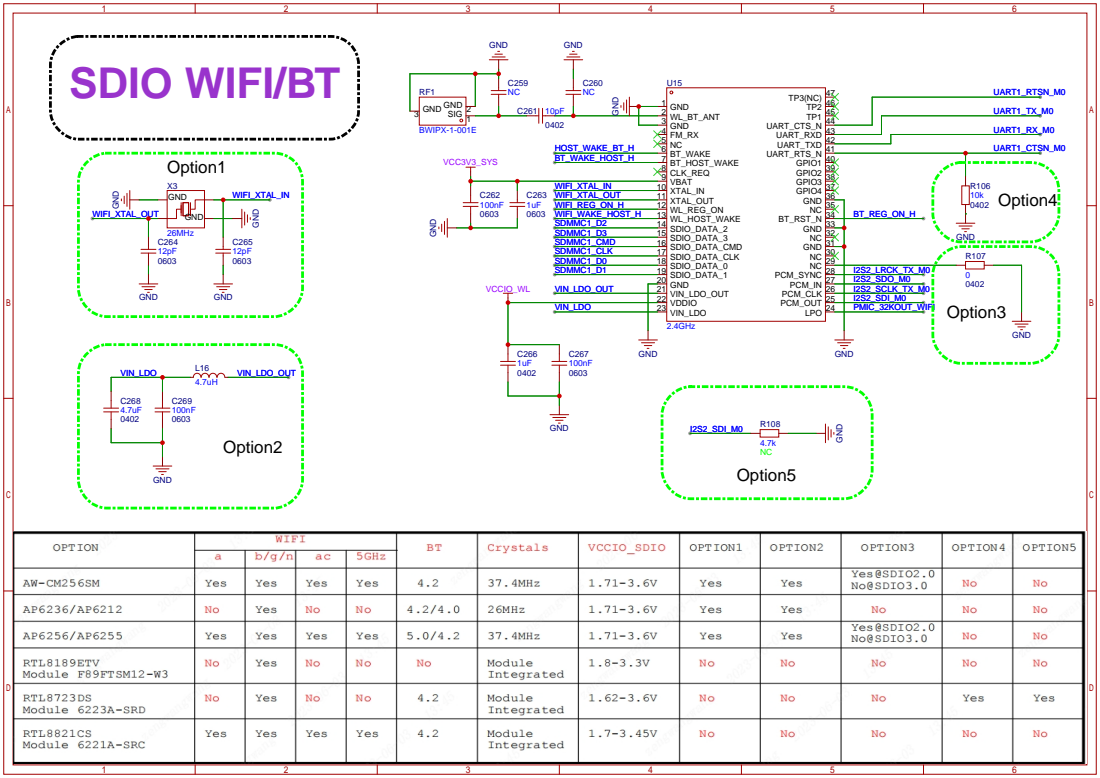
[picture p112: page 25]

# MicroSD Card

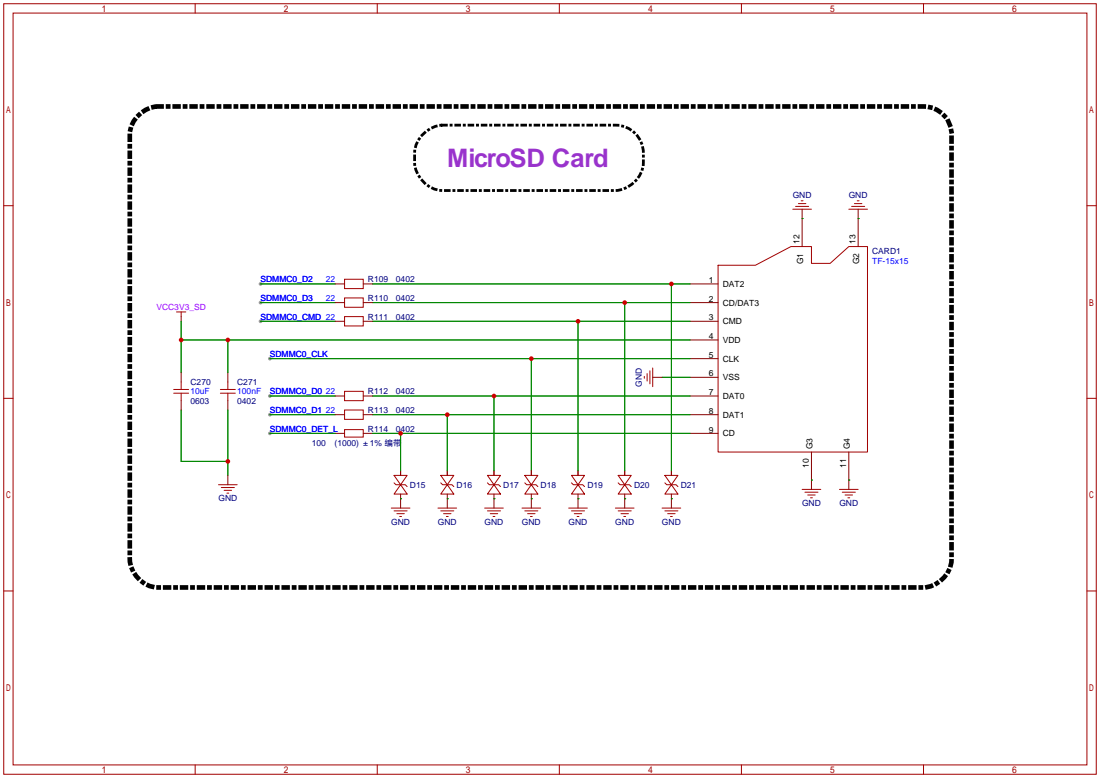
[picture p113: page 26]

# AUDIO

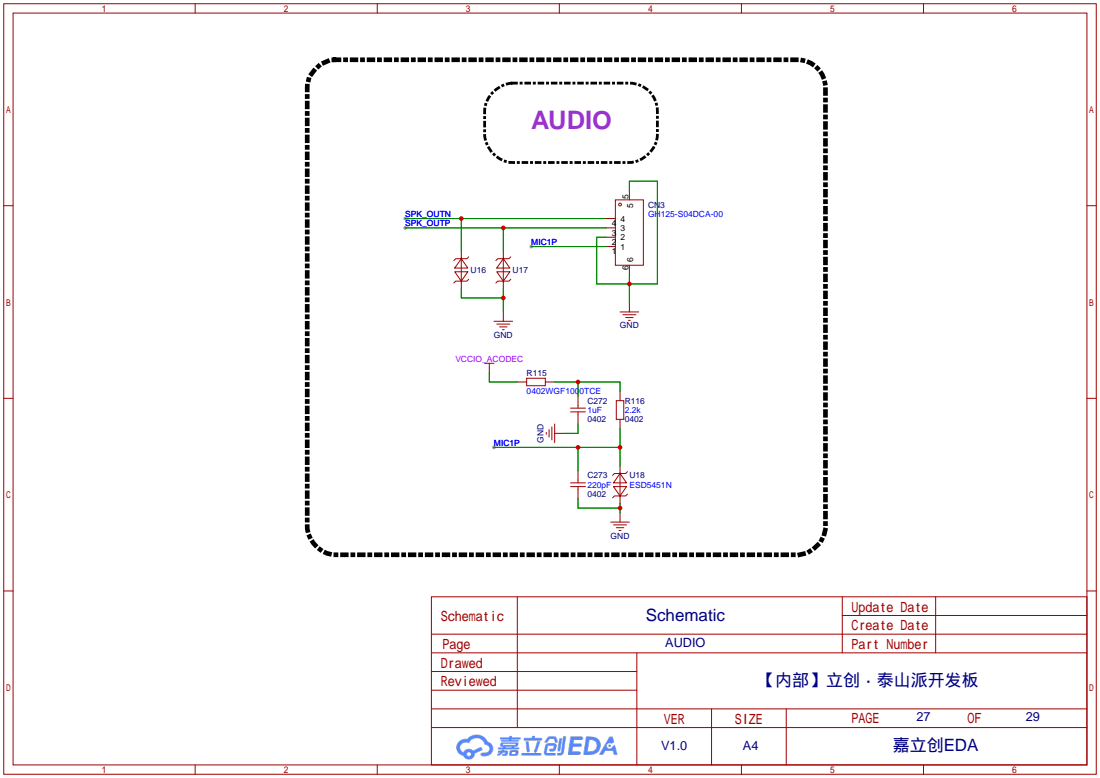
[picture p114: page 27]

KEY | GPIO-40 | RGB

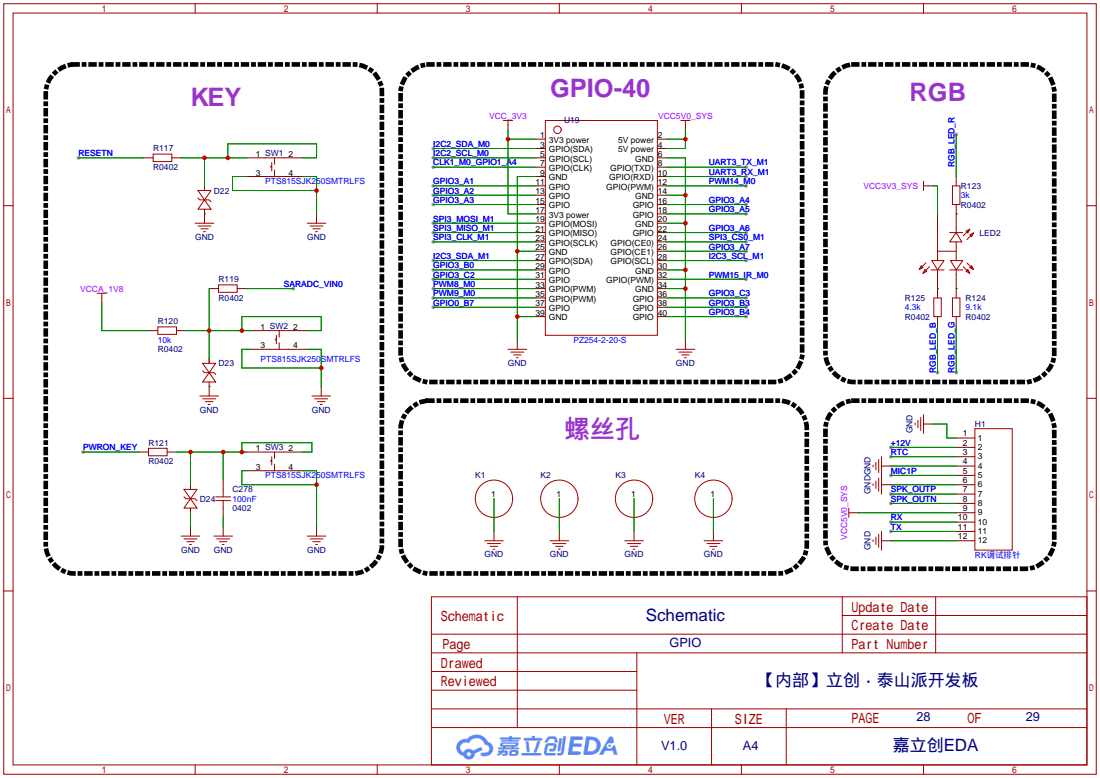
[picture p115: page 28]

# EXP

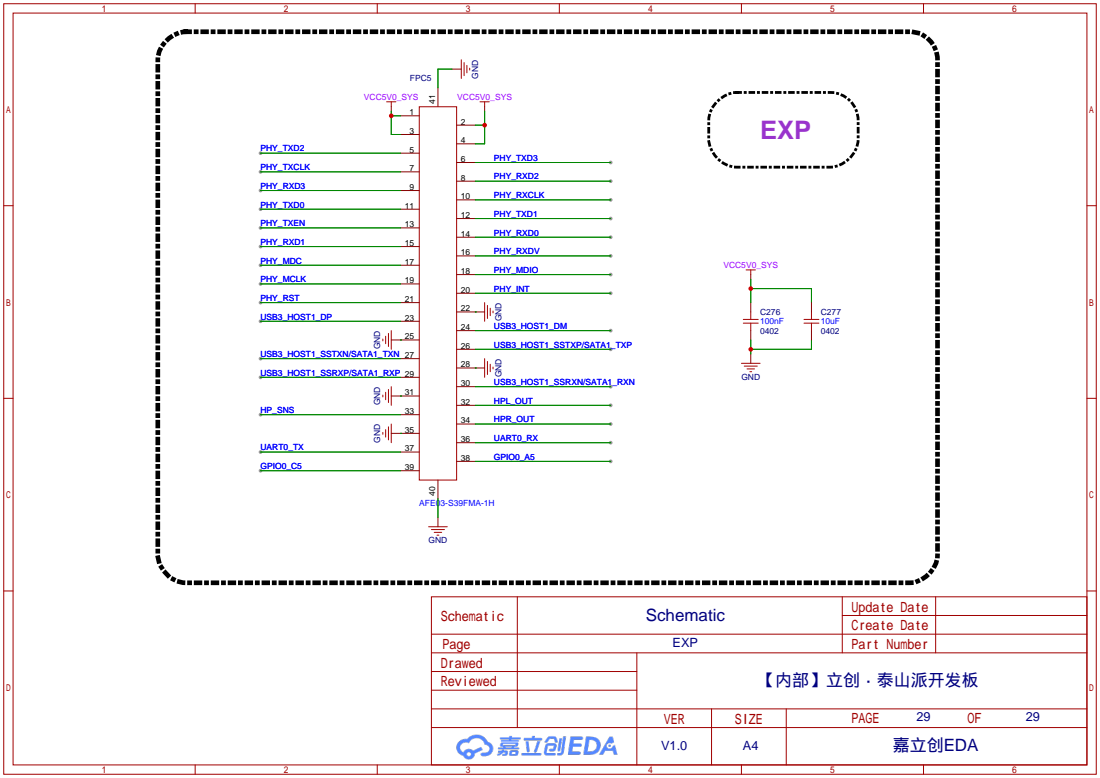
[picture p116: page 29]
