qyxbs/smart-library-return-system/(commit log)

2026-11-06 主控侧：C++ 实现（HTTP 服务、SQLite、任务队列、串口、打印、K230 桥接）
    - cpp/：book_server（HTTP :9777）与 k230_bridge 两个进程
    - SQLite 数据层（WAL + busy_timeout），任务队列按优先级串行
    - 串口 termios（UART4/5/9），打印机 CRC-4 + GBK
    - 交叉编译配置 toolchain-aarch64.cmake，单元/端到端测试
    - 主控 README 与开机脚本同步（S99book / S99bridge）
2026-11-06 修复主控契约、桥接协议、部署文档与安全问题
    - 登录接口兼容 {code}/{openid}，返回 token + user（小程序与 HDMI 面板均可登录）
    - token 增加签名校验；ADMIN_PIN 未设置时随机生成并告警；HMI 不再硬编码 PIN
    - 语音代理保留 /api 前缀；语音服务默认 loopback HTTP（VOICE_TLS=1 可启用 HTTPS）
    - 修复 book_index_lite 导入错误（统一 book_index）
    - K230 桥接：解析 BOOK:/CRC4、SHELVE/FETCH 前缀、K2302_HOST 可配置、通知记录；批量上架返回 not_implemented 并隐藏入口
    - 交叉编译 sysroot 可配置并新增 fetch_sysroot.sh；CMake 清理重复目标；e2e 接入 ctest
    - 部署指南按 C++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
    [config.h, generate_diagrams.py, main_server.cpp]
2026-11-06 S99a-voice 注释与默认协议一致
2026-11-07 统一源文件与文档中的实现描述
    - http.cpp / http.h 文件头改为模块名 + 职责
    - CMake 与测试注释改为中性表述
2026-11-07 精简源码注释
    仅保留文件职责与必要约束/单位说明，删除讲解性内容。
2026-11-07 进一步精简 CMake 注释
2026-11-07 移除未使用的语音模块与 PDM 参考文件
    - 删除 search_fallback.py（Serper 兜底已停用，无引用）
    - 删除 llm_engine.py（仅注释提及，无代码引用）
    - 删除 pdm-mic-combined.dts（PDM 麦克风方案已废弃）
    - 同步更新 README 设备清单
